surynek/RR1/rev.2/CAD/Auxiliaries/T-hold_mini.FCStd

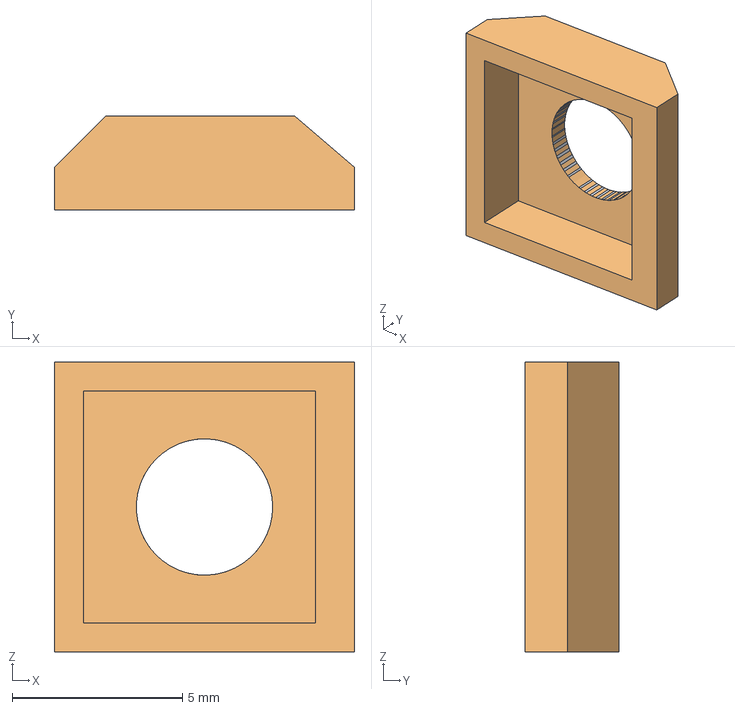
[picture p1: CAD file, 2023-12-17]
rev.2/CAD/Auxiliaries/T-hold_mini.FCStd
8.80 x 2.75 x 8.50 mm
T-hold_mini
T-hold_mini (Meshed)
