surynek/RR1/rev.2/CAD/Base/Base-part-B_seal.FCStd

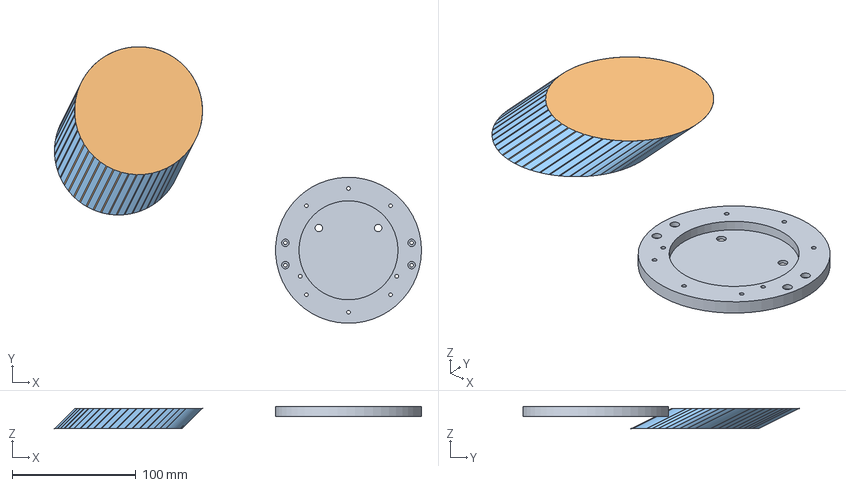
[picture p2: CAD file, 2023-12-17]
rev.2/CAD/Base/Base-part-B_seal.FCStd
296.6 x 223.5 x 18.0 mm
bazovina_part-B_vicko
Extrude (Meshed)
