surynek/RR1/rev.2/CAD/Electric/Real-Box_logo.FCStd

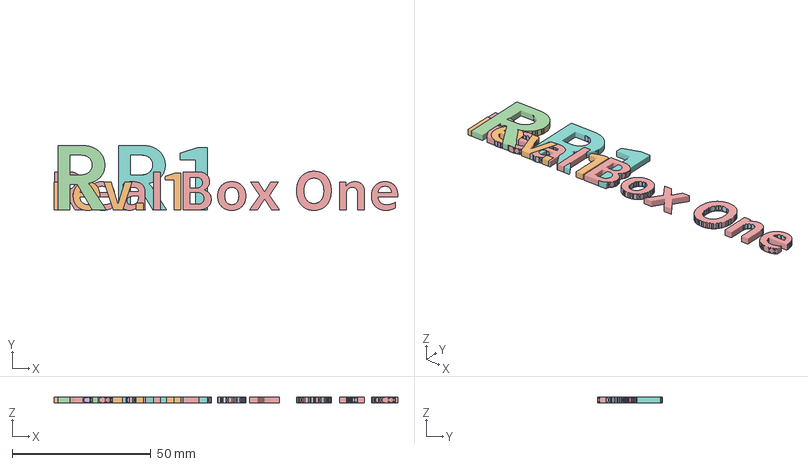
[picture p3: CAD file, 2023-12-17]
rev.2/CAD/Electric/Real-Box_logo.FCStd
124.0 x 23.4 x 2.00 mm
RealBoxOne
rev.1
RR1
R
RealBoxOne (Meshed)
rev.1 (Meshed)
R (Meshed)
RR1 (Meshed)
