surynek/RR1/rev.2/CAD/Gripper/Grip_teeth.FCStd

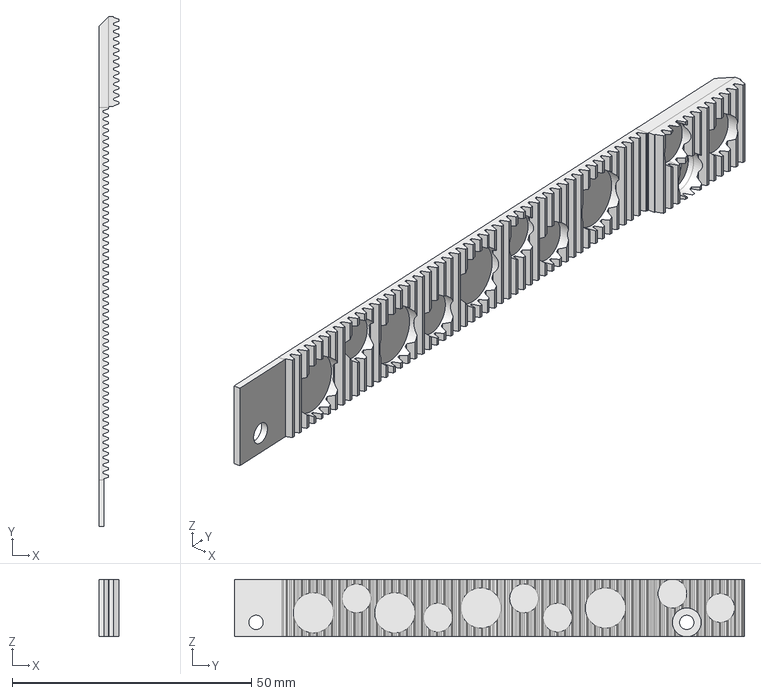
[picture p4: CAD file, 2023-12-17]
rev.2/CAD/Gripper/Grip_teeth.FCStd
4.12 x 106.6 x 12.0 mm
