surynek/RR1/rev.2/CAD/Joint-elbow/G-midi_inner-gear.FCStd

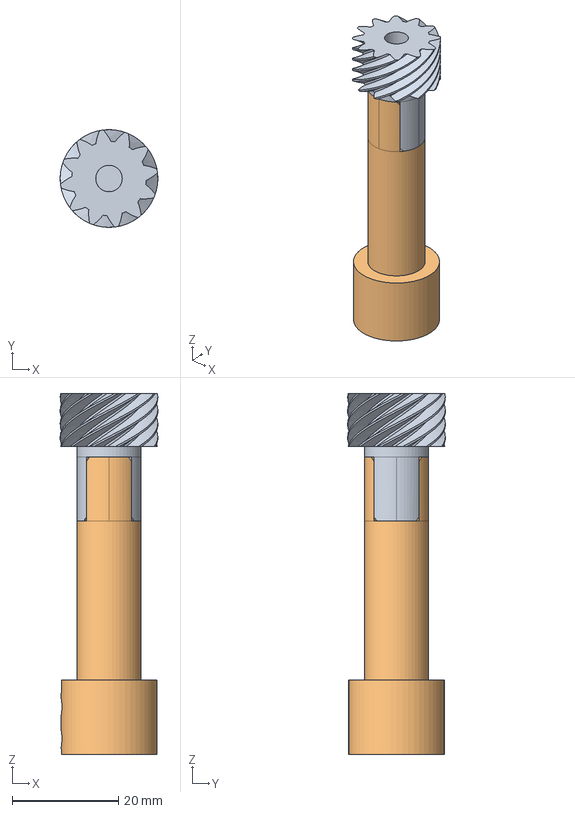
[picture p5: CAD file, 2023-12-17]
rev.2/CAD/Joint-elbow/G-midi_inner-gear.FCStd
18.4 x 18.4 x 68.0 mm
G-midi_inner-gear-part-A
G-midi_inner-gear-part-B_proper-lenght
