surynek/RR1/rev.2/CAD/Wrist/G-mini_encoder-ring.FCStd

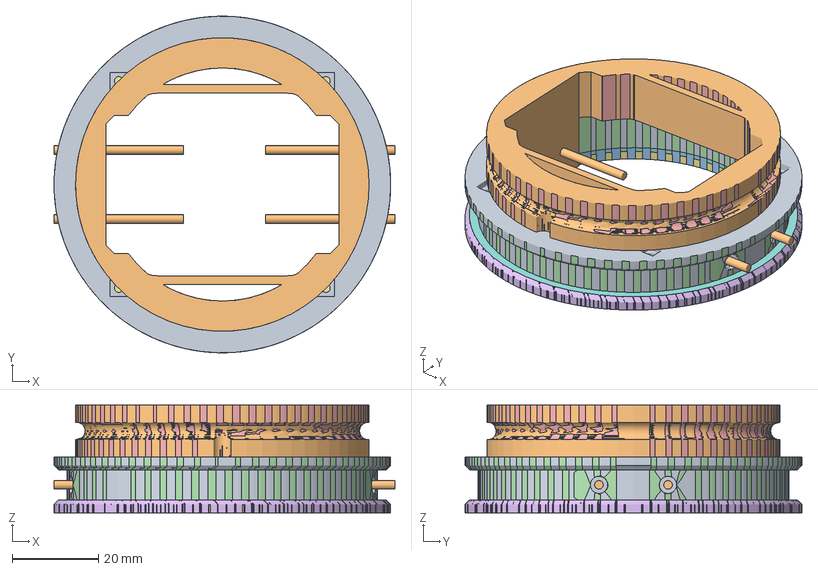
[picture p6: CAD file, 2023-12-17]
rev.2/CAD/Wrist/G-mini_encoder-ring.FCStd
79.0 x 78.0 x 25.0 mm
Wrist_halo-cover
G-mini_encoder-ring-cover
G-mini_encoder-belt-ring
Wrist_inner-halo
G-mini_encoder-ring-cover (Meshed)
Wrist_halo-cover (Meshed)
G-mini_encoder-ring-cover (Meshed)001
G-mini_encoder-belt-ring (Meshed)
Wrist_inner-halo (Meshed)
