surynek/RR1/rev.2/STLs/Base/Base_rear-gear-large-solid.stl

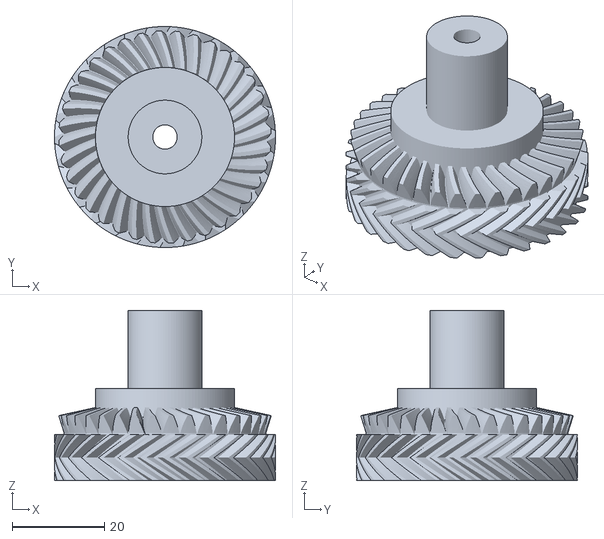
[picture p7: CAD file, 2023-08-20]
rev.2/STLs/Base/Base_rear-gear-large-solid.stl
48.0 x 48.0 x 37.0
