surynek/RR1/rev.2/STLs/Electric/Ele-box_RealRobotONE-cover.stl

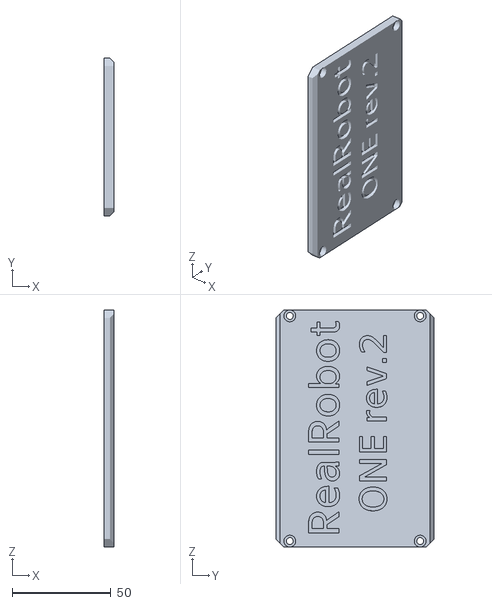
[picture p8: CAD file, 2023-08-21]
rev.2/STLs/Electric/Ele-box_RealRobotONE-cover.stl
5.00 x 80.0 x 120.0
