surynek/RR1/rev.2/STLs/Gripper/Grip_ufo.stl

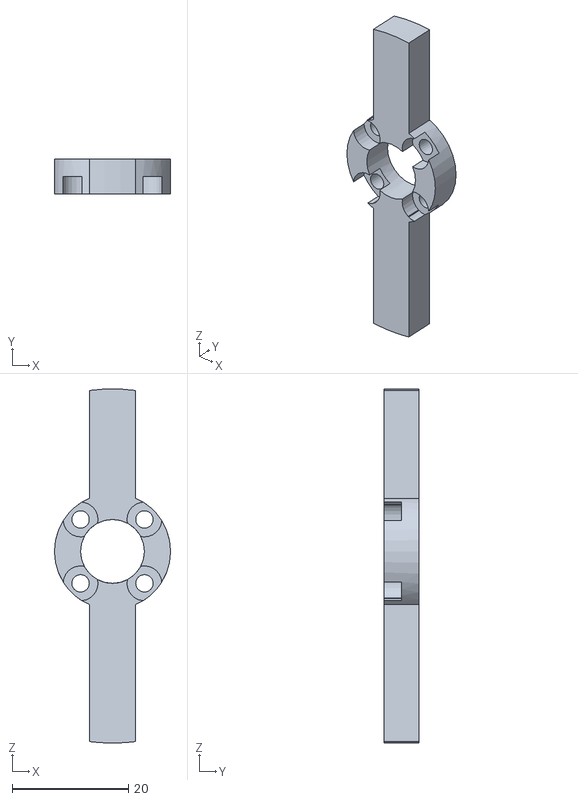
[picture p9: CAD file, 2023-08-21]
rev.2/STLs/Gripper/Grip_ufo.stl
20.0 x 6.00 x 61.0
