surynek/RR1/rev.2/STLs/Joint-elbow/G-midi_bear-hold-encoder-rear.stl

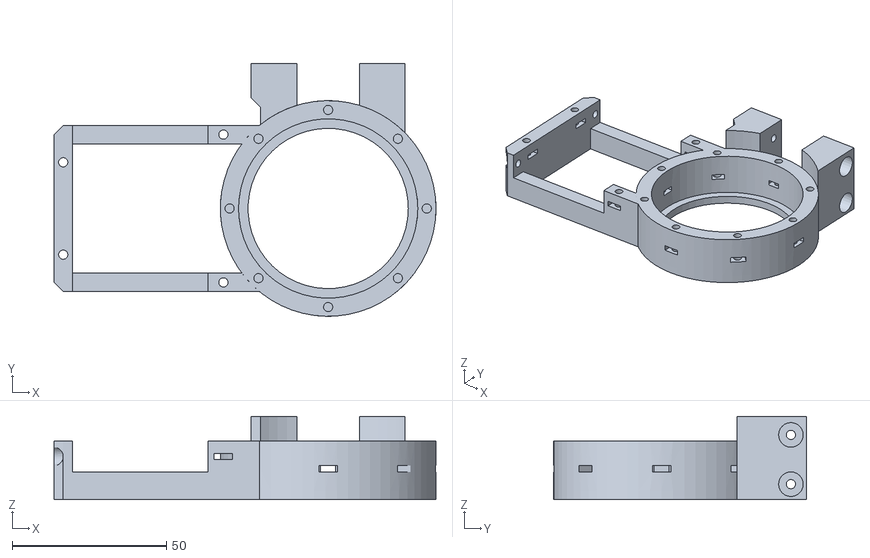
[picture p10: CAD file, 2023-08-21]
rev.2/STLs/Joint-elbow/G-midi_bear-hold-encoder-rear.stl
124.0 x 82.0 x 27.0
