surynek/RR1/rev.2/STLs/Joint-shoulder/J-max_motor-shaft-extended-reinforced.stl

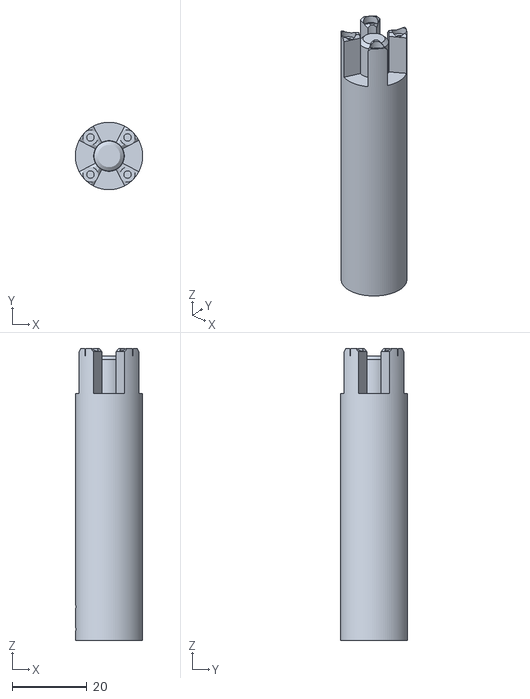
[picture p11: CAD file, 2023-08-20]
rev.2/STLs/Joint-shoulder/J-max_motor-shaft-extended-reinforced.stl
18.0 x 18.0 x 78.0
