surynek/RR1/rev.2/STLs/Link-elbow/L-elb_encoder-uphold.stl

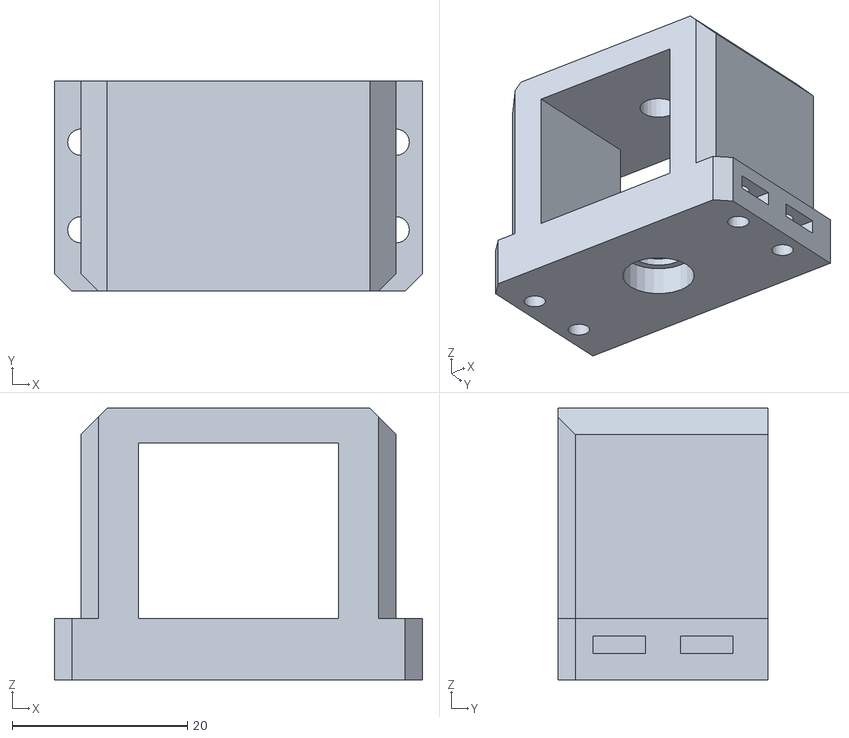
[picture p12: CAD file, 2023-08-21]
rev.2/STLs/Link-elbow/L-elb_encoder-uphold.stl
42.0 x 24.0 x 31.0
