surynek/RR1/rev.2/STLs/Link-upper/T-midi_small-box.stl

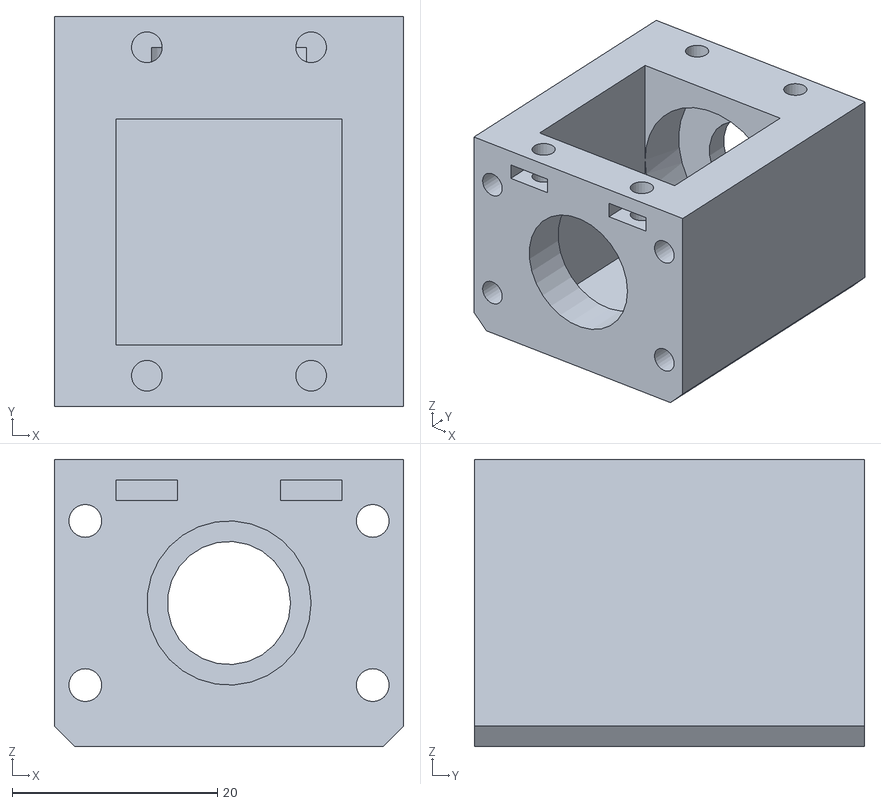
[picture p13: CAD file, 2023-08-20]
rev.2/STLs/Link-upper/T-midi_small-box.stl
34.0 x 38.0 x 28.0
