surynek/RR1/rev.2/STLs/Wrist/G-mini_underfix.stl

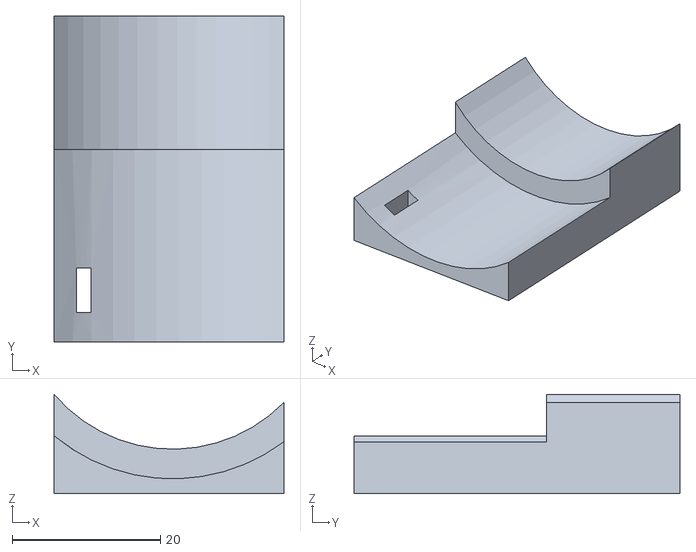
[picture p14: CAD file, 2023-08-21]
rev.2/STLs/Wrist/G-mini_underfix.stl
31.0 x 44.0 x 13.4
