surynek/RR1/rev.2/CAD/Auxiliaries/T-hold_max.FCStd

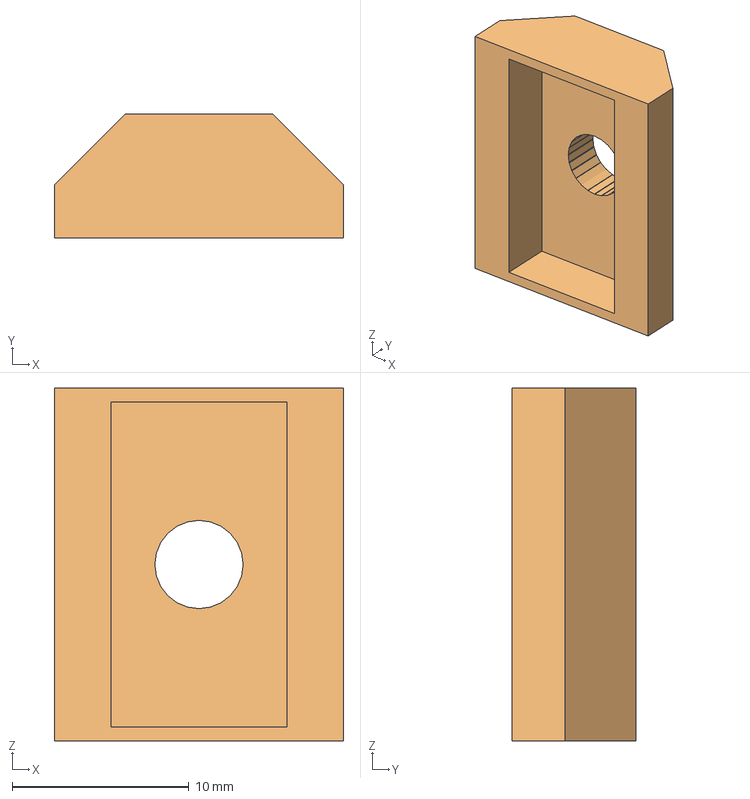
[picture p15: CAD file, 2023-12-17]
rev.2/CAD/Auxiliaries/T-hold_max.FCStd
16.4 x 7.00 x 20.0 mm
T-hold_max
teckovy_bigo_drzacek (Meshed)
T-hold_max (Meshed)
