surynek/RR1/rev.2/CAD/Base/Base-part-J_rear-gearbox-cover.FCStd

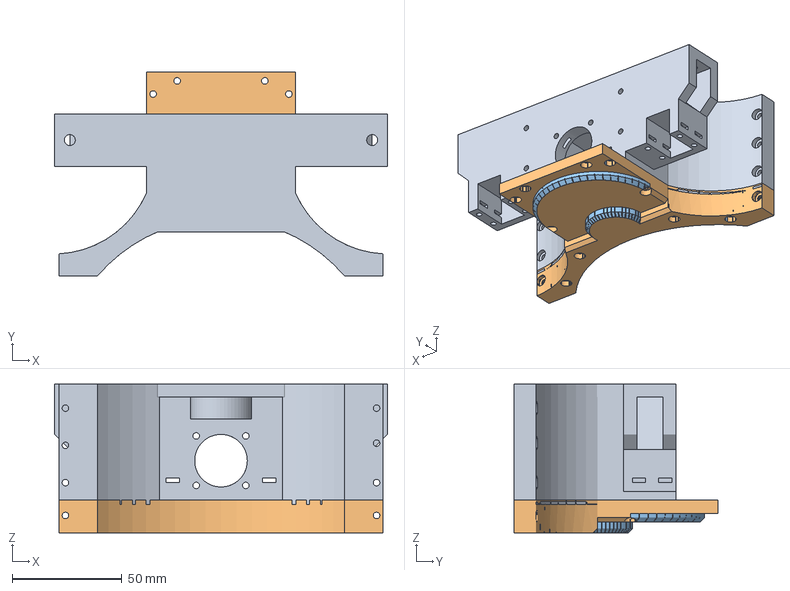
[picture p16: CAD file, 2023-12-17]
rev.2/CAD/Base/Base-part-J_rear-gearbox-cover.FCStd
152.0 x 93.0 x 68.0 mm
Base_rear-gearbox-stabil
Base_rear-gearbox-cover
Base_rear-gearbox-cover (Meshed)
