surynek/RR1/rev.2/CAD/Electric/Gewiss.FCStd

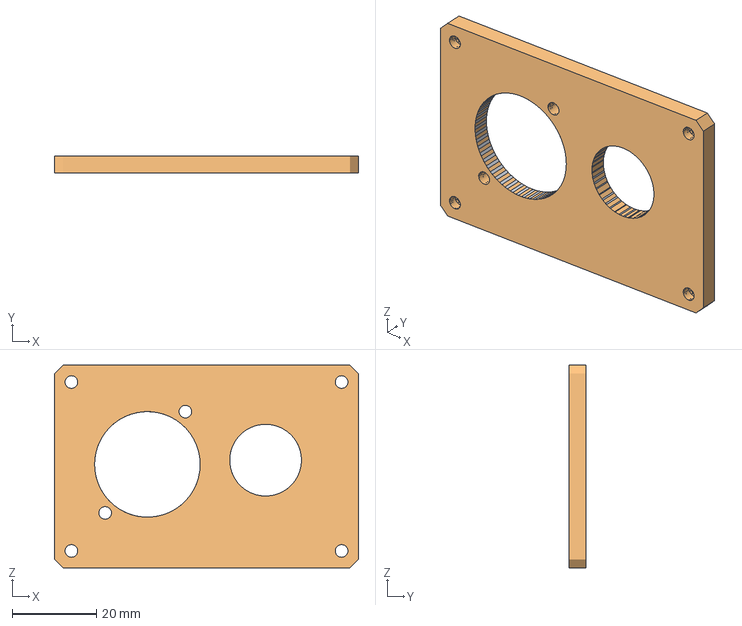
[picture p17: CAD file, 2023-12-17]
rev.2/CAD/Electric/Gewiss.FCStd
72.0 x 4.00 x 48.0 mm
komuno_panel
komuno_panel (Meshed)
