surynek/RR1/rev.2/STLs/Base/Base_rear-gear-small.stl

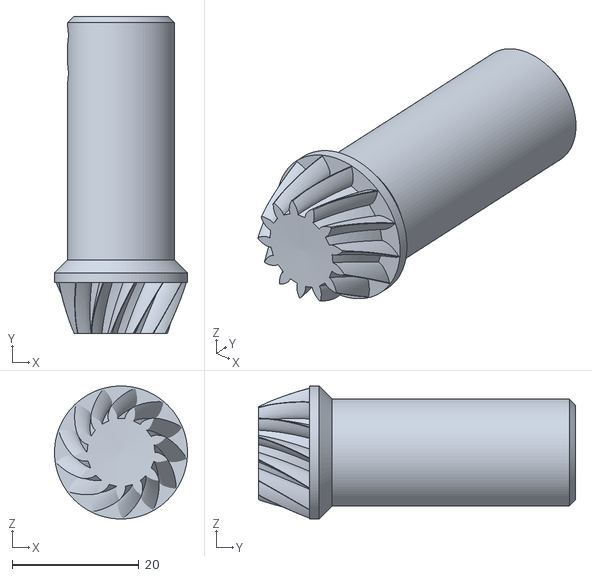
[picture p18: CAD file, 2023-08-20]
rev.2/STLs/Base/Base_rear-gear-small.stl
21.0 x 50.1 x 21.0
