surynek/RR1/rev.2/STLs/Electric/Ele-box_small-cover.stl

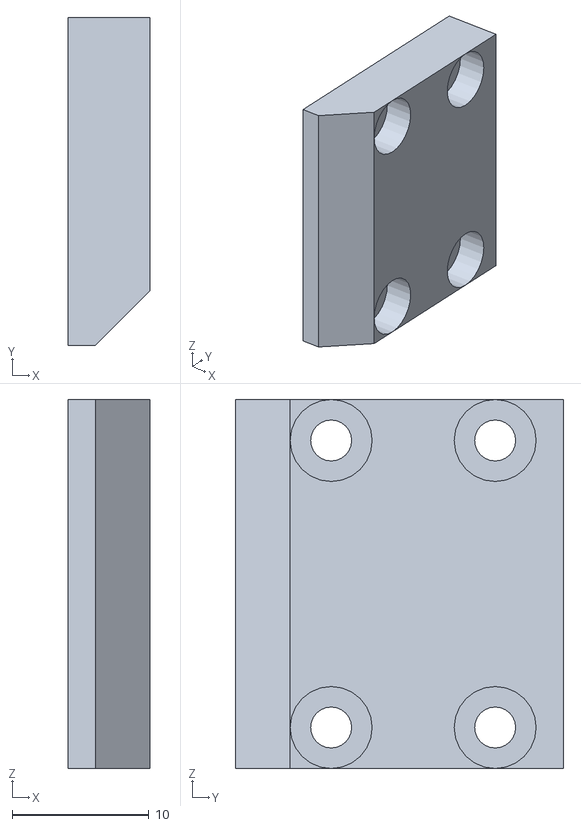
[picture p19: CAD file, 2023-08-21]
rev.2/STLs/Electric/Ele-box_small-cover.stl
6.00 x 24.0 x 27.0
