surynek/RR1/rev.2/STLs/Gripper/Grip_finger-root_lower.stl

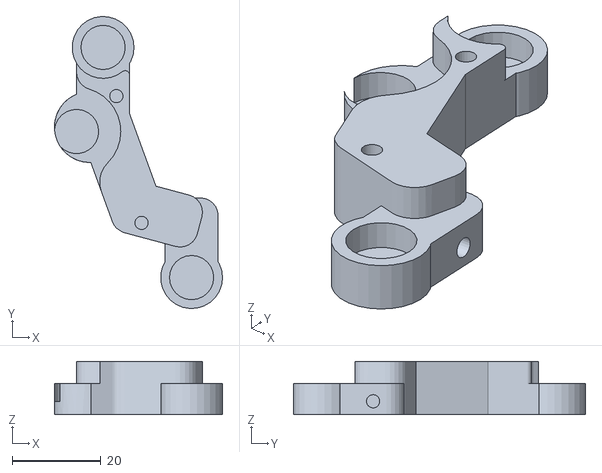
[picture p20: CAD file, 2023-08-21]
rev.2/STLs/Gripper/Grip_finger-root_lower.stl
38.0 x 66.0 x 12.0
