surynek/RR1/rev.2/STLs/Joint-elbow/G-midi_inner-gear-part-B.stl

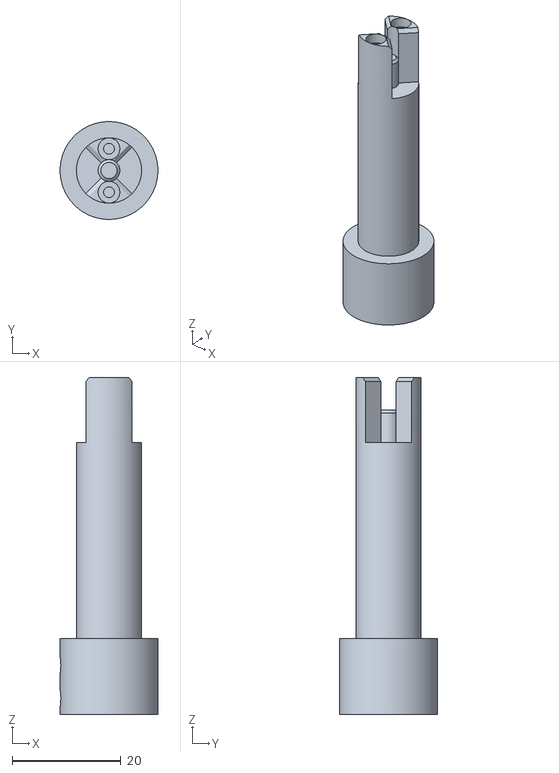
[picture p21: CAD file, 2023-08-21]
rev.2/STLs/Joint-elbow/G-midi_inner-gear-part-B.stl
18.0 x 18.0 x 62.0
