surynek/RR1/rev.2/STLs/Link-elbow/L-elb_encoder-bottomhold.stl

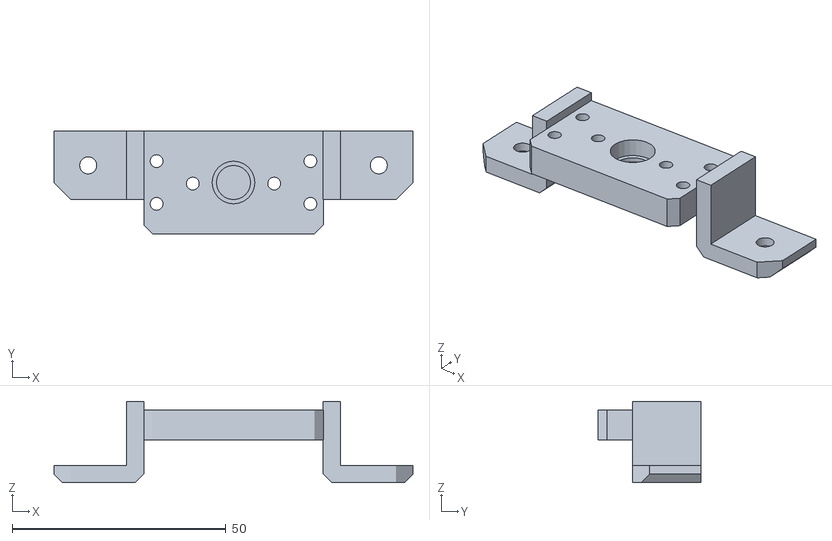
[picture p22: CAD file, 2023-08-21]
rev.2/STLs/Link-elbow/L-elb_encoder-bottomhold.stl
84.0 x 24.0 x 19.0
