surynek/RR1/rev.2/STLs/Link-upper/T-midi-logo_rev.2.stl

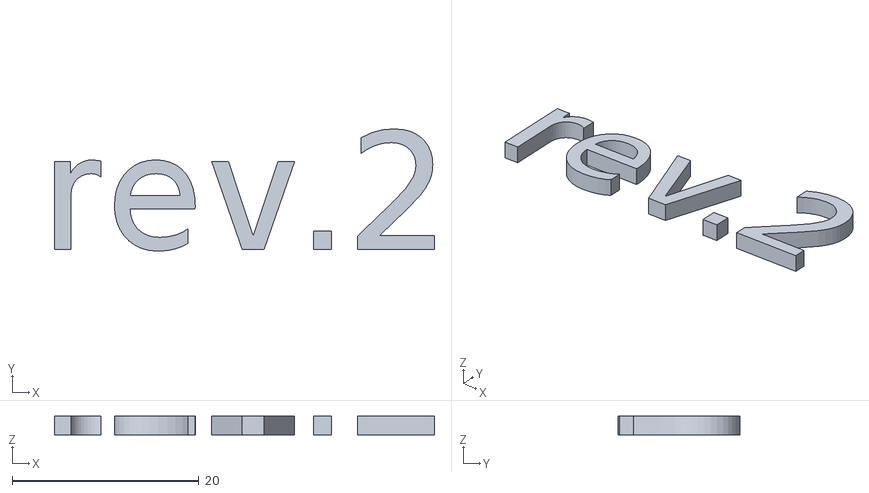
[picture p23: CAD file, 2023-08-20]
rev.2/STLs/Link-upper/T-midi-logo_rev.2.stl
40.7 x 13.1 x 2.00
