surynek/RR1/rev.2/STLs/Wrist/G-mini_inner-gear-part-B.stl

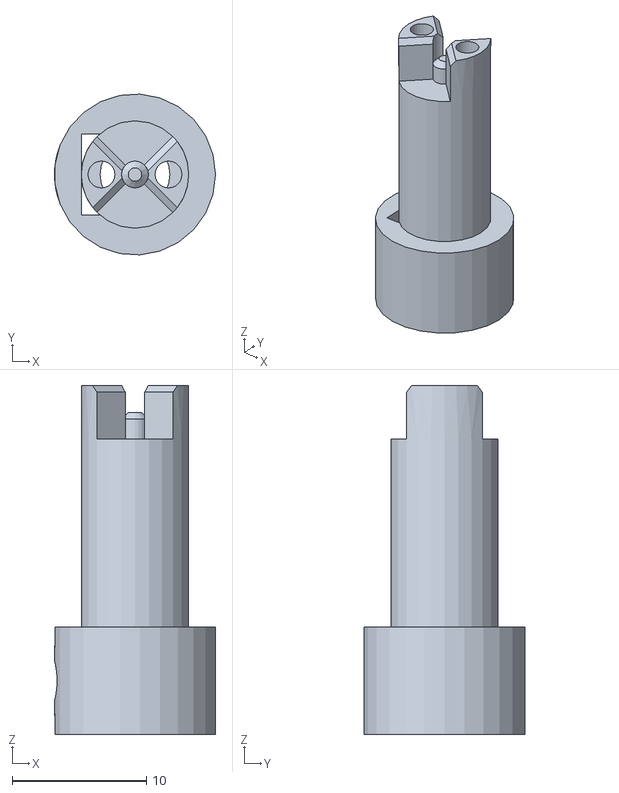
[picture p24: CAD file, 2023-08-21]
rev.2/STLs/Wrist/G-mini_inner-gear-part-B.stl
12.0 x 12.0 x 26.0
