surynek/RR1/rev.2/CAD/Auxiliaries/T-hold_midi.FCStd

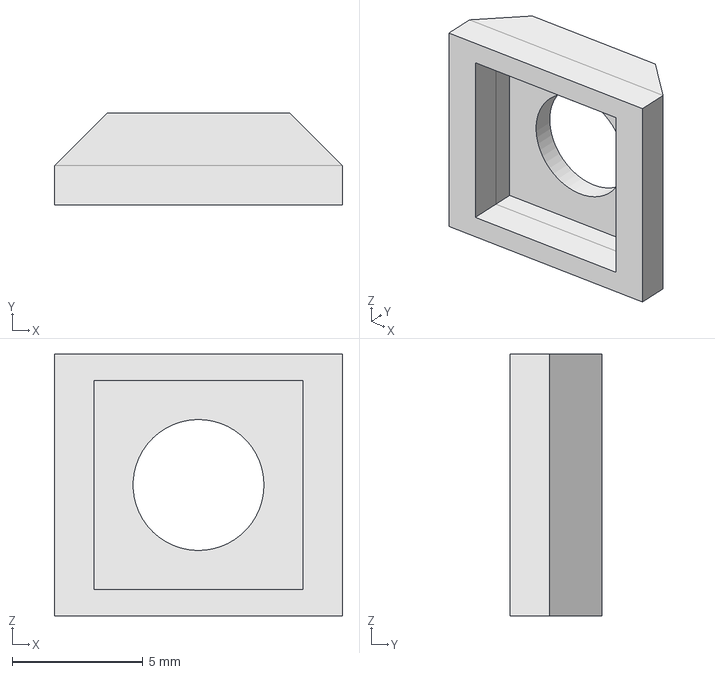
[picture p25: CAD file, 2023-12-17]
rev.2/CAD/Auxiliaries/T-hold_midi.FCStd
11.0 x 3.50 x 10.0 mm
