surynek/RR1/rev.2/CAD/Base/Base-part-G_seal.FCStd

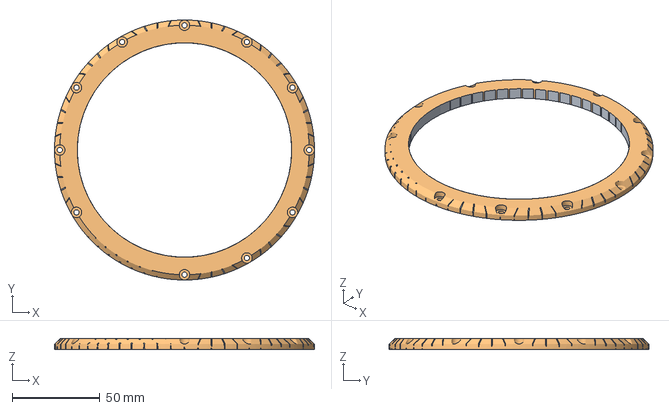
[picture p26: CAD file, 2023-12-17]
rev.2/CAD/Base/Base-part-G_seal.FCStd
148.0 x 148.0 x 6.00 mm
bazovina_part-G_seal
bazovina_part-G_seal (Meshed)
