surynek/RR1/rev.2/STLs/Base/Base_encoder-bottomhold.stl

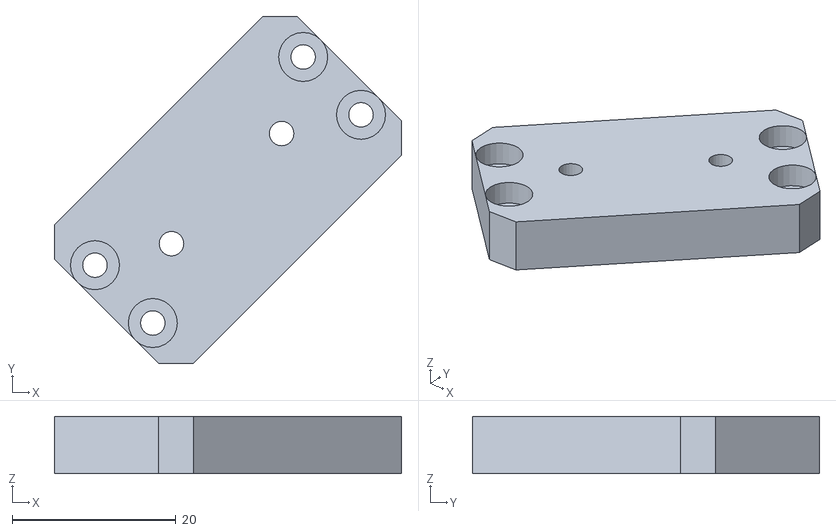
[picture p27: CAD file, 2023-08-20]
rev.2/STLs/Base/Base_encoder-bottomhold.stl
42.4 x 42.4 x 7.00
