surynek/RR1/rev.2/STLs/Electric/Ele-box_big-hold.stl

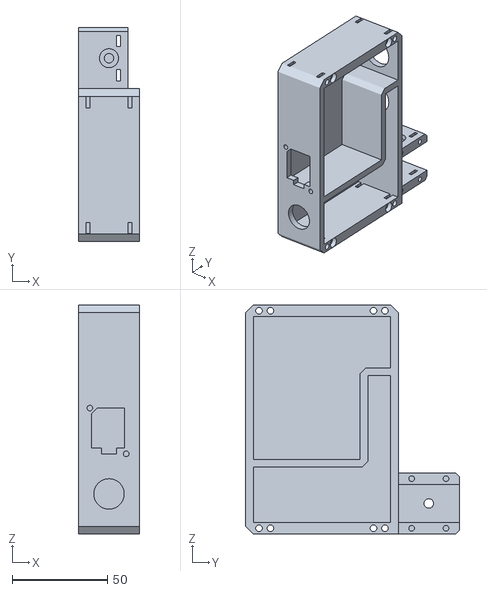
[picture p28: CAD file, 2023-08-21]
rev.2/STLs/Electric/Ele-box_big-hold.stl
32.0 x 112.0 x 120.0
