surynek/RR1/rev.2/STLs/Joint-elbow/G-midi_extrusion-cover-supershift.stl

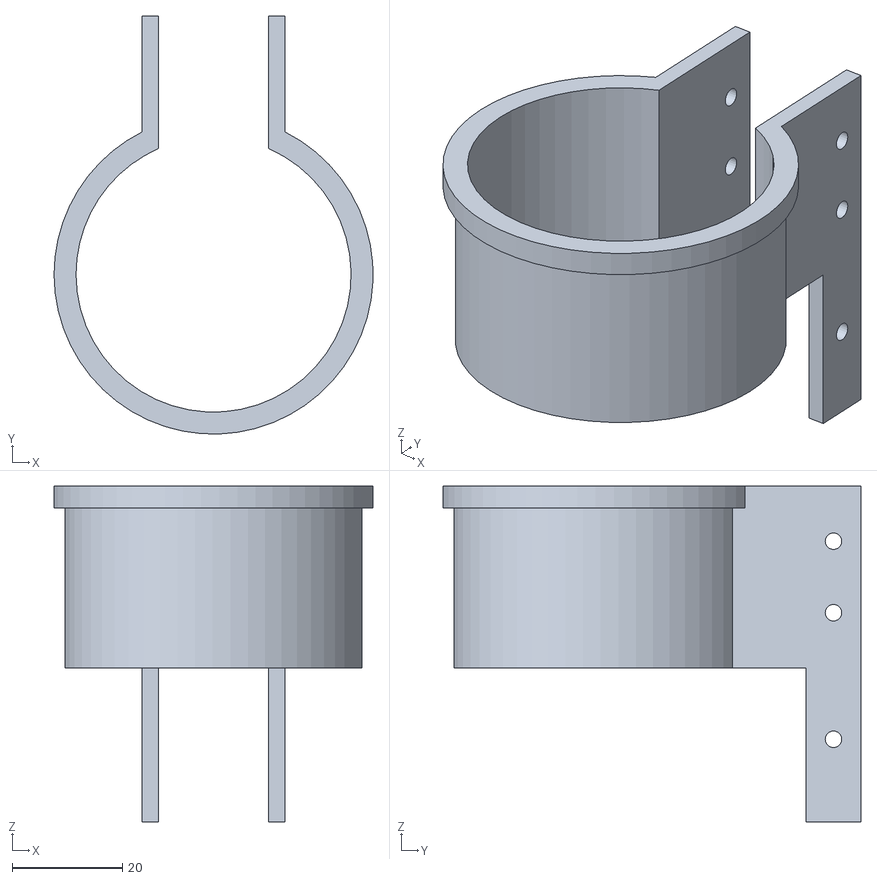
[picture p29: CAD file, 2023-08-21]
rev.2/STLs/Joint-elbow/G-midi_extrusion-cover-supershift.stl
58.0 x 76.0 x 61.0
