surynek/RR1/rev.2/STLs/Joint-shoulder/J-max_encoder-inhold.stl

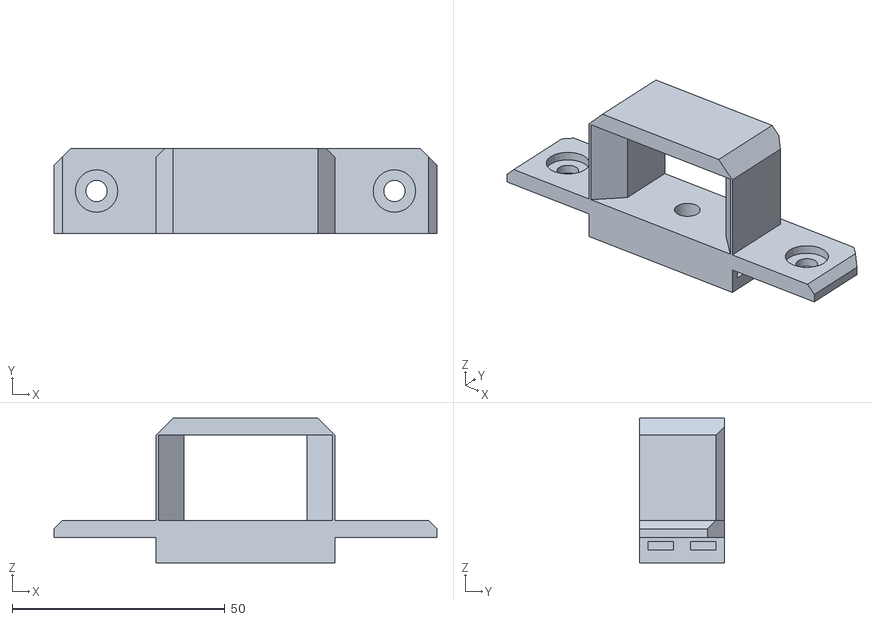
[picture p30: CAD file, 2023-08-20]
rev.2/STLs/Joint-shoulder/J-max_encoder-inhold.stl
90.0 x 20.0 x 34.0
