surynek/RR1/rev.2/STLs/Link-elbow/L-elb_major-conno-moto.stl

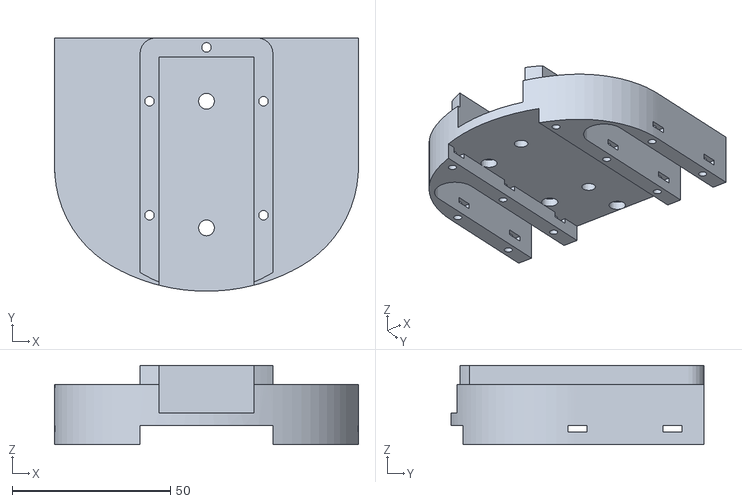
[picture p31: CAD file, 2023-08-21]
rev.2/STLs/Link-elbow/L-elb_major-conno-moto.stl
96.0 x 80.0 x 25.0
