surynek/RR1/rev.2/STLs/Link-upper/T-midi_small-gear-lower-shaft.stl

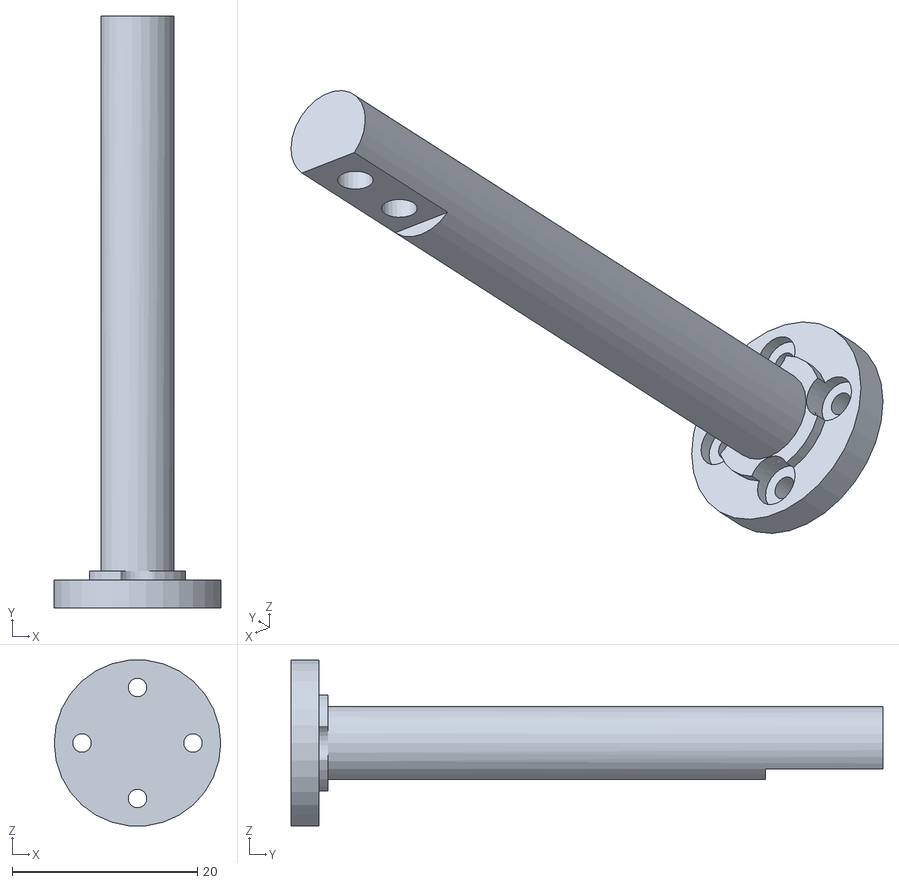
[picture p32: CAD file, 2023-08-20]
rev.2/STLs/Link-upper/T-midi_small-gear-lower-shaft.stl
18.0 x 64.0 x 17.9
