surynek/RR1/rev.2/STLs/Wrist/G-mini_inner-gear-part-A-short.stl

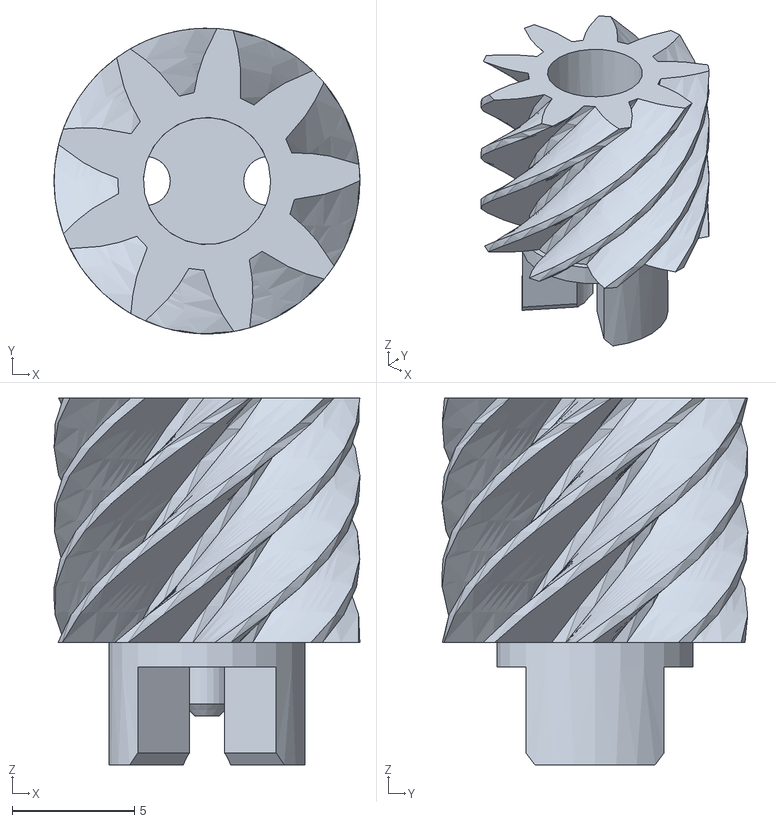
[picture p33: CAD file, 2023-08-21]
rev.2/STLs/Wrist/G-mini_inner-gear-part-A-short.stl
12.5 x 12.5 x 15.0
