surynek/RR1/rev.2/CAD/Base/Base_turret-w-hole.FCStd

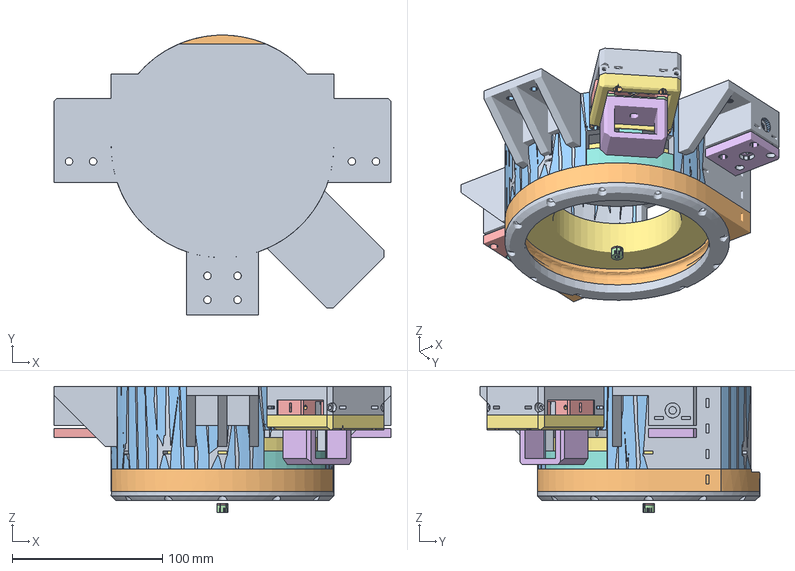
[picture p34: CAD file, 2023-12-17]
rev.2/CAD/Base/Base_turret-w-hole.FCStd
224.0 x 186.0 x 84.0 mm
bazovina_part-G_seal
bazovina_part-E_lozo-okruh-novo
Base_encoder-uphold
Base_encoder-bottomhold
Base_encoder-sidehold
Base_encoder-lowhold
Base_encoder-tophold
Base_pulley-cover
Base_turret-hole
Base_encoder-washer
Base_under-pulley_washer_A
Base_under-pulley_washer_B
Base_under-pulley_washer_C
Base_under-pulley_washer_D
ZKL-6017
Base_stabil-cover-left
Base_stabil-cover-right
Base_under-pulley_washer_A (Meshed)
Base_under-pulley_washer_B (Meshed)
Base_under-pulley_washer_C (Meshed)
Base_under-pulley_washer_D (Meshed)
Base_encoder-uphold (Meshed)001
Base_encoder-bottomhold (Meshed)001
Base_encoder-sidehold (Meshed)001
Base_encoder-lowhold (Meshed)001
Base_encoder-tophold (Meshed)001
Base_turret-hole (Meshed)001
Base_encoder-washer (Meshed)001
Base-stabil-cover-left (Meshed)
Base-stabil-cover-right (Meshed)
Base_encoder-washer (Meshed)002
Base_encoder-uphold (Meshed)002
Base_encoder-bottomhold (Meshed)002
Base_encoder-sidehold (Meshed)002
Base_encoder-washer (Meshed)003
