surynek/RR1/rev.2/STLs/Base/Base_neck-foreshift.stl

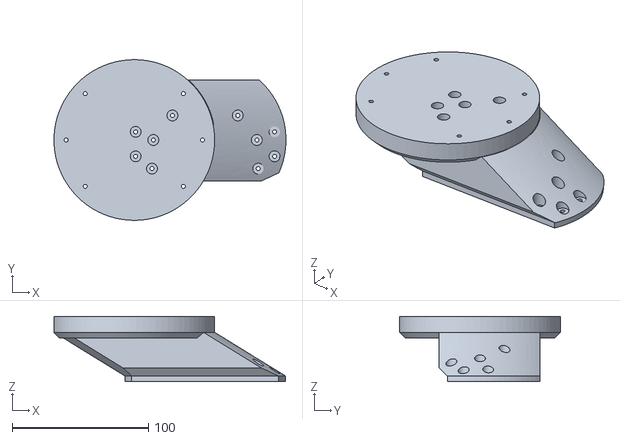
[picture p35: CAD file, 2023-08-20]
rev.2/STLs/Base/Base_neck-foreshift.stl
170.3 x 118.0 x 48.0
