surynek/RR1/rev.2/STLs/Electric/Ele-box_big-cover.stl

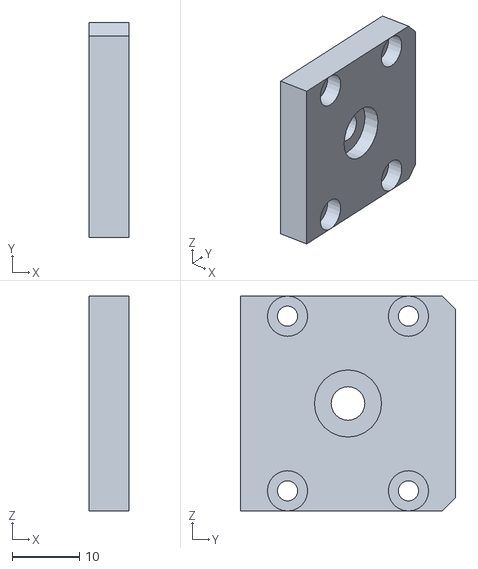
[picture p36: CAD file, 2023-08-21]
rev.2/STLs/Electric/Ele-box_big-cover.stl
6.00 x 32.0 x 32.0
