surynek/RR1/rev.2/STLs/Gripper/Wrist_root-fix.stl

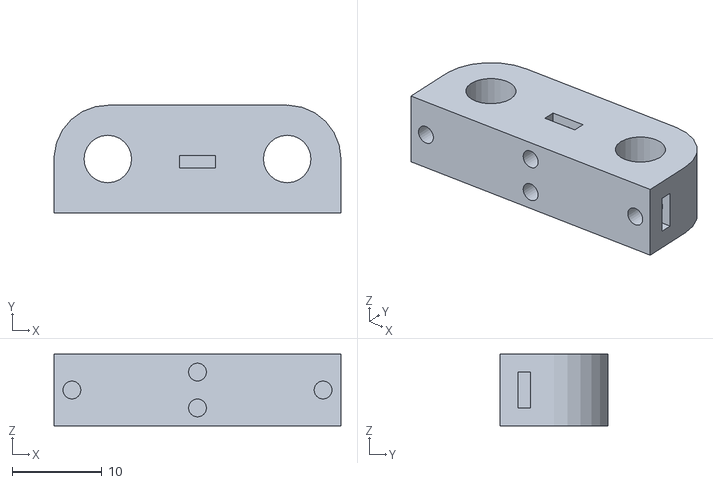
[picture p37: CAD file, 2023-08-21]
rev.2/STLs/Gripper/Wrist_root-fix.stl
32.0 x 12.0 x 8.00
