surynek/RR1/rev.2/STLs/Joint-elbow/G-midi_outer-gear.stl

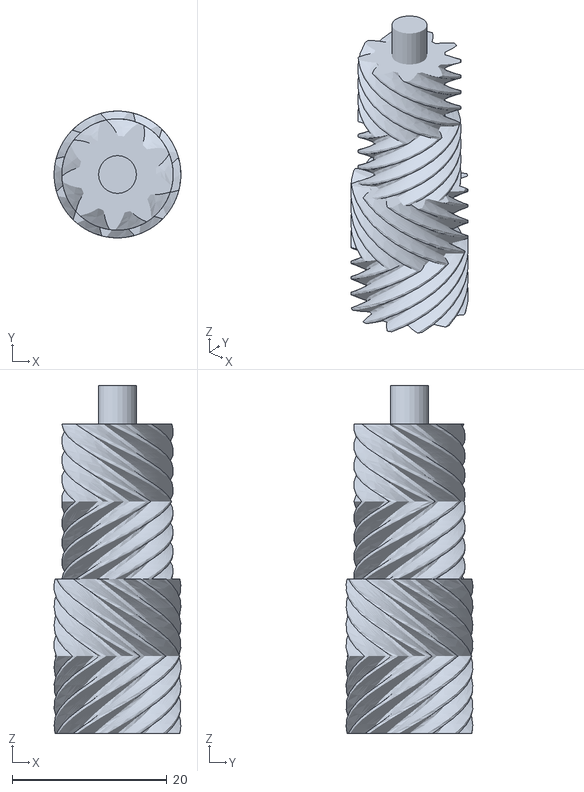
[picture p38: CAD file, 2023-08-21]
rev.2/STLs/Joint-elbow/G-midi_outer-gear.stl
16.4 x 16.4 x 45.0
