surynek/RR1/rev.2/STLs/Joint-shoulder/J-max_moto-clutch.stl

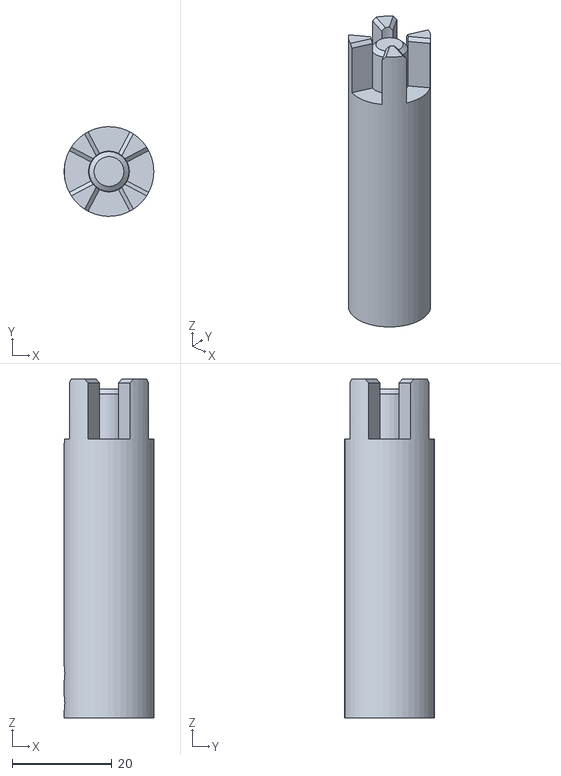
[picture p39: CAD file, 2023-08-20]
rev.2/STLs/Joint-shoulder/J-max_moto-clutch.stl
18.0 x 18.0 x 68.0
