surynek/RR1/rev.2/STLs/Link-elbow/J-mini_gearbox-cage-A.stl

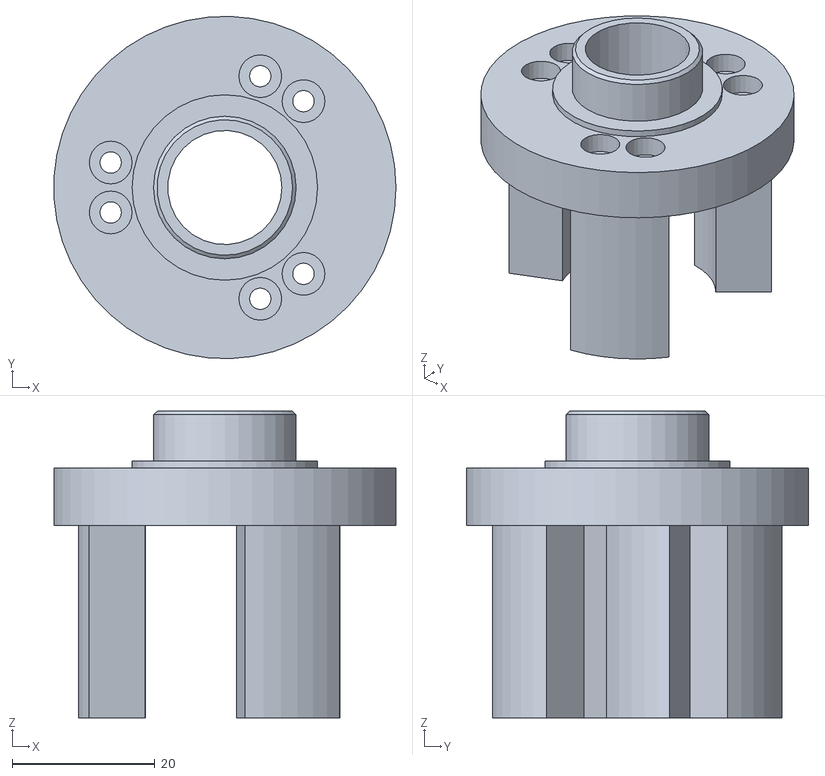
[picture p40: CAD file, 2023-08-21]
rev.2/STLs/Link-elbow/J-mini_gearbox-cage-A.stl
48.0 x 48.0 x 43.0
