surynek/RR1/rev.2/STLs/Link-upper/T-midi_small-gear-upper.stl

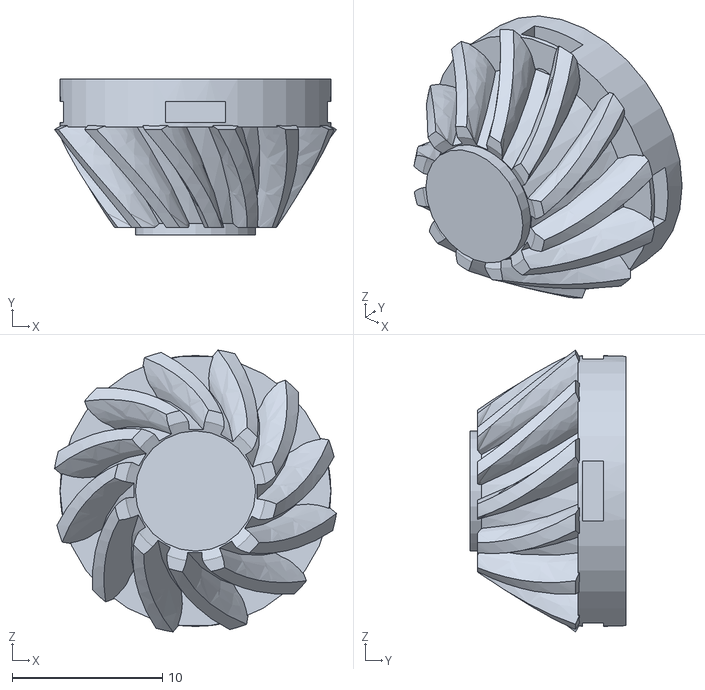
[picture p41: CAD file, 2023-08-20]
rev.2/STLs/Link-upper/T-midi_small-gear-upper.stl
18.7 x 10.4 x 18.7
