surynek/RR1/rev.2/STLs/Wrist/G-mini_encoder-ring-cover.stl

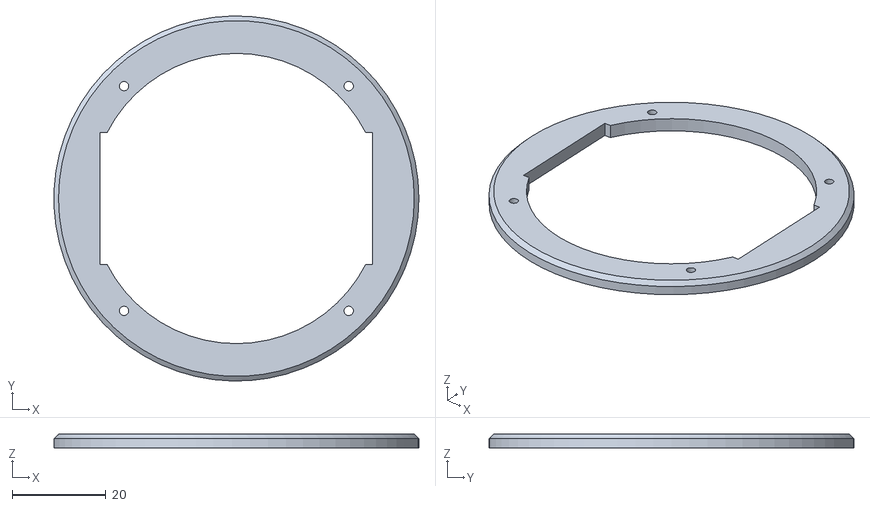
[picture p42: CAD file, 2023-08-21]
rev.2/STLs/Wrist/G-mini_encoder-ring-cover.stl
78.0 x 78.0 x 3.00
