surynek/RR1/rev.2/CAD/Base/Base-part-C_bearing-ring.FCStd

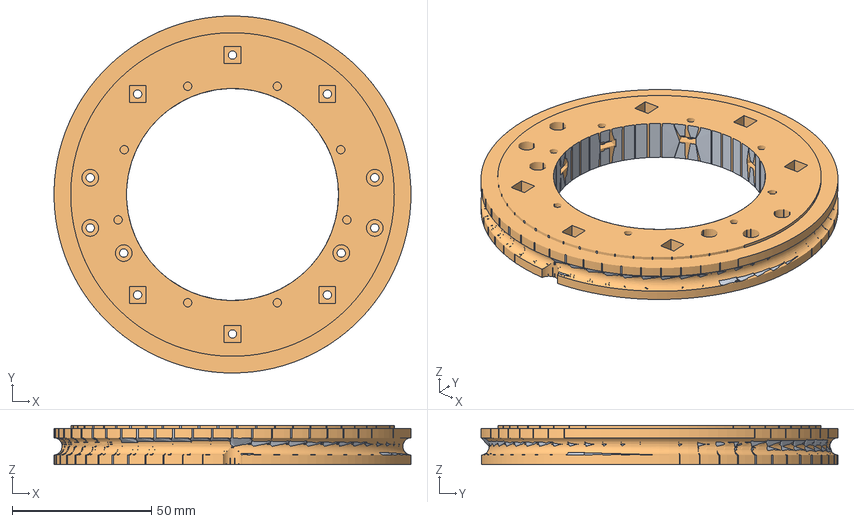
[picture p43: CAD file, 2023-12-17]
rev.2/CAD/Base/Base-part-C_bearing-ring.FCStd
128.0 x 128.0 x 14.0 mm
bazovina-part-C_loziskovina
bazovina-part-C_loziskovina (Meshed)
