surynek/RR1/rev.2/STLs/Electric/Ele-box_standalone-standard.stl

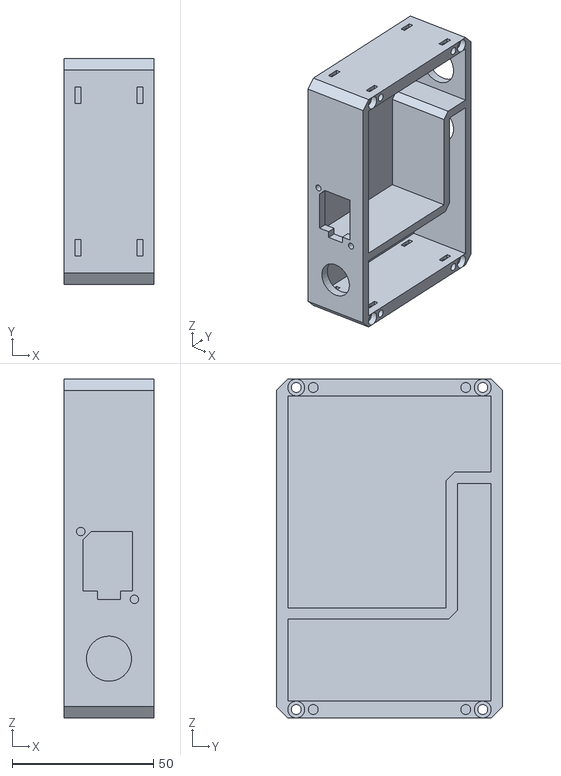
[picture p44: CAD file, 2023-08-21]
rev.2/STLs/Electric/Ele-box_standalone-standard.stl
32.0 x 80.0 x 120.0
