surynek/RR1/rev.2/STLs/Gripper/Grip_finger-tip_upper.stl

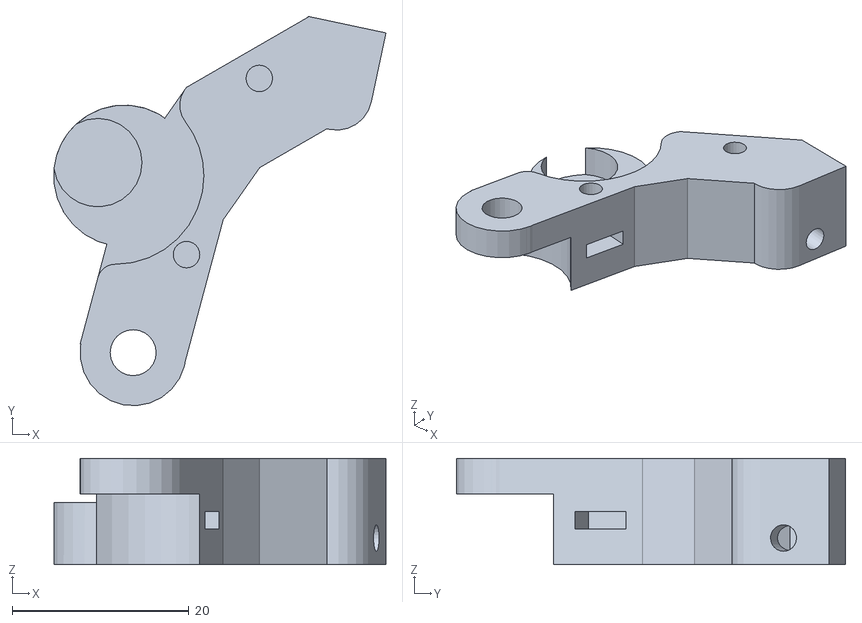
[picture p45: CAD file, 2023-08-21]
rev.2/STLs/Gripper/Grip_finger-tip_upper.stl
37.6 x 44.0 x 12.0
