surynek/RR1/rev.2/STLs/Joint-elbow/G-midi_bearing-ring-centric-lax.stl

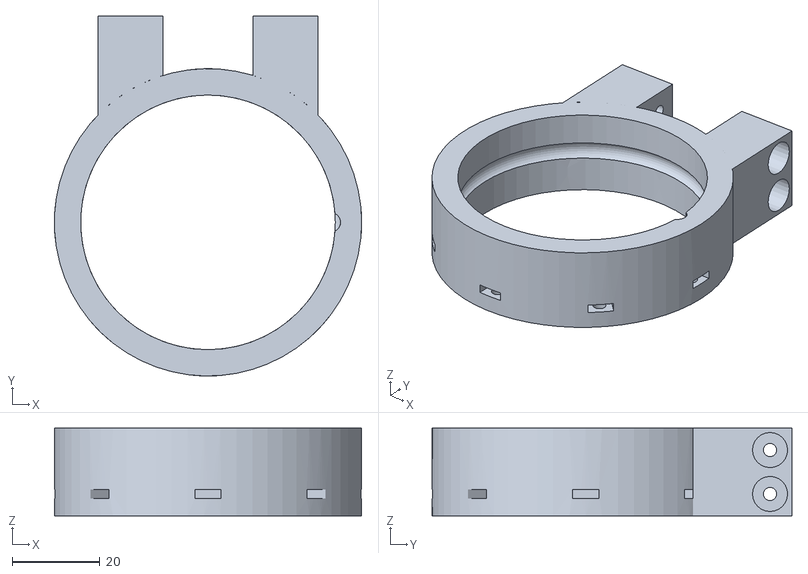
[picture p46: CAD file, 2023-08-21]
rev.2/STLs/Joint-elbow/G-midi_bearing-ring-centric-lax.stl
70.0 x 82.0 x 20.0
