surynek/RR1/rev.2/STLs/Joint-shoulder/J-max_encoder-sidehold.stl

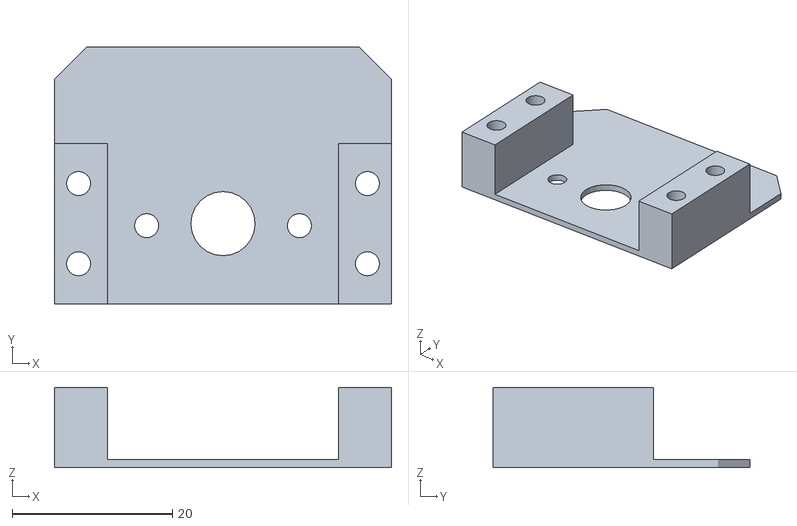
[picture p47: CAD file, 2023-08-20]
rev.2/STLs/Joint-shoulder/J-max_encoder-sidehold.stl
42.0 x 32.0 x 10.0
