surynek/RR1/rev.2/STLs/Link-elbow/T-mini_box-cover.stl

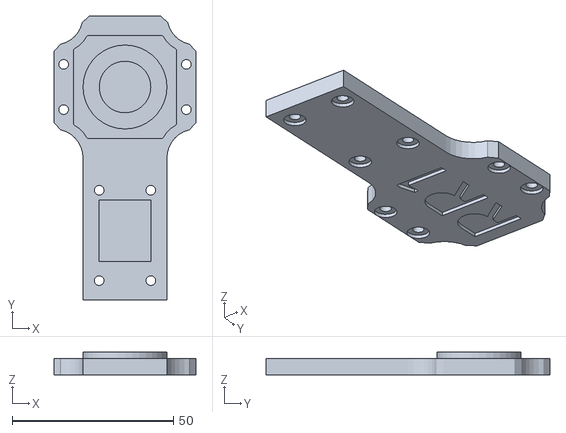
[picture p48: CAD file, 2023-08-21]
rev.2/STLs/Link-elbow/T-mini_box-cover.stl
44.0 x 88.0 x 7.00
