surynek/RR1/rev.2/STLs/Link-upper/T-midi_box-cover-rev.stl

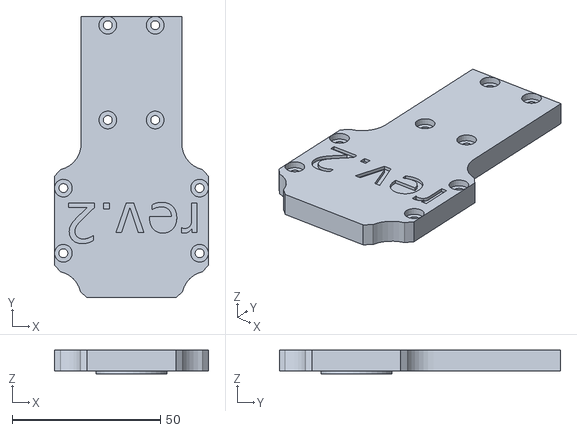
[picture p49: CAD file, 2023-08-20]
rev.2/STLs/Link-upper/T-midi_box-cover-rev.stl
52.0 x 95.0 x 8.00
