surynek/RR1/rev.2/STLs/Wrist/G-mini_outer-gear.stl

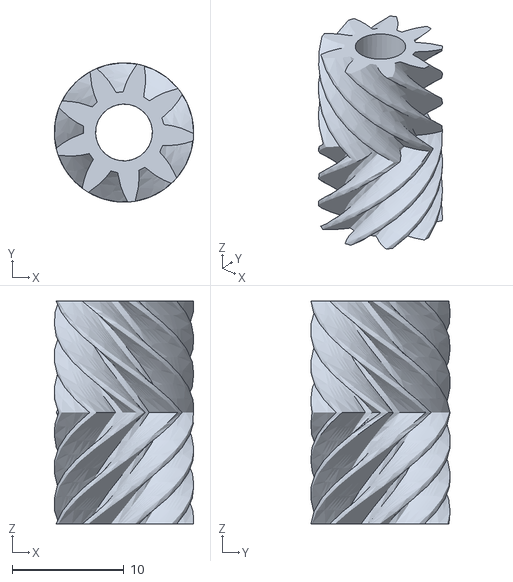
[picture p50: CAD file, 2023-08-21]
rev.2/STLs/Wrist/G-mini_outer-gear.stl
12.5 x 12.5 x 20.0
