surynek/RR1/rev.2/CAD/Base/Base-part-E_big-bearing.FCStd

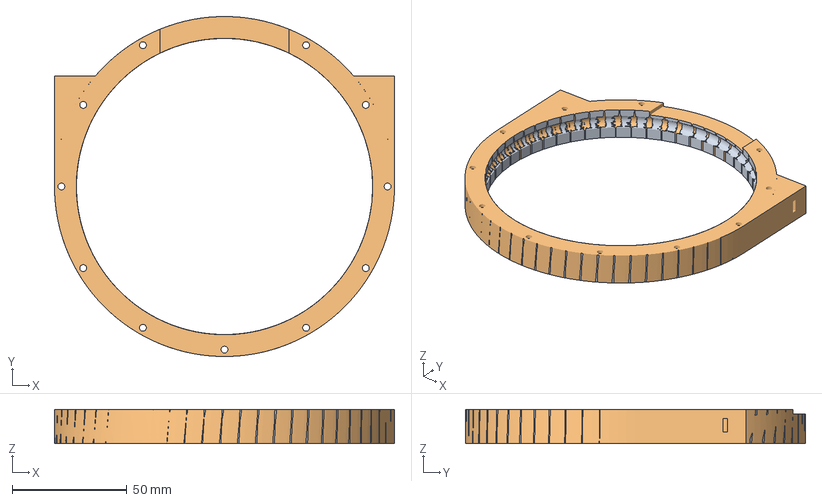
[picture p51: CAD file, 2023-12-17]
rev.2/CAD/Base/Base-part-E_big-bearing.FCStd
148.0 x 148.0 x 15.0 mm
bazovina_part-E_lozo-okruh-novo
bazovina_part-E_lozo-okruh-novo (Meshed)
