surynek/RR1/rev.2/STLs/Base/Base_encoder-uphold.stl

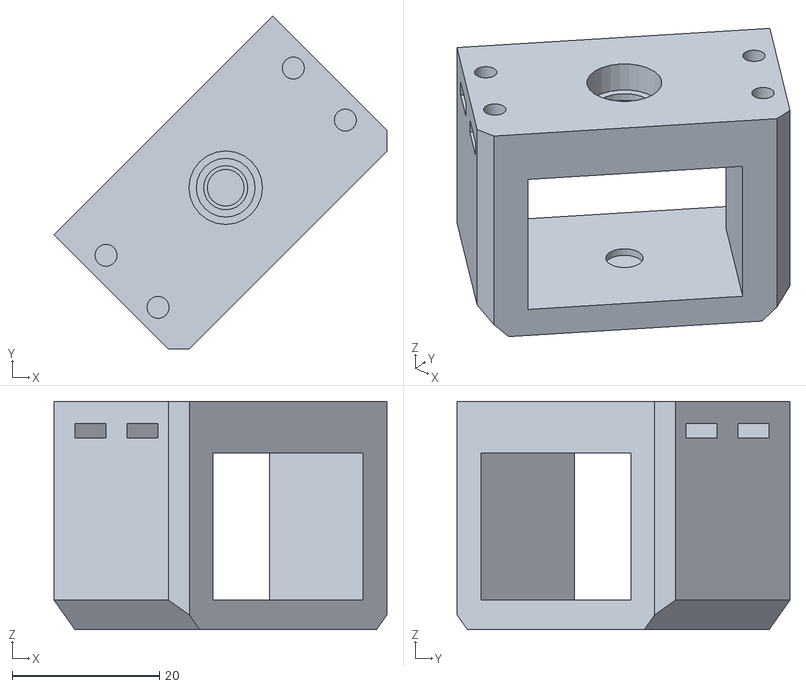
[picture p52: CAD file, 2023-08-20]
rev.2/STLs/Base/Base_encoder-uphold.stl
45.3 x 45.3 x 31.0
