surynek/RR1/rev.2/STLs/Electric/Ele-box_small-hold-opposite.stl

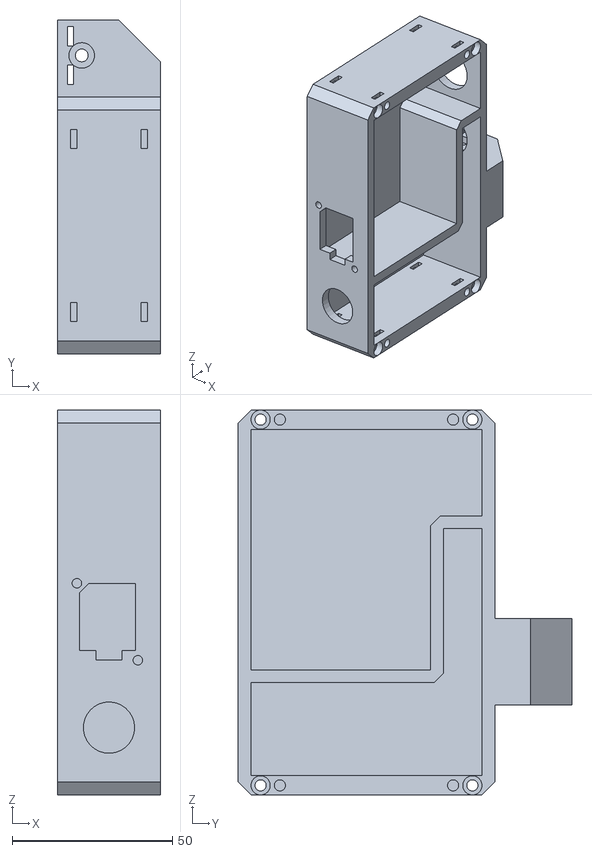
[picture p53: CAD file, 2023-08-21]
rev.2/STLs/Electric/Ele-box_small-hold-opposite.stl
32.0 x 104.0 x 120.0
