surynek/RR1/rev.2/STLs/Joint-elbow/G-midi_motohold.stl

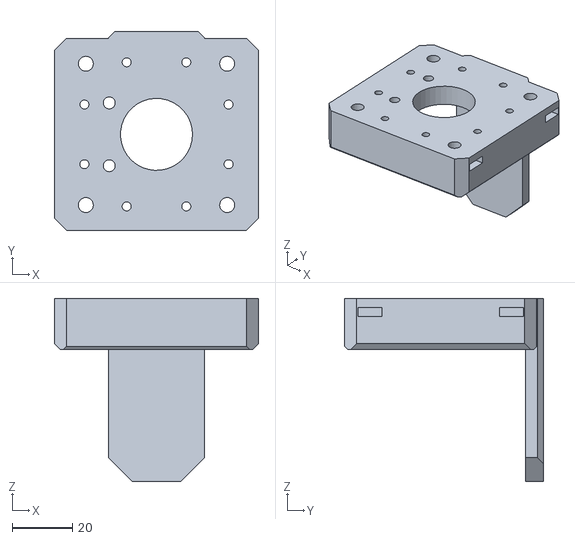
[picture p55: CAD file, 2023-08-21]
rev.2/STLs/Joint-elbow/G-midi_motohold.stl
68.0 x 66.2 x 61.0
