surynek/RR1/rev.2/STLs/Joint-shoulder/J-max_motor-holder.stl

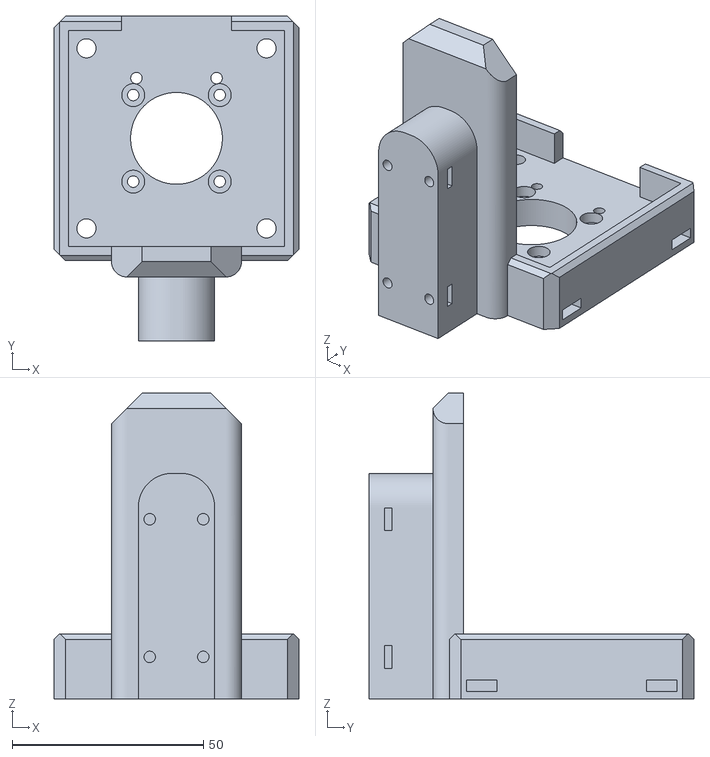
[picture p56: CAD file, 2023-08-20]
rev.2/STLs/Joint-shoulder/J-max_motor-holder.stl
64.0 x 85.0 x 80.0
