surynek/RR1/rev.2/STLs/Link-elbow/T-mini_big-gear-lower-shaft-nuovo.stl

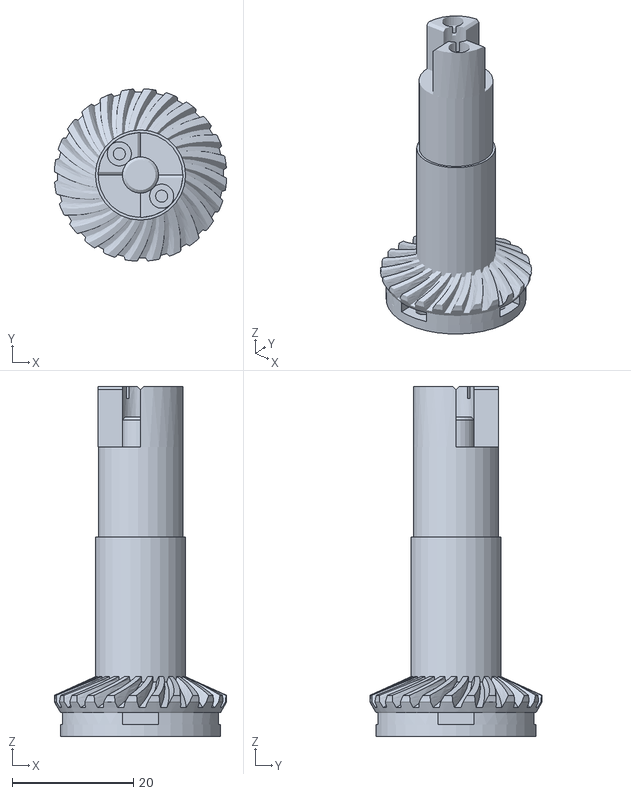
[picture p57: CAD file, 2023-08-21]
rev.2/STLs/Link-elbow/T-mini_big-gear-lower-shaft-nuovo.stl
28.5 x 28.5 x 57.8
