surynek/RR1/rev.2/STLs/Link-upper/T-midi_big-gear-lower-hollow-shaft.stl

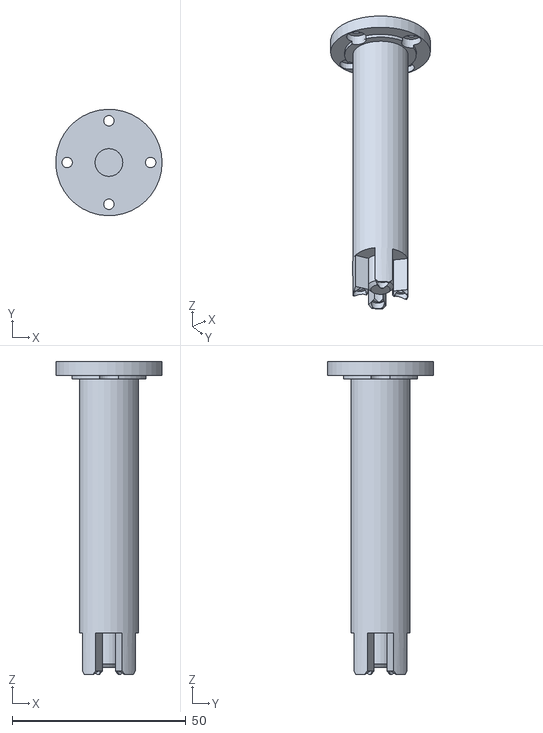
[picture p58: CAD file, 2023-08-20]
rev.2/STLs/Link-upper/T-midi_big-gear-lower-hollow-shaft.stl
30.6 x 30.6 x 90.0
