surynek/RR1/rev.2/STLs/Wrist/G-mini_monoblock-m1.2.stl

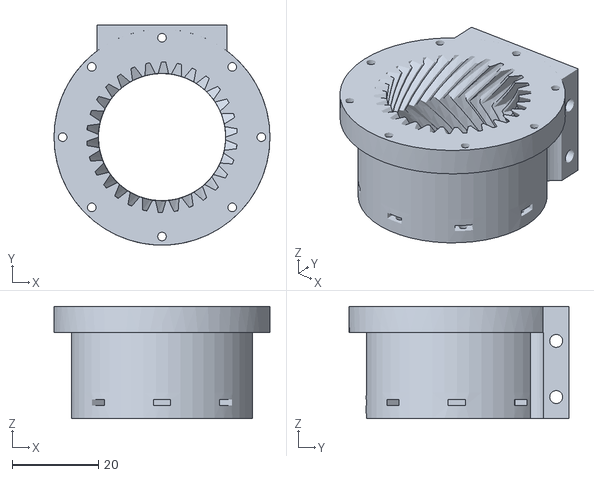
[picture p59: CAD file, 2023-08-21]
rev.2/STLs/Wrist/G-mini_monoblock-m1.2.stl
50.0 x 51.0 x 26.0
