surynek/RR1/rev.2/CAD/Base/Base-part-K-moto-hold.FCStd

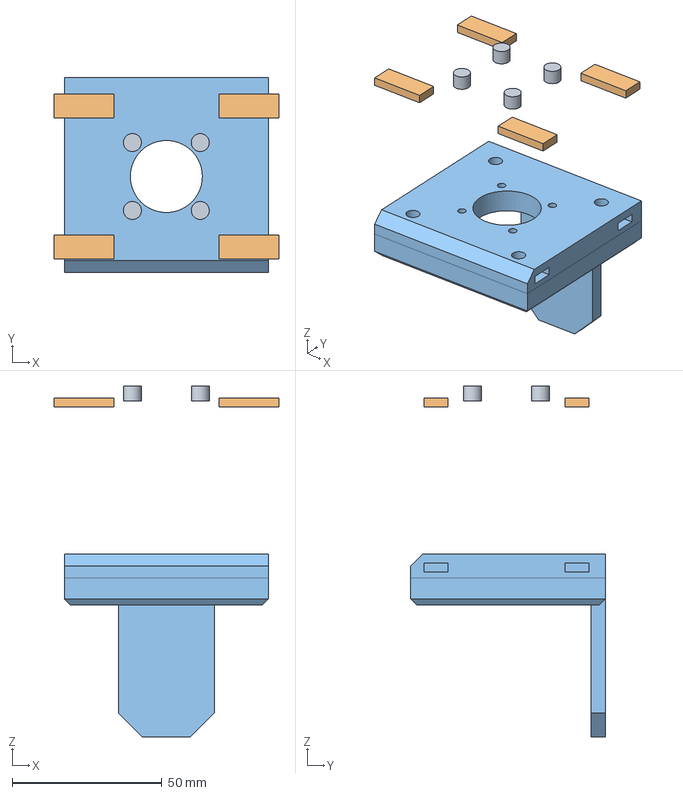
[picture p60: CAD file, 2023-12-17]
rev.2/CAD/Base/Base-part-K-moto-hold.FCStd
75.0 x 65.0 x 117.0 mm
Base_moto-hold
