surynek/RR1/rev.2/STLs/Base/Base_pulley-cover.stl

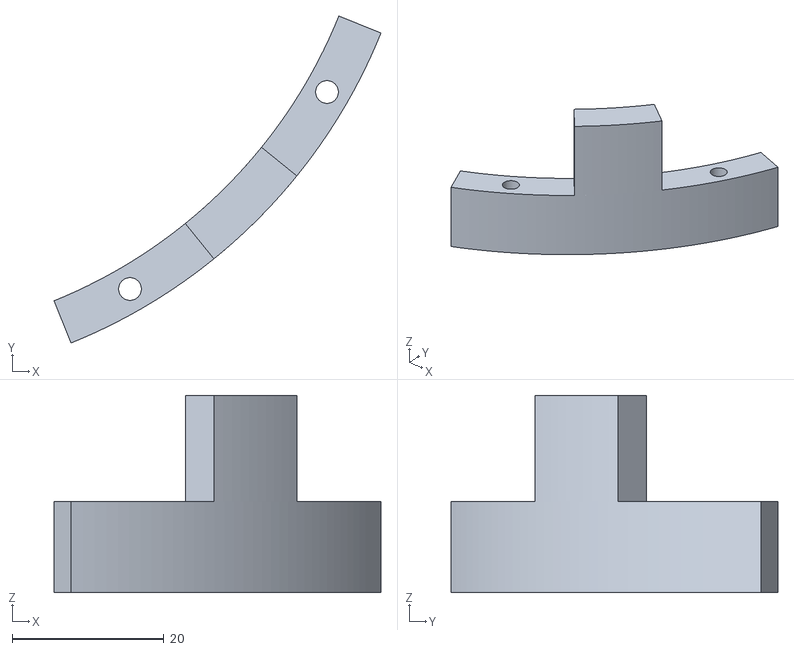
[picture p61: CAD file, 2023-08-20]
rev.2/STLs/Base/Base_pulley-cover.stl
43.1 x 43.1 x 26.0
