surynek/RR1/rev.2/STLs/Electric/Ele-box_standalone-anti-standard.stl

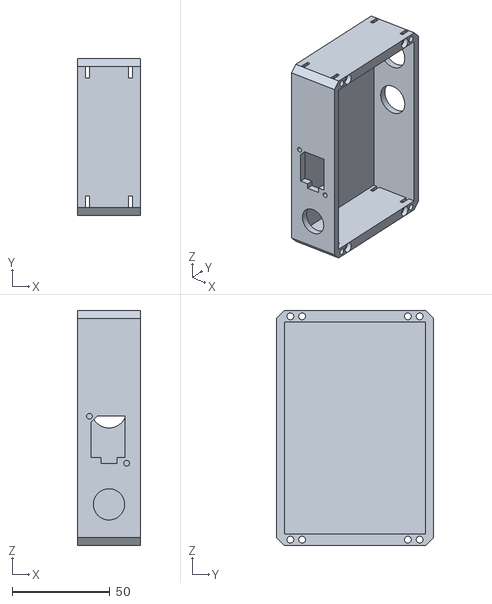
[picture p62: CAD file, 2023-08-21]
rev.2/STLs/Electric/Ele-box_standalone-anti-standard.stl
32.0 x 80.0 x 120.0
