surynek/RR1/rev.2/STLs/Gripper/Grip_slider.stl

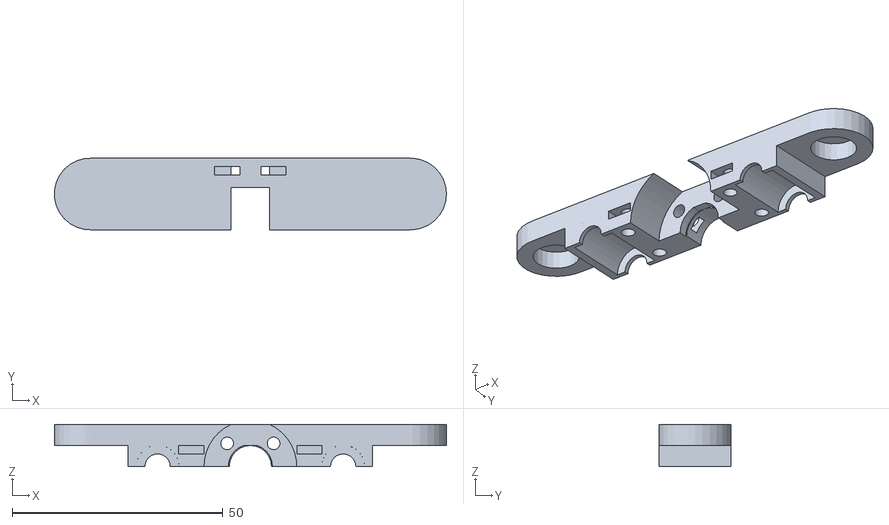
[picture p63: CAD file, 2023-08-21]
rev.2/STLs/Gripper/Grip_slider.stl
93.0 x 17.0 x 10.0
