surynek/RR1/rev.2/STLs/Joint-elbow/G-midi_adaptor-supershifted.stl

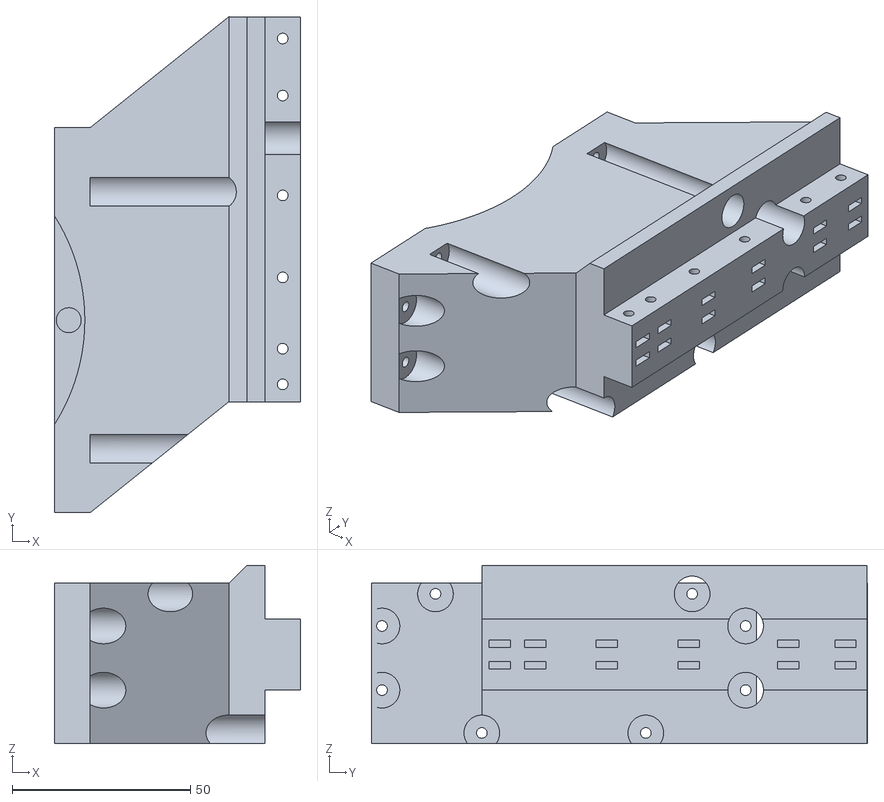
[picture p64: CAD file, 2023-08-21]
rev.2/STLs/Joint-elbow/G-midi_adaptor-supershifted.stl
69.0 x 139.2 x 50.0
