surynek/RR1/rev.2/STLs/Link-elbow/J-mini_gearbox-cage-B.stl

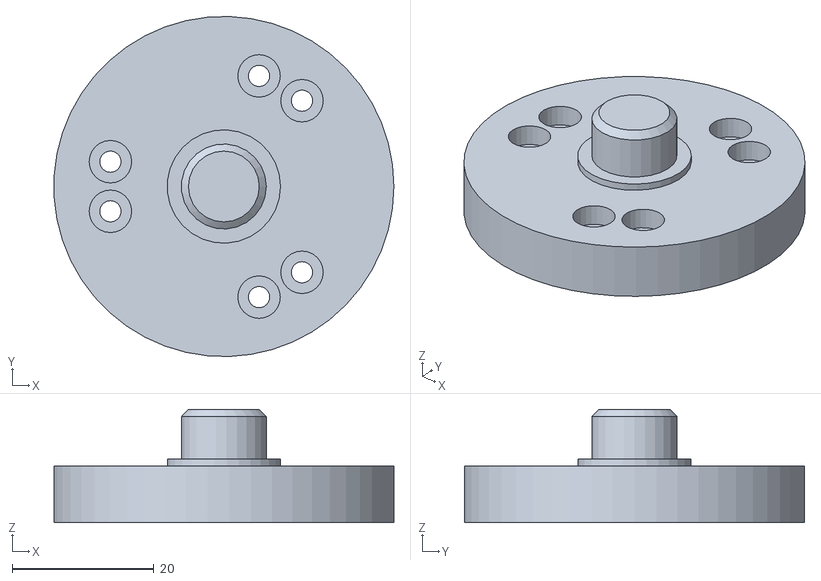
[picture p65: CAD file, 2023-08-21]
rev.2/STLs/Link-elbow/J-mini_gearbox-cage-B.stl
48.0 x 48.0 x 16.0
