surynek/RR1/rev.2/STLs/Link-upper/T-midi_box.stl

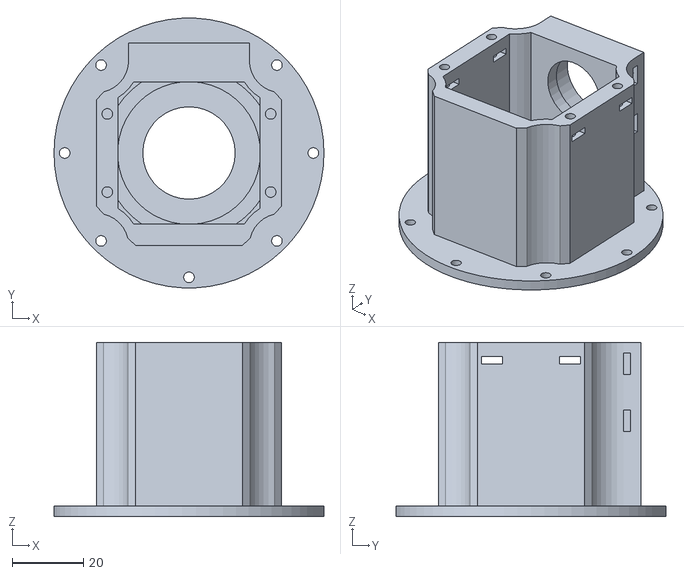
[picture p66: CAD file, 2023-08-20]
rev.2/STLs/Link-upper/T-midi_box.stl
76.0 x 75.9 x 49.0
