surynek/RR1/rev.2/STLs/Wrist/Wrist_side-actuator.stl

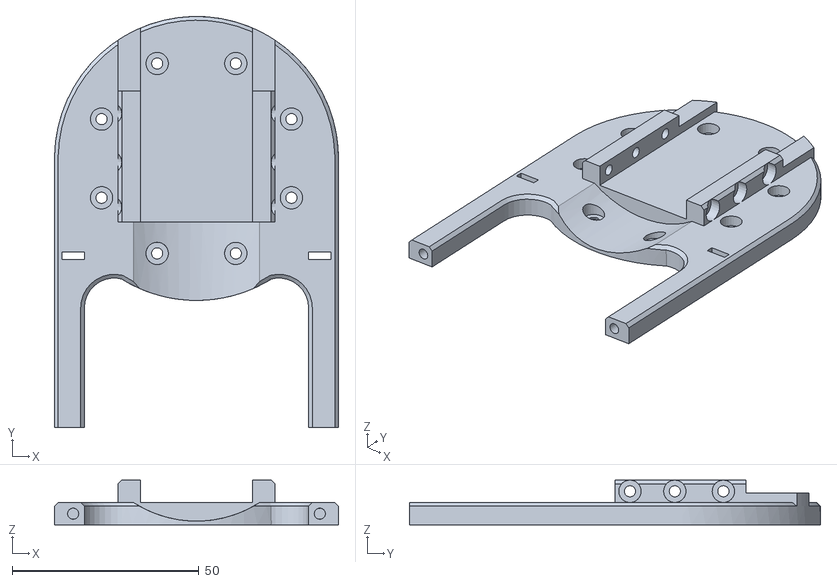
[picture p67: CAD file, 2023-08-21]
rev.2/STLs/Wrist/Wrist_side-actuator.stl
76.0 x 110.0 x 12.0
