surynek/RR1/rev.2/STLs/Base/Base_encoder-sidehold.stl

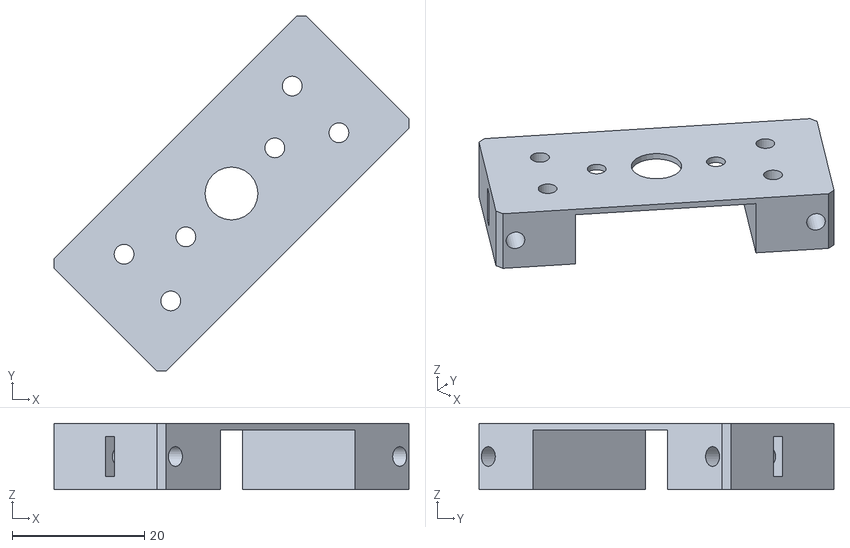
[picture p68: CAD file, 2023-08-20]
rev.2/STLs/Base/Base_encoder-sidehold.stl
53.7 x 53.7 x 10.0
