surynek/RR1/rev.2/STLs/Gripper/Grip_slider-opposite.stl

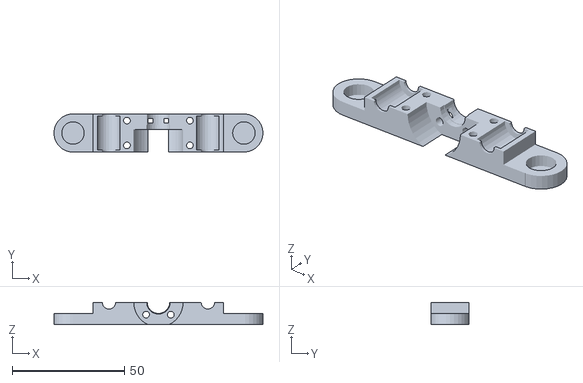
[picture p69: CAD file, 2023-08-21]
rev.2/STLs/Gripper/Grip_slider-opposite.stl
93.0 x 17.0 x 10.0
