surynek/RR1/rev.2/STLs/Joint-elbow/G-midi_bearing-ring.stl

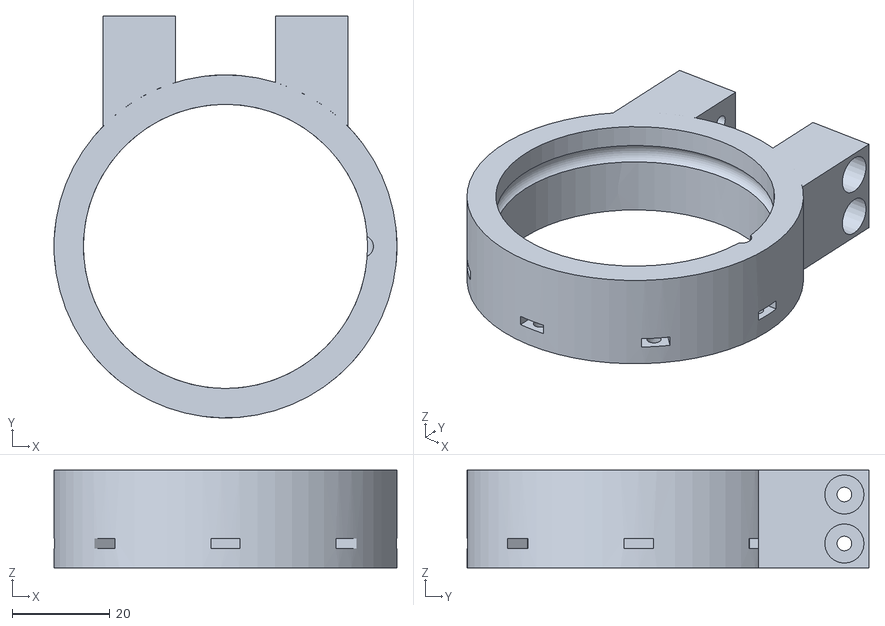
[picture p70: CAD file, 2023-08-21]
rev.2/STLs/Joint-elbow/G-midi_bearing-ring.stl
70.0 x 82.0 x 20.0
