surynek/RR1/rev.2/STLs/Joint-shoulder/J-max_encoder-outhold.stl

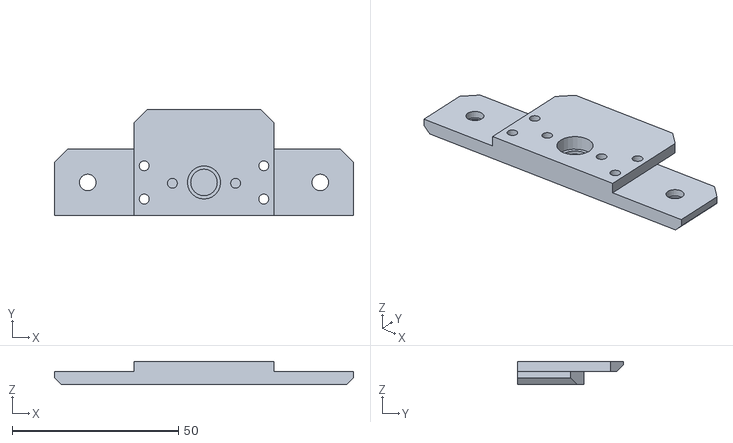
[picture p71: CAD file, 2023-08-20]
rev.2/STLs/Joint-shoulder/J-max_encoder-outhold.stl
90.0 x 32.0 x 7.00
