surynek/RR1/rev.2/STLs/Link-elbow/J-mini_inner-gear-high.stl

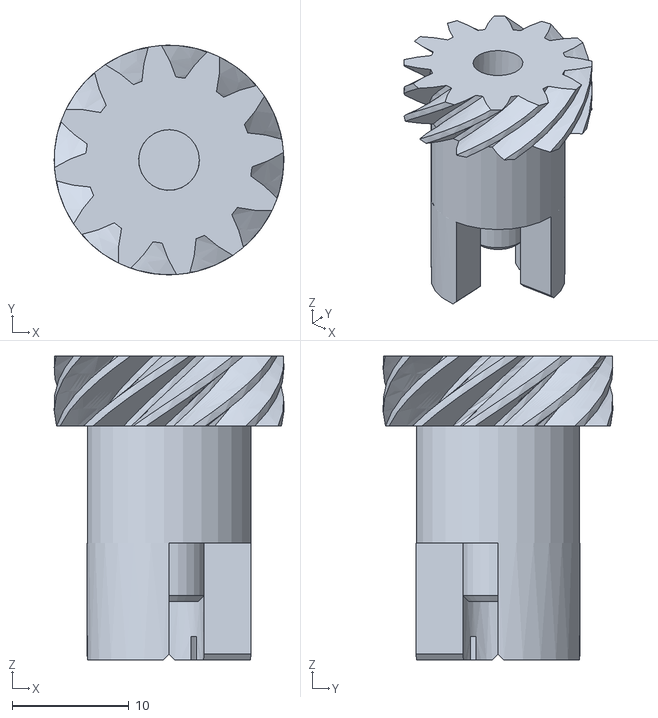
[picture p72: CAD file, 2023-08-21]
rev.2/STLs/Link-elbow/J-mini_inner-gear-high.stl
19.6 x 19.6 x 26.0
