surynek/RR1/rev.2/STLs/Link-upper/T-midi_big-gear-upper.stl

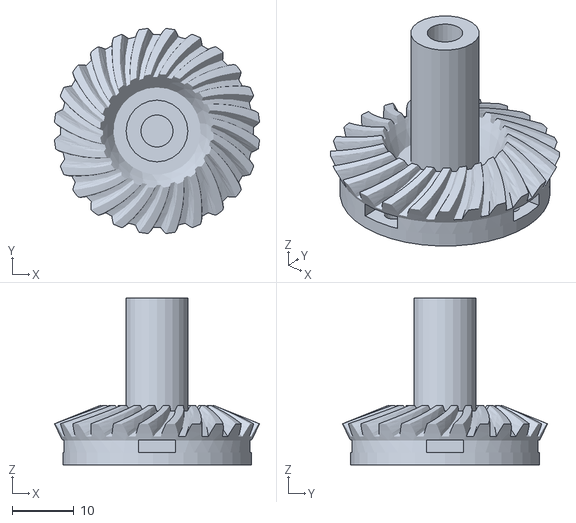
[picture p73: CAD file, 2023-08-20]
rev.2/STLs/Link-upper/T-midi_big-gear-upper.stl
33.2 x 33.2 x 27.0
