surynek/RR1/rev.2/STLs/Wrist/G-mini_gearbox-cage-A.stl

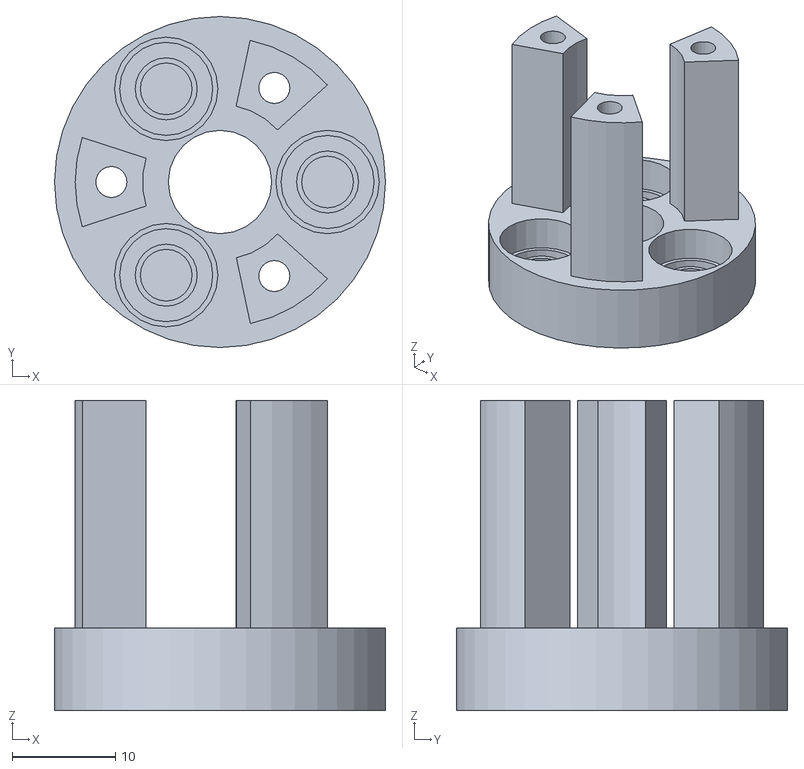
[picture p74: CAD file, 2023-08-21]
rev.2/STLs/Wrist/G-mini_gearbox-cage-A.stl
32.0 x 32.0 x 30.0
