surynek/RR1/rev.2/STLs/Base/Base_encoder-tophold.stl

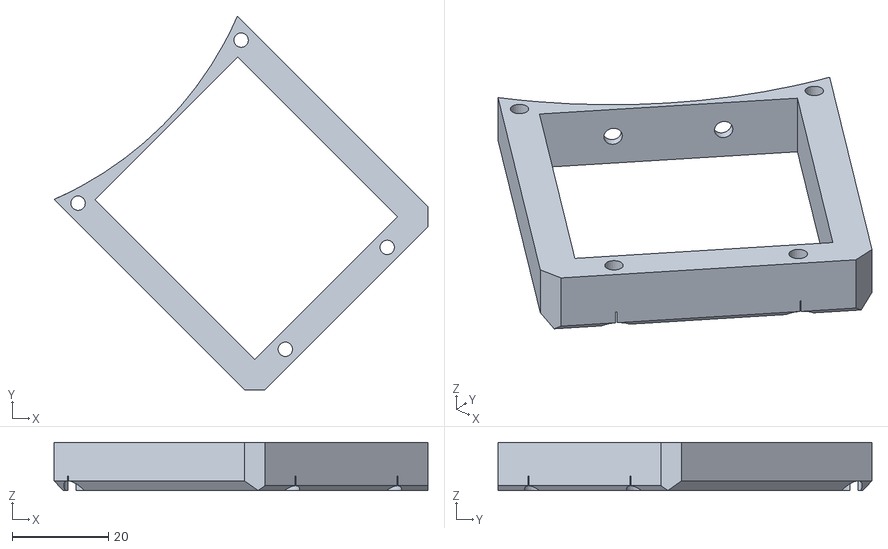
[picture p75: CAD file, 2023-08-20]
rev.2/STLs/Base/Base_encoder-tophold.stl
77.9 x 77.9 x 10.0
