surynek/RR1/rev.2/STLs/Gripper/Grip_finger-root_upper.stl

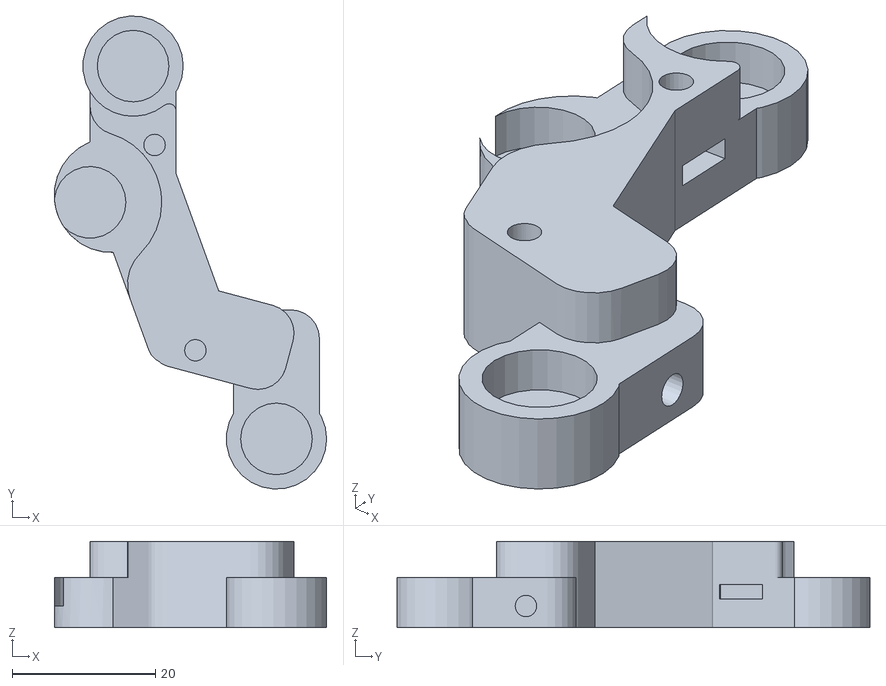
[picture p76: CAD file, 2023-08-21]
rev.2/STLs/Gripper/Grip_finger-root_upper.stl
38.0 x 66.0 x 12.0
