surynek/RR1/rev.2/STLs/Link-upper/T-midi_moto-shaft.stl

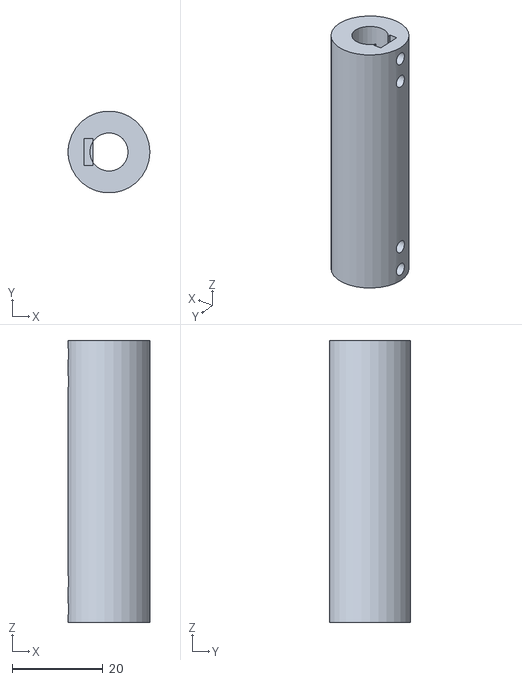
[picture p78: CAD file, 2023-08-20]
rev.2/STLs/Link-upper/T-midi_moto-shaft.stl
18.0 x 17.9 x 62.0
