surynek/RR1/rev.2/STLs/Base/Base_encoder-lowhold.stl

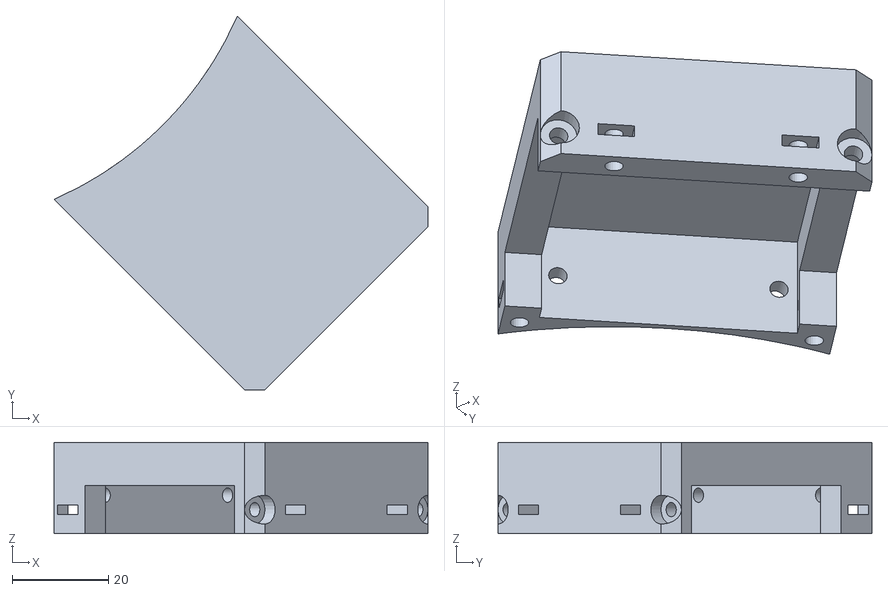
[picture p79: CAD file, 2023-08-20]
rev.2/STLs/Base/Base_encoder-lowhold.stl
77.9 x 77.9 x 19.0
