surynek/RR1/rev.2/STLs/Gripper/Grip_finger-dual-rod.stl

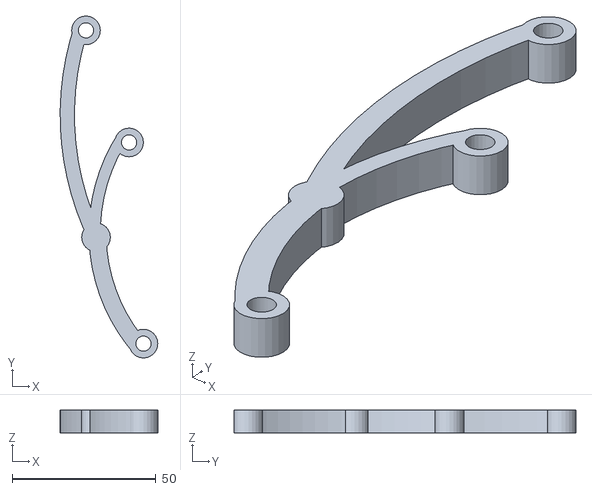
[picture p80: CAD file, 2023-08-21]
rev.2/STLs/Gripper/Grip_finger-dual-rod.stl
34.0 x 119.0 x 8.00
