surynek/RR1/rev.2/STLs/Joint-elbow/G-midi_gearbox-cage-A.stl

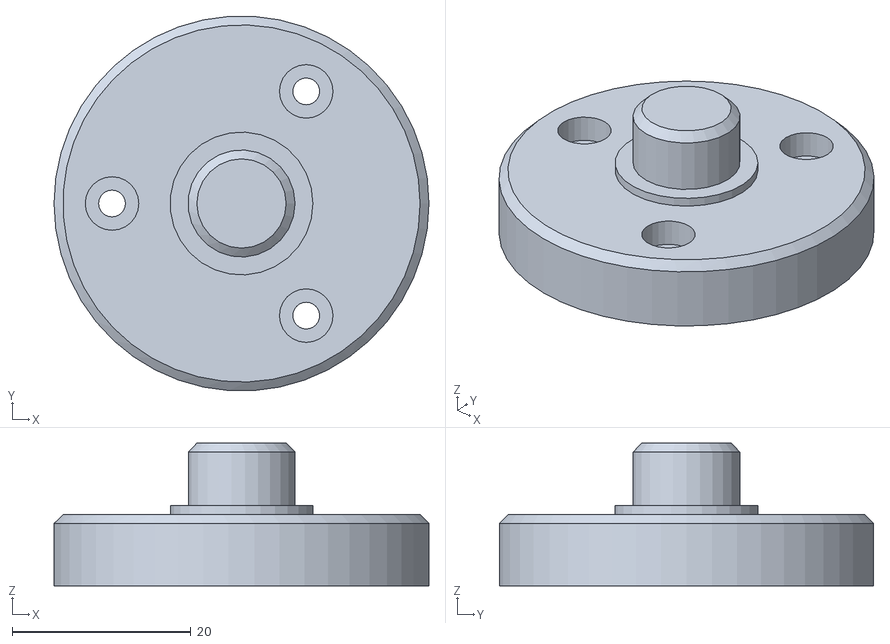
[picture p81: CAD file, 2023-08-21]
rev.2/STLs/Joint-elbow/G-midi_gearbox-cage-A.stl
42.0 x 41.9 x 16.0
