surynek/RR1/rev.2/STLs/Joint-shoulder/J-max_turn-moto-hold.stl

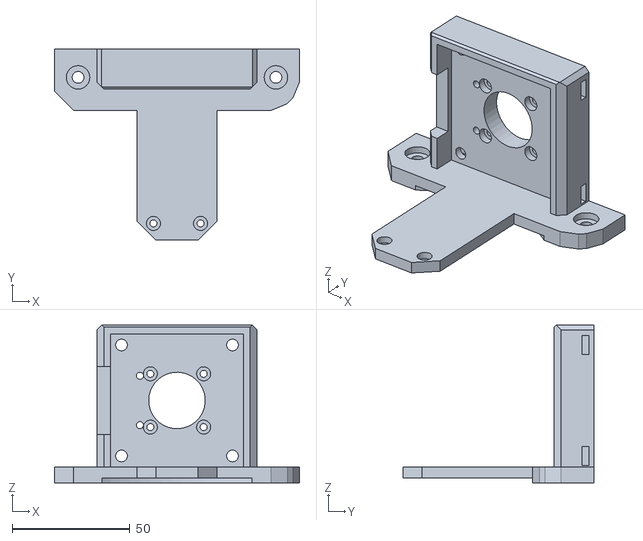
[picture p82: CAD file, 2023-08-20]
rev.2/STLs/Joint-shoulder/J-max_turn-moto-hold.stl
104.0 x 81.0 x 67.0
