surynek/RR1/rev.2/STLs/Link-elbow/J-mini_encoder-belt-ring_front.stl

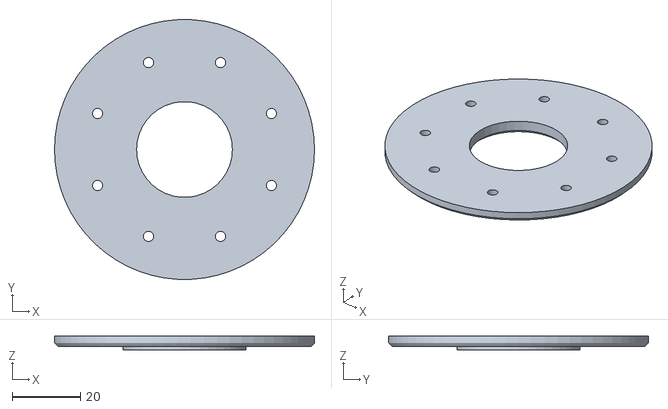
[picture p83: CAD file, 2023-08-21]
rev.2/STLs/Link-elbow/J-mini_encoder-belt-ring_front.stl
76.0 x 75.9 x 4.00
