surynek/RR1/rev.2/STLs/Link-upper/L-upper-midi_arm-rotator-opposite-cover.stl

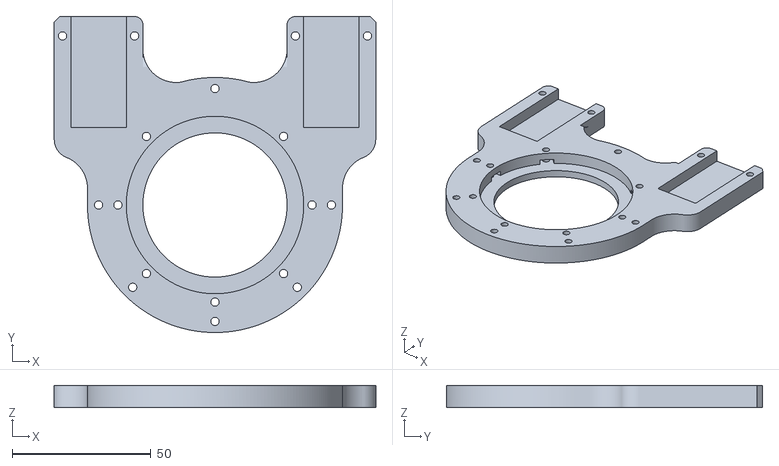
[picture p84: CAD file, 2023-04-27]
rev.2/STLs/Link-upper/L-upper-midi_arm-rotator-opposite-cover.stl
116.0 x 114.0 x 8.00
