surynek/RR1/rev.2/STLs/Wrist/G-mini_moto-holder-B.stl

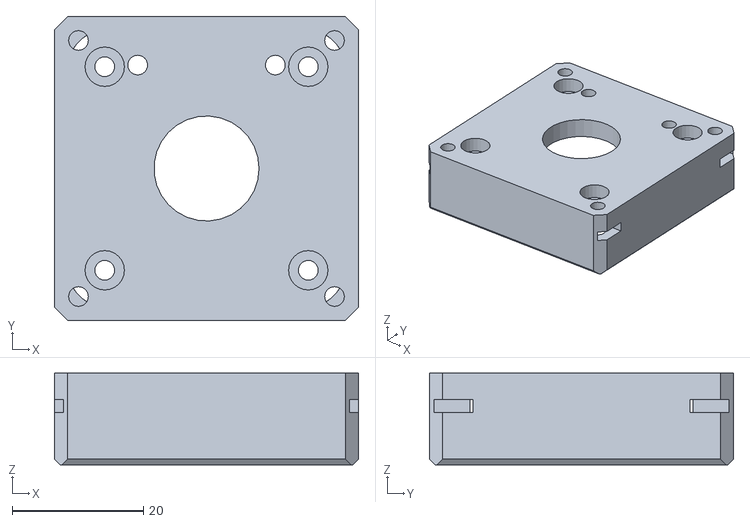
[picture p85: CAD file, 2023-08-21]
rev.2/STLs/Wrist/G-mini_moto-holder-B.stl
46.3 x 46.3 x 14.0
