surynek/RR1/rev.2/STLs/Base/Base_outer-bearing-ring.stl

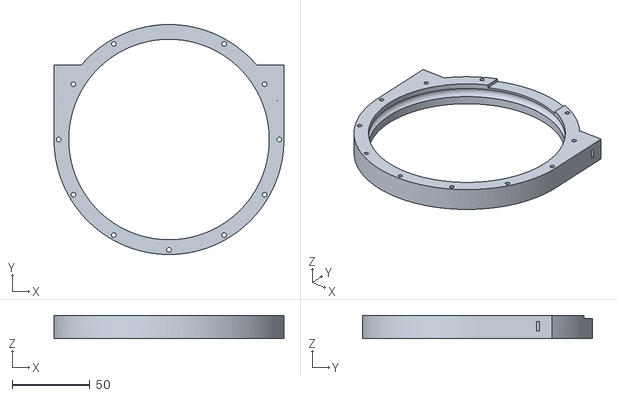
[picture p86: CAD file, 2023-04-27]
rev.2/STLs/Base/Base_outer-bearing-ring.stl
148.0 x 148.0 x 15.0
