surynek/RR1/rev.2/STLs/Joint-elbow/G-midi_bear-fix.stl

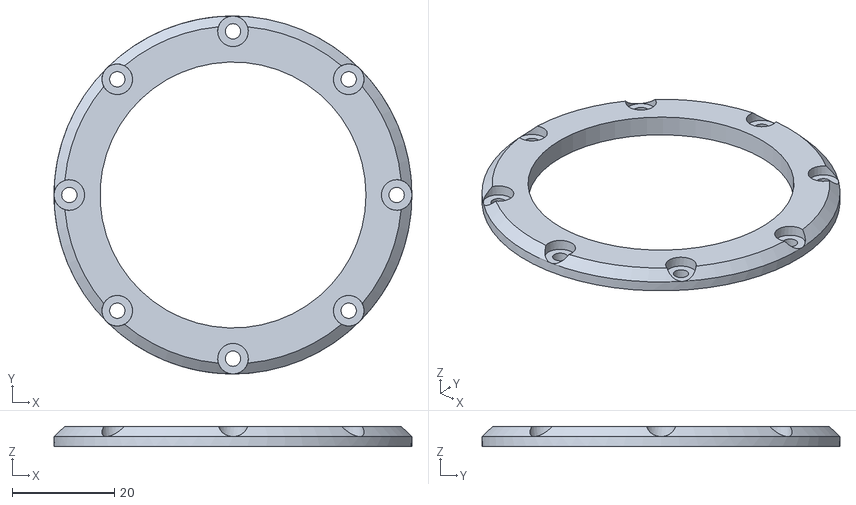
[picture p87: CAD file, 2023-08-21]
rev.2/STLs/Joint-elbow/G-midi_bear-fix.stl
70.0 x 70.0 x 4.00
