surynek/RR1/rev.2/STLs/Joint-shoulder/J-max_inner-planet.stl

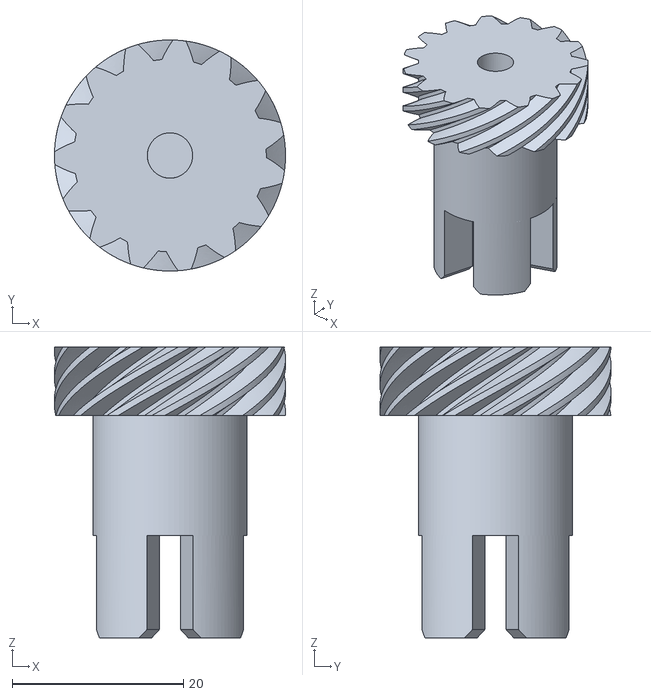
[picture p88: CAD file, 2023-04-27]
rev.2/STLs/Joint-shoulder/J-max_inner-planet.stl
27.0 x 27.0 x 34.0
