surynek/RR1/rev.2/STLs/Link-elbow/J-mini_outer-gear.stl

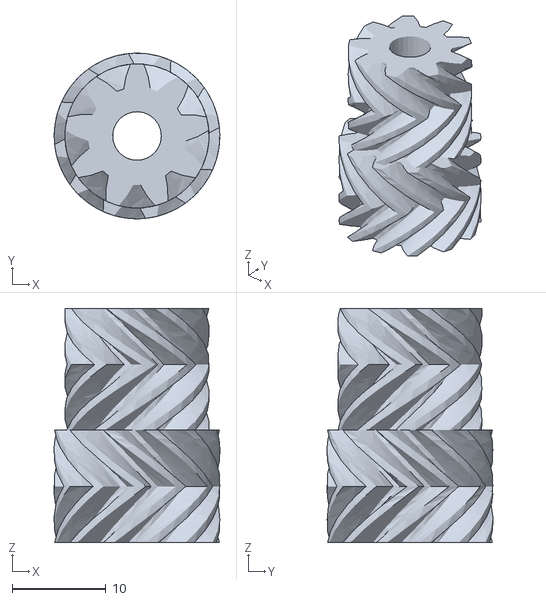
[picture p89: CAD file, 2023-08-21]
rev.2/STLs/Link-elbow/J-mini_outer-gear.stl
17.7 x 17.7 x 25.0
