surynek/RR1/rev.2/STLs/Wrist/Wrist_outer-halo.stl

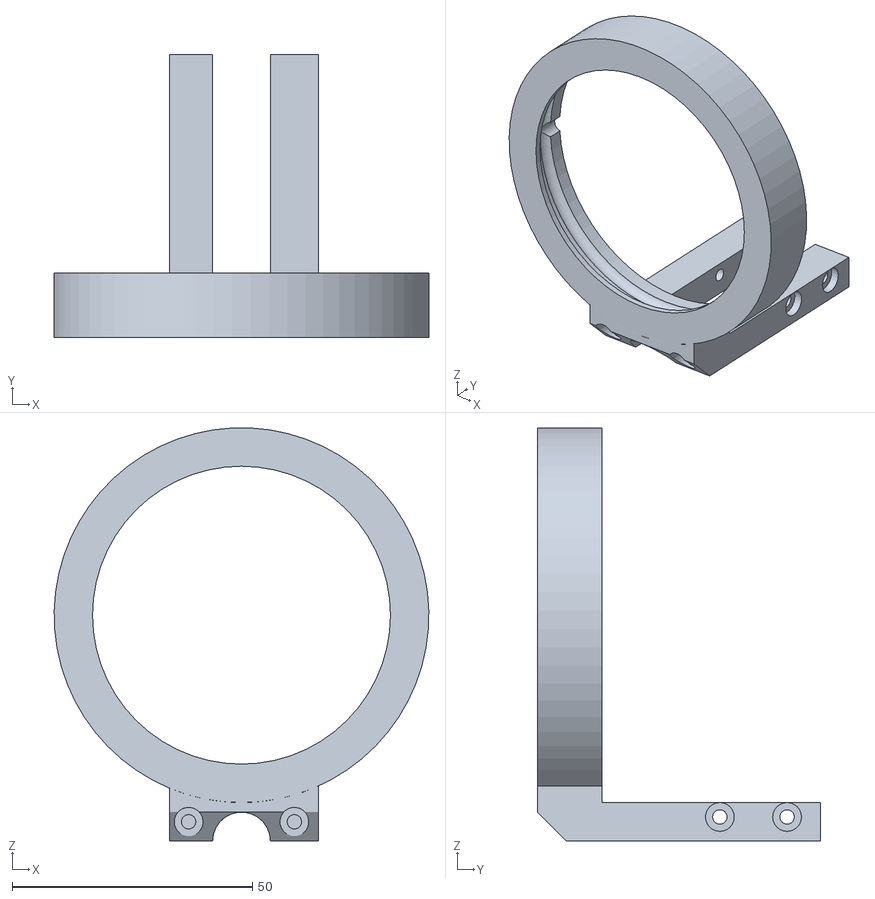
[picture p90: CAD file, 2023-08-21]
rev.2/STLs/Wrist/Wrist_outer-halo.stl
78.0 x 59.0 x 86.0
