surynek/RR1/rev.2/STLs/Joint-elbow/G-midi_actuator-ring.stl

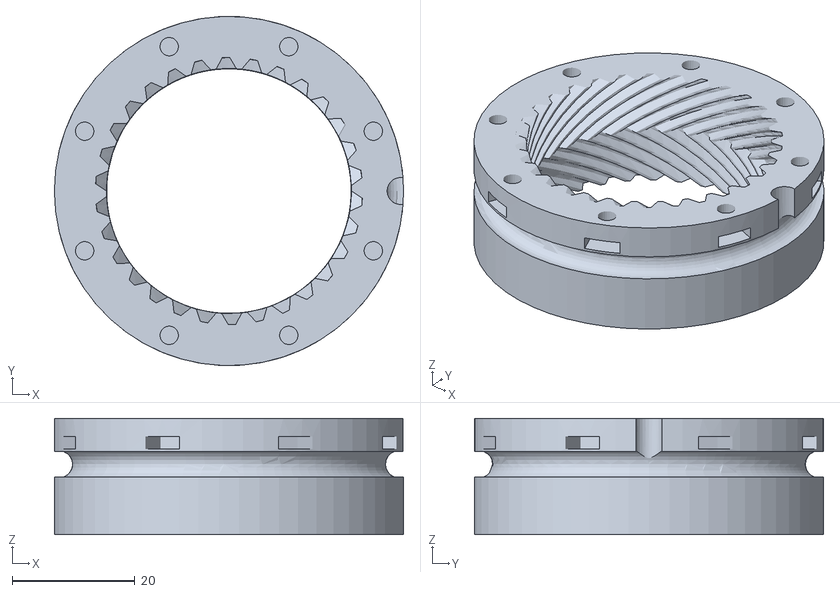
[picture p91: CAD file, 2023-08-21]
rev.2/STLs/Joint-elbow/G-midi_actuator-ring.stl
57.0 x 57.0 x 19.0
