surynek/RR1/rev.2/STLs/Joint-shoulder/J-max_gearbox-cage-B.stl

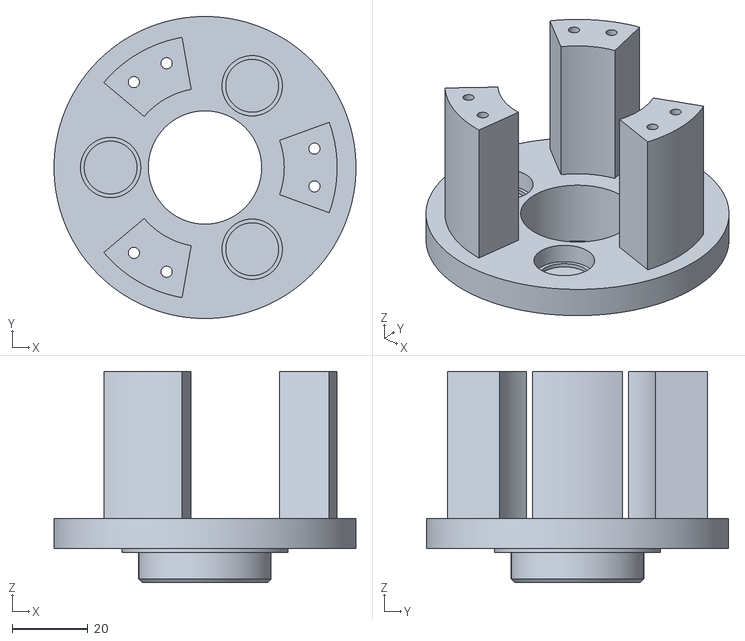
[picture p92: CAD file, 2023-04-27]
rev.2/STLs/Joint-shoulder/J-max_gearbox-cage-B.stl
80.0 x 80.0 x 56.0
