surynek/RR1/rev.2/STLs/Link-upper/L-upper-midi_arm-rotator-cover.stl

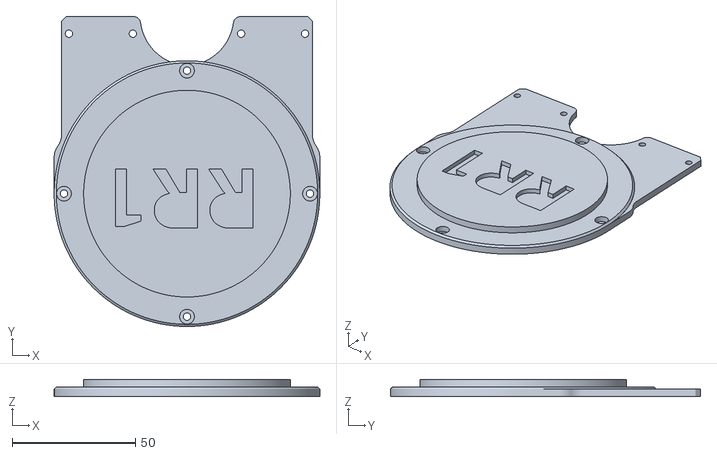
[picture p93: CAD file, 2023-04-27]
rev.2/STLs/Link-upper/L-upper-midi_arm-rotator-cover.stl
108.0 x 126.0 x 7.00
