surynek/RR1/rev.2/STLs/Wrist/Wrist_tabular.stl

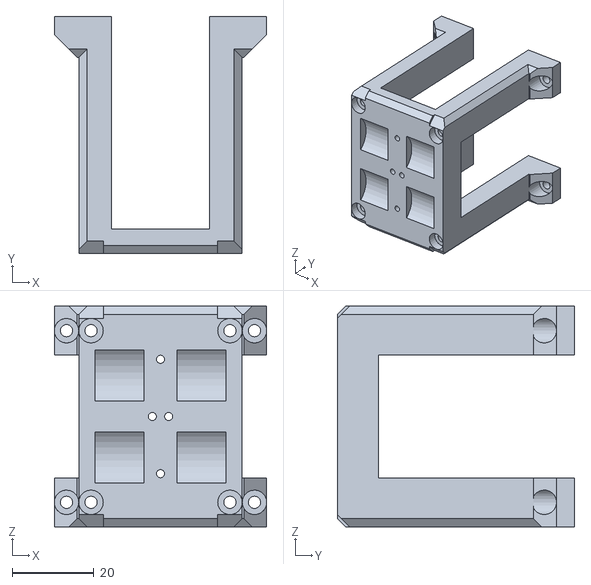
[picture p94: CAD file, 2023-08-21]
rev.2/STLs/Wrist/Wrist_tabular.stl
52.0 x 58.0 x 54.0
