surynek/RR1/rev.2/STLs/Base/Base_the-turret.stl

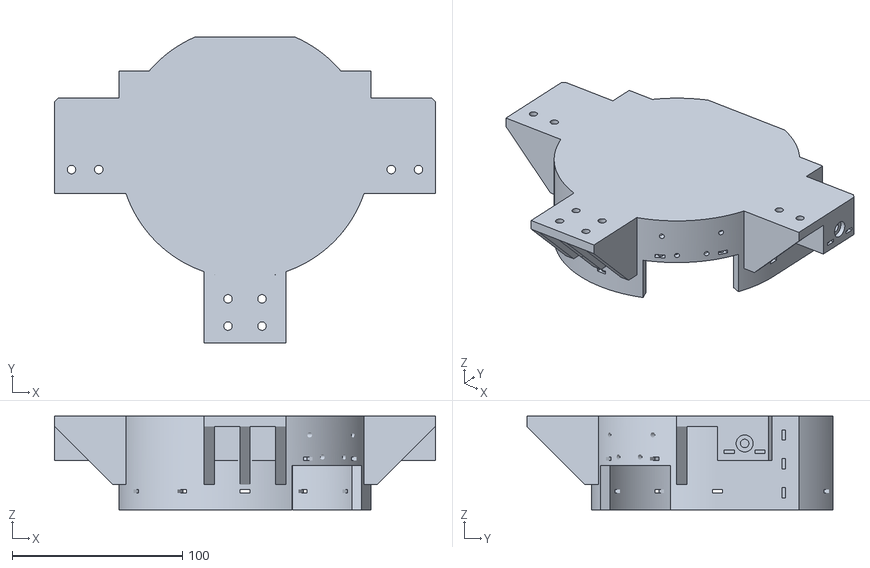
[picture p95: CAD file, 2023-04-27]
rev.2/STLs/Base/Base_the-turret.stl
224.0 x 180.0 x 55.0
