surynek/RR1/rev.2/STLs/Joint-shoulder/J-max_arm-bearing-fix.stl

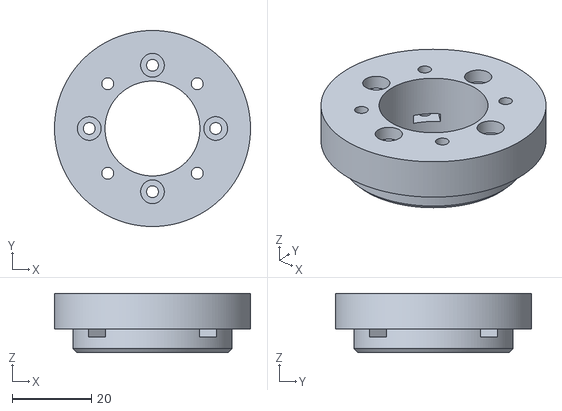
[picture p96: CAD file, 2023-04-27]
rev.2/STLs/Joint-shoulder/J-max_arm-bearing-fix.stl
49.6 x 49.6 x 15.0
