surynek/RR1/rev.2/STLs/Link-upper/L-upper_arm-rotator.stl

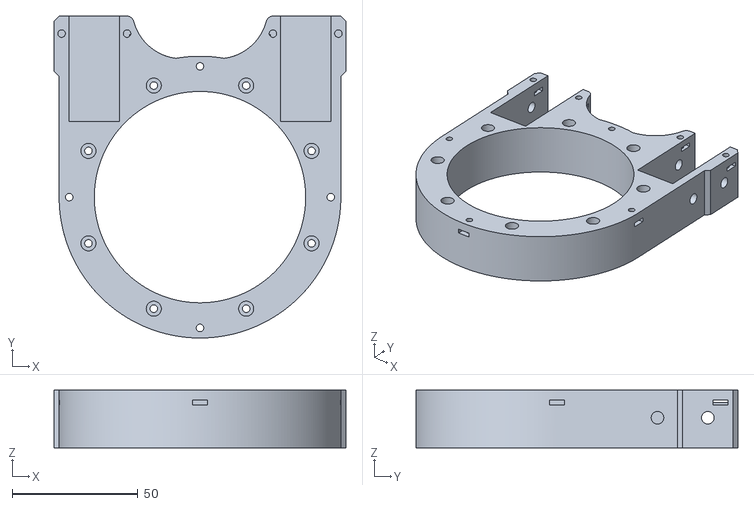
[picture p97: CAD file, 2023-04-27]
rev.2/STLs/Link-upper/L-upper_arm-rotator.stl
116.0 x 128.0 x 23.0
