surynek/RR1/rev.2/STLs/Base/Base_inner-bearing-ring.stl

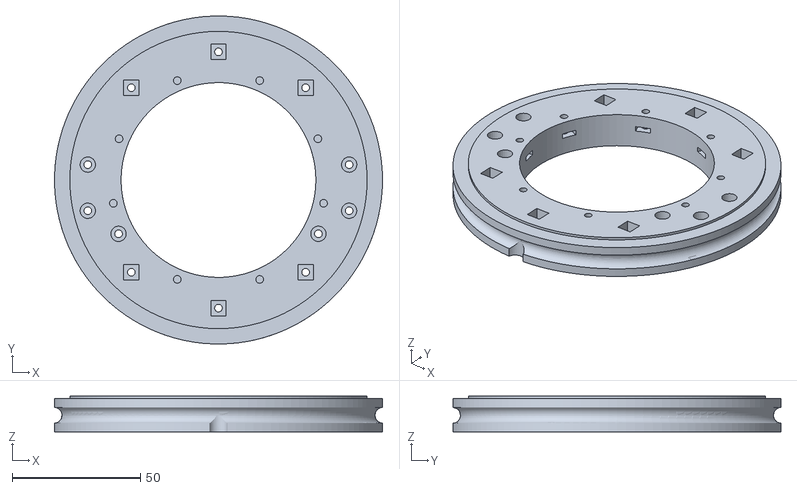
[picture p98: CAD file, 2023-04-27]
rev.2/STLs/Base/Base_inner-bearing-ring.stl
128.0 x 128.0 x 14.0
