surynek/RR1/rev.2/STLs/Joint-elbow/G-midi_arm-rotator.stl

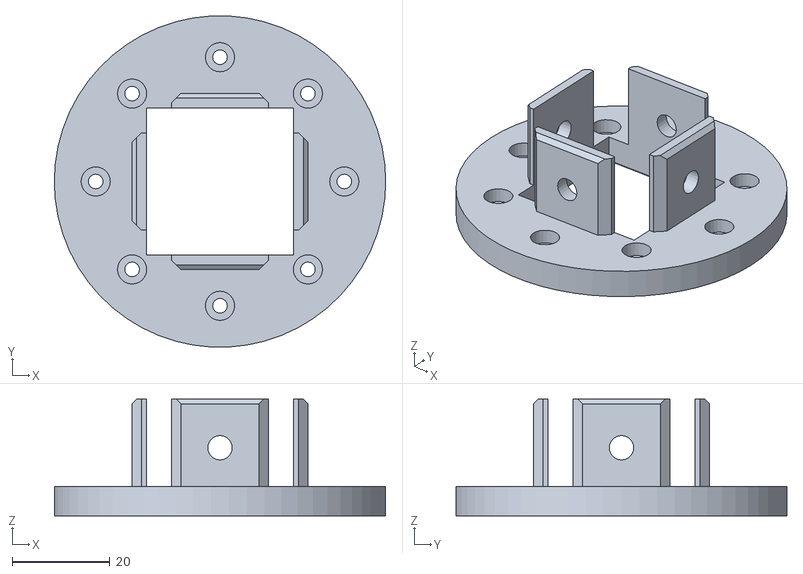
[picture p99: CAD file, 2023-08-21]
rev.2/STLs/Joint-elbow/G-midi_arm-rotator.stl
68.0 x 67.9 x 24.0
