surynek/RR1/rev.2/STLs/Joint-shoulder/J-max_actuator-ring.stl

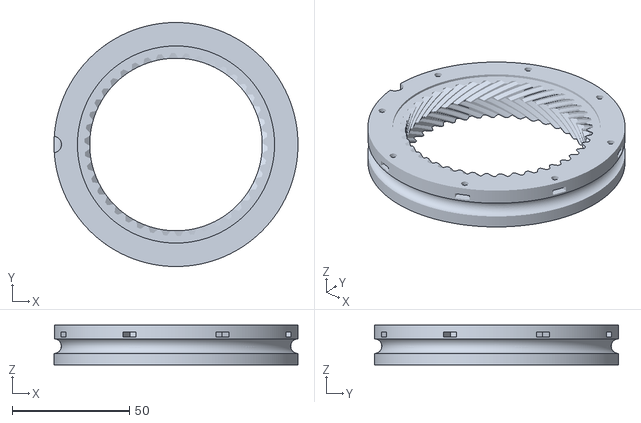
[picture p100: CAD file, 2023-04-27]
rev.2/STLs/Joint-shoulder/J-max_actuator-ring.stl
104.0 x 104.0 x 17.0
