surynek/RR1/rev.2/STLs/Link-elbow/L-elb_xorior-hole.stl

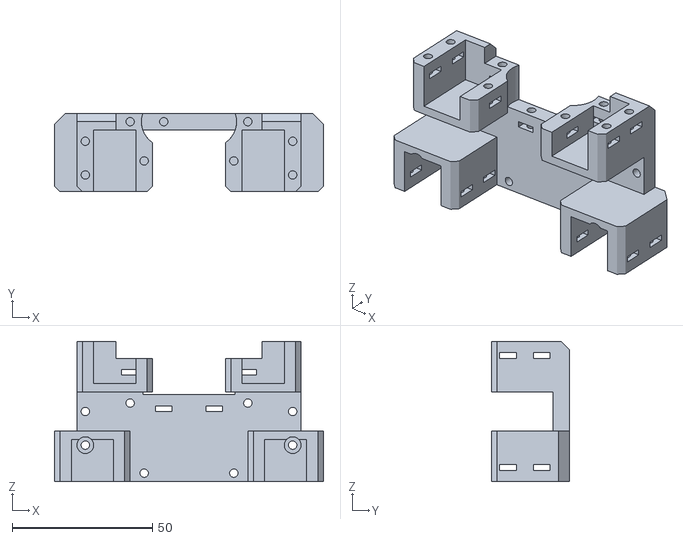
[picture p101: CAD file, 2023-08-21]
rev.2/STLs/Link-elbow/L-elb_xorior-hole.stl
96.0 x 28.0 x 50.0
