surynek/RR1/rev.2/STLs/Link-upper/L-upper-midi_arm-rotator.stl

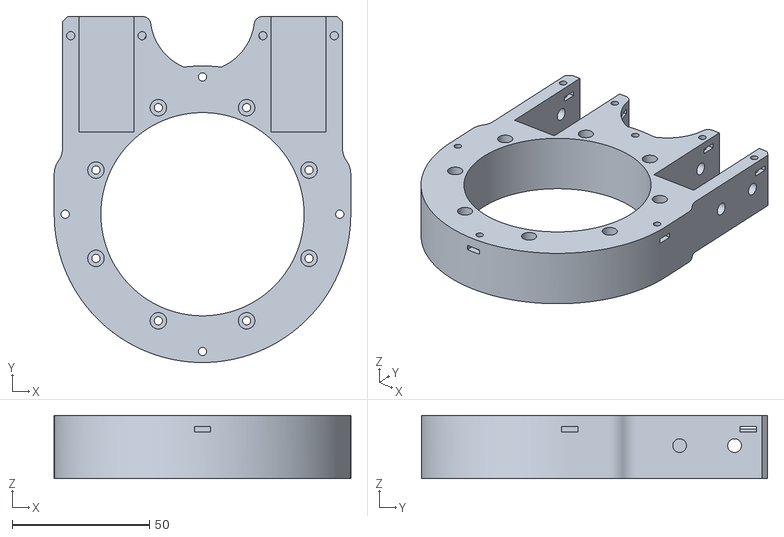
[picture p102: CAD file, 2023-04-27]
rev.2/STLs/Link-upper/L-upper-midi_arm-rotator.stl
108.0 x 126.0 x 23.0
