surynek/RR1/rev.2/STLs/Wrist/G-mini_encoder-belt-ring.stl

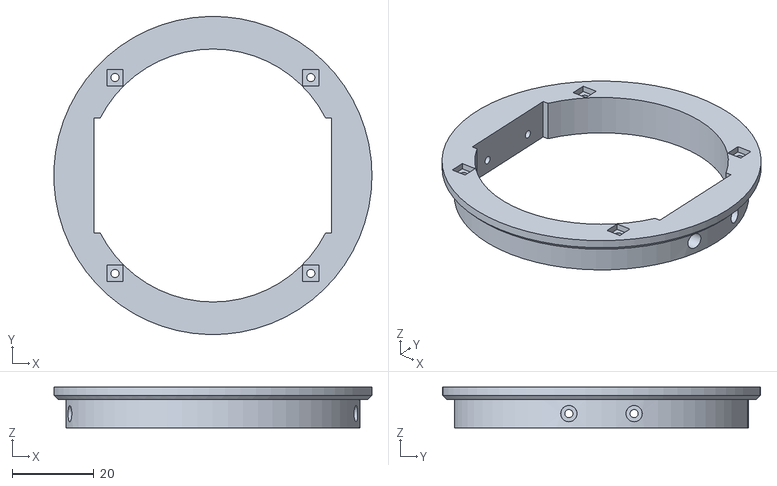
[picture p103: CAD file, 2023-08-21]
rev.2/STLs/Wrist/G-mini_encoder-belt-ring.stl
78.0 x 78.0 x 10.0
