surynek/RR1/rev.2/STLs/Base/Base_top-seal.stl

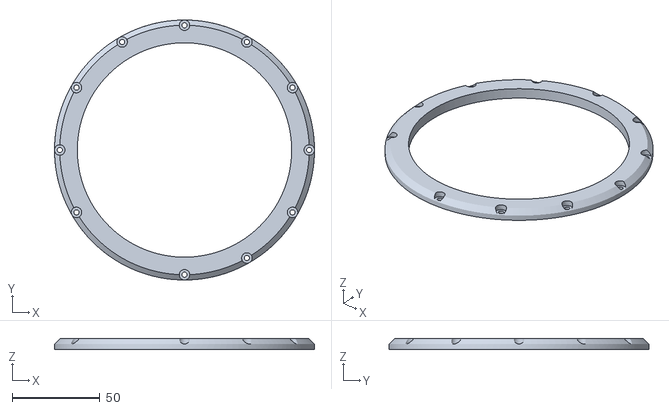
[picture p104: CAD file, 2023-04-27]
rev.2/STLs/Base/Base_top-seal.stl
148.0 x 148.0 x 6.00
