surynek/RR1/rev.2/STLs/Joint-elbow/G-midi_monoblok.stl

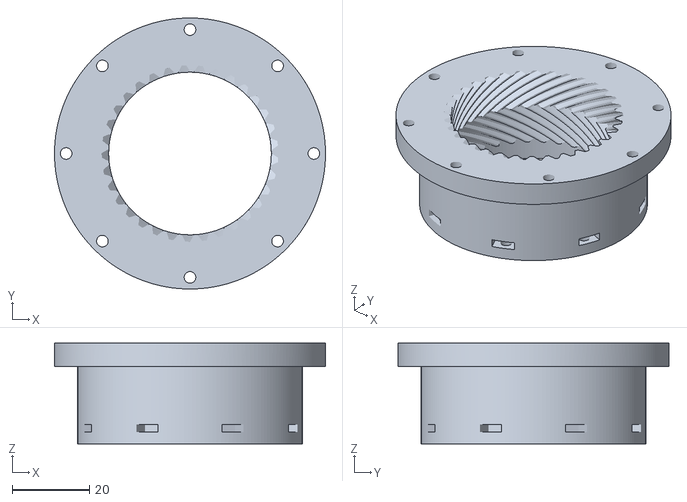
[picture p105: CAD file, 2023-08-21]
rev.2/STLs/Joint-elbow/G-midi_monoblok.stl
70.0 x 70.0 x 26.0
