surynek/RR1/rev.2/STLs/Link-elbow/T-mini_small-gear-upper.stl

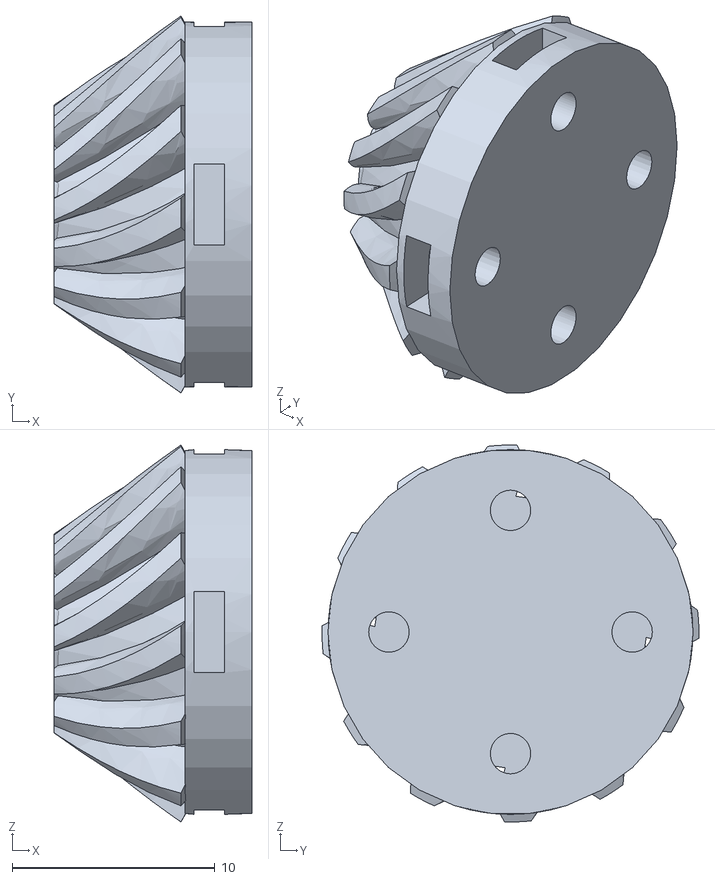
[picture p106: CAD file, 2023-08-21]
rev.2/STLs/Link-elbow/T-mini_small-gear-upper.stl
9.75 x 18.6 x 18.6
