surynek/RR1/rev.2/STLs/Link-upper/L-upper-max_arm-rotator-undercover.stl

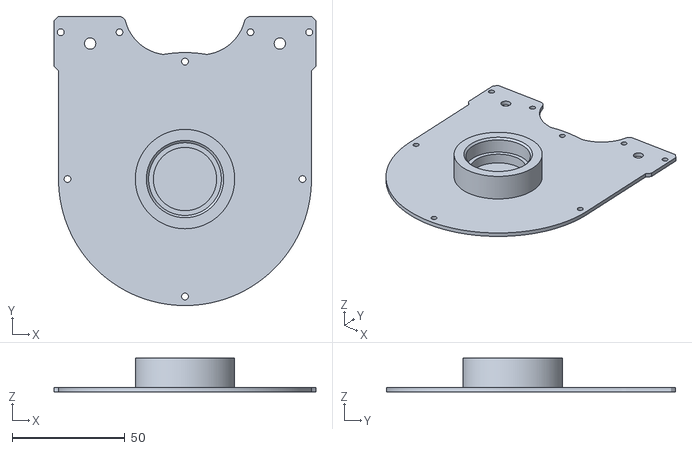
[picture p107: CAD file, 2023-04-27]
rev.2/STLs/Link-upper/L-upper-max_arm-rotator-undercover.stl
116.0 x 128.0 x 15.0
