surynek/RR1/rev.2/STLs/Wrist/G-mini_actuator-drum.stl

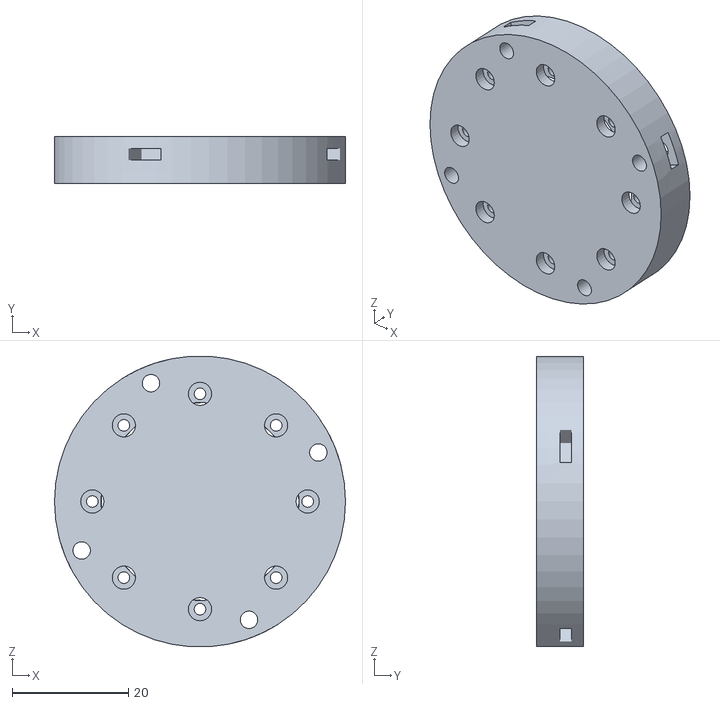
[picture p108: CAD file, 2023-08-21]
rev.2/STLs/Wrist/G-mini_actuator-drum.stl
50.0 x 8.00 x 49.9
