surynek/RR1/rev.2/STLs/Base/Base_triangle-support.stl

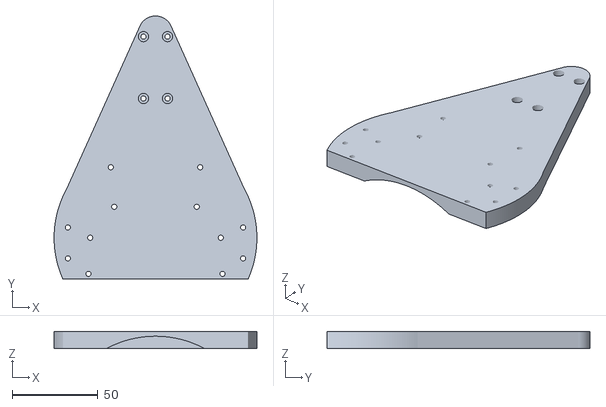
[picture p109: CAD file, 2023-04-27]
rev.2/STLs/Base/Base_triangle-support.stl
118.0 x 153.0 x 10.0
