surynek/RR1/rev.2/STLs/Joint-elbow/G-midi_belt-wheel-rear.stl

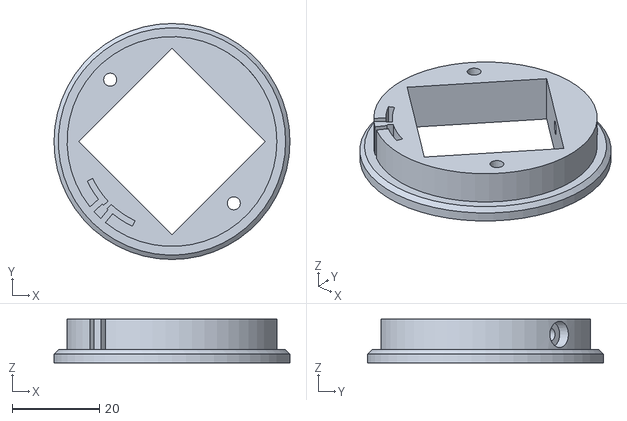
[picture p110: CAD file, 2023-08-21]
rev.2/STLs/Joint-elbow/G-midi_belt-wheel-rear.stl
54.0 x 54.0 x 10.0
