surynek/RR1/rev.2/STLs/Joint-shoulder/J-max_outer-planet.stl

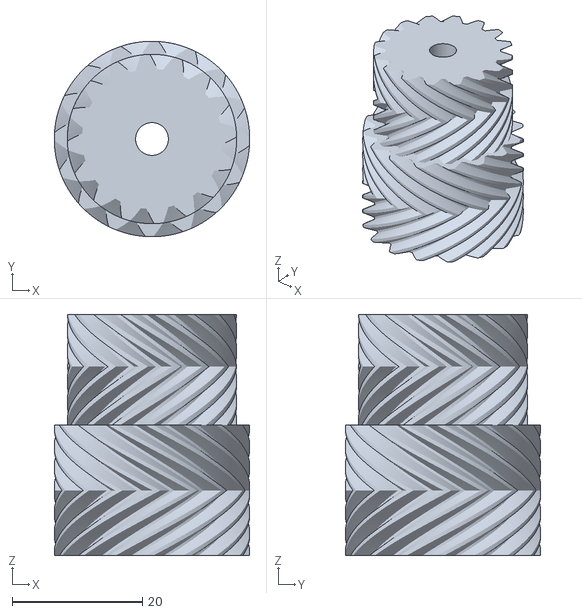
[picture p111: CAD file, 2023-04-27]
rev.2/STLs/Joint-shoulder/J-max_outer-planet.stl
30.0 x 30.0 x 37.0
