surynek/RR1/rev.2/STLs/Link-elbow/T-mini_box.stl

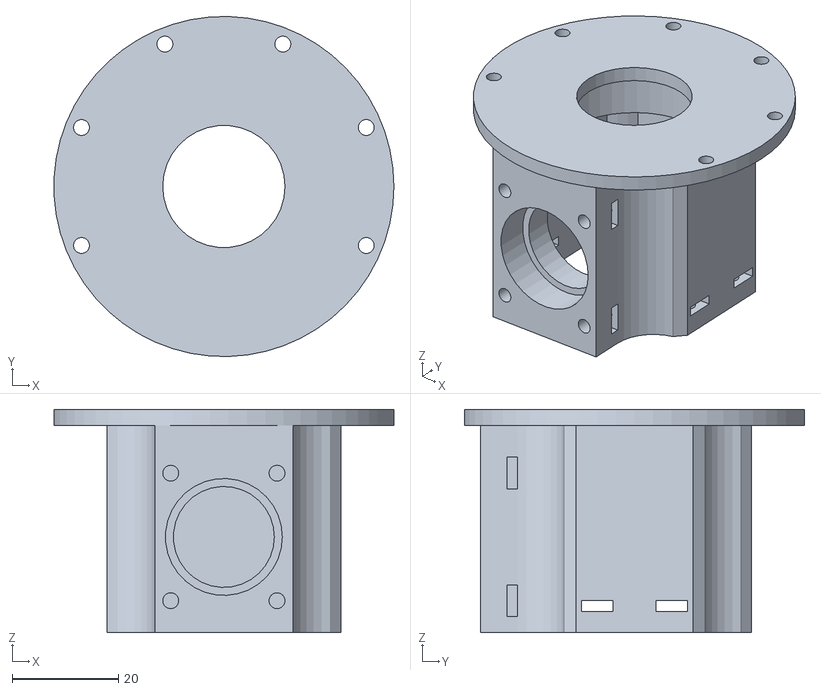
[picture p112: CAD file, 2023-08-21]
rev.2/STLs/Link-elbow/T-mini_box.stl
64.0 x 64.0 x 42.0
