surynek/RR1/rev.2/STLs/Link-upper/L-upper-max_arm-rotator-opposite.stl

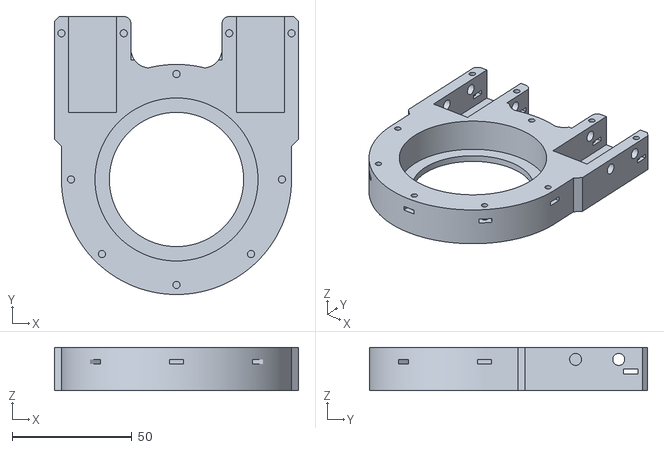
[picture p113: CAD file, 2023-04-27]
rev.2/STLs/Link-upper/L-upper-max_arm-rotator-opposite.stl
102.0 x 116.0 x 18.0
