surynek/RR1/rev.2/STLs/Wrist/G-mini_bearing-ring.stl

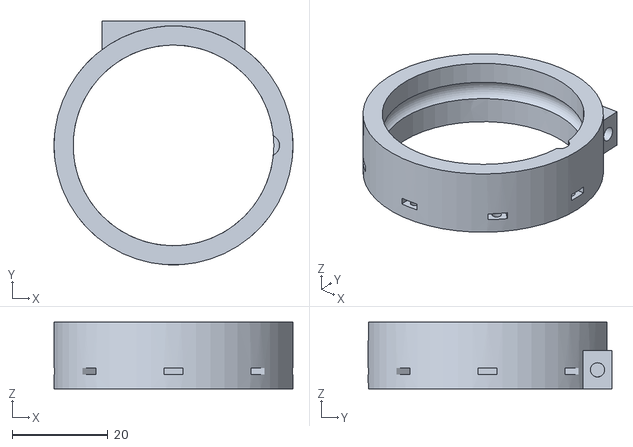
[picture p114: CAD file, 2023-08-21]
rev.2/STLs/Wrist/G-mini_bearing-ring.stl
50.0 x 51.0 x 14.0
