surynek/RR1/rev.2/STLs/Base/Base_pedestal-encoder-belt-A.stl

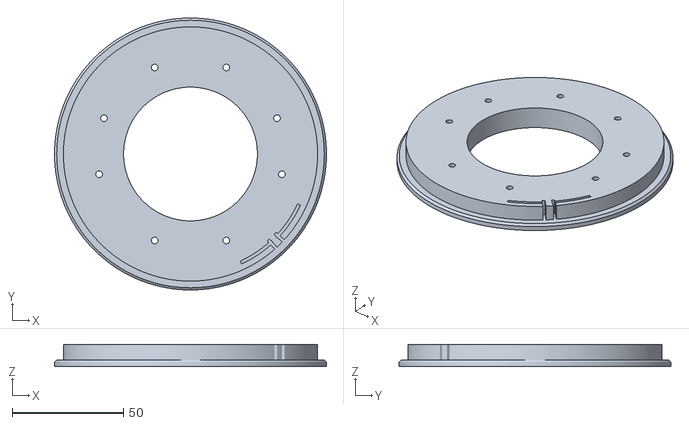
[picture p115: CAD file, 2023-04-27]
rev.2/STLs/Base/Base_pedestal-encoder-belt-A.stl
122.0 x 122.0 x 10.0
