surynek/RR1/rev.2/STLs/Joint-elbow/G-midi_bear-hold-encoder-front.stl

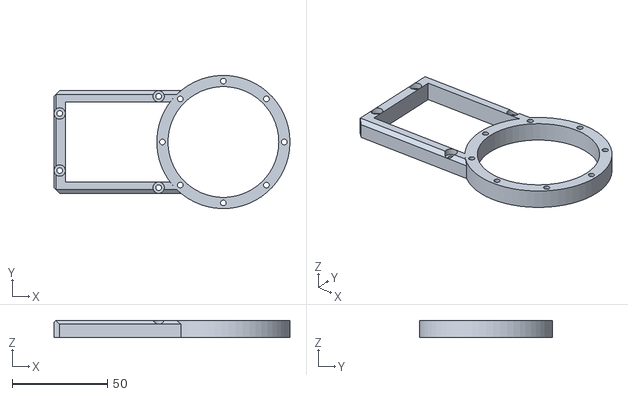
[picture p116: CAD file, 2023-08-21]
rev.2/STLs/Joint-elbow/G-midi_bear-hold-encoder-front.stl
124.0 x 70.0 x 9.00
