surynek/RR1/rev.2/STLs/Joint-shoulder/J-max_bearing-ring.stl

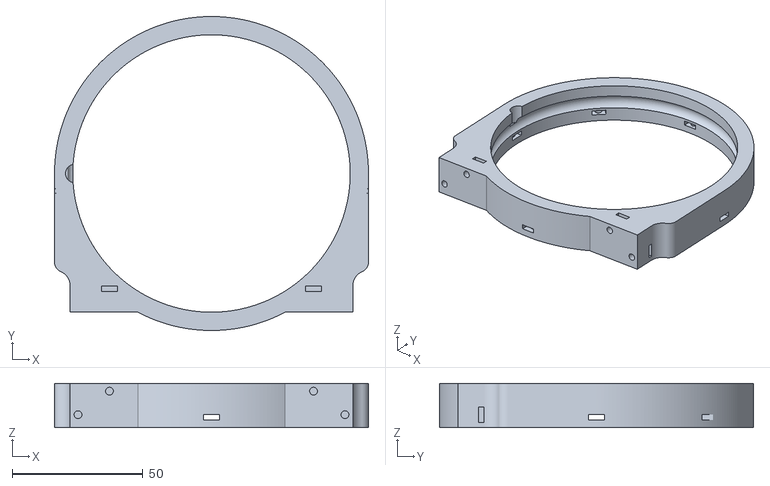
[picture p117: CAD file, 2023-04-27]
rev.2/STLs/Joint-shoulder/J-max_bearing-ring.stl
120.0 x 120.0 x 17.0
