surynek/RR1/rev.2/STLs/Link-elbow/L-elb_major-conno-nomoto.stl

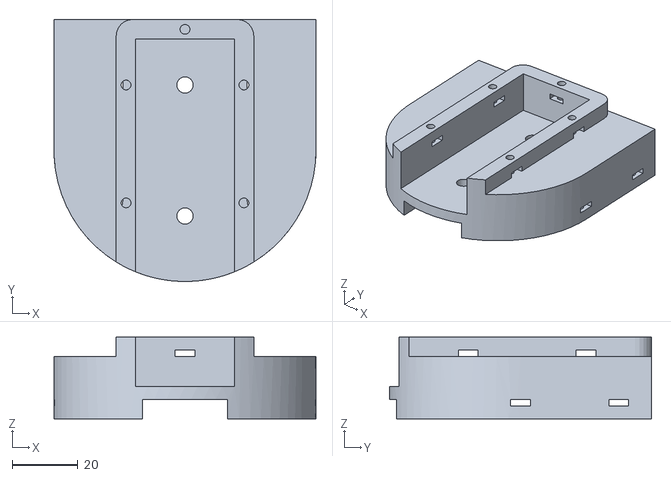
[picture p118: CAD file, 2023-08-21]
rev.2/STLs/Link-elbow/L-elb_major-conno-nomoto.stl
80.0 x 80.0 x 25.0
