surynek/RR1/rev.2/STLs/Link-upper/L-upper-max_arm-rotator-cover.stl

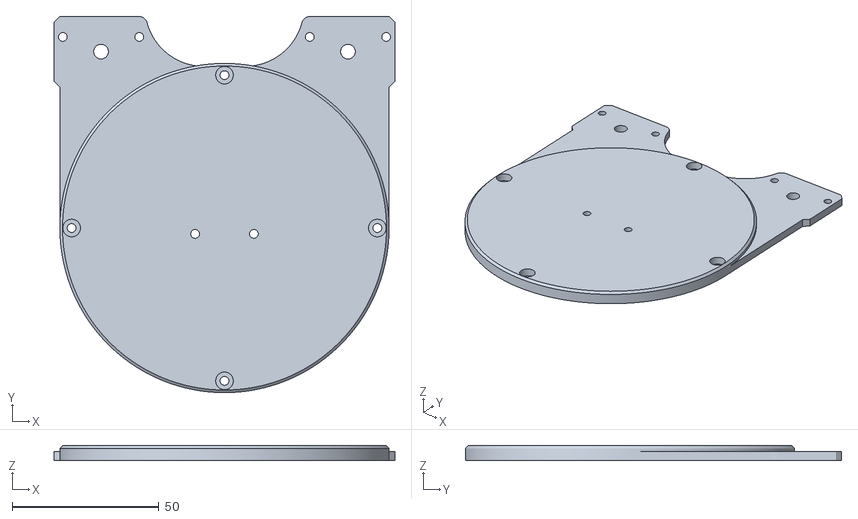
[picture p119: CAD file, 2023-04-27]
rev.2/STLs/Link-upper/L-upper-max_arm-rotator-cover.stl
116.0 x 128.0 x 5.00
