surynek/RR1/rev.2/STLs/Base/Base_pedestal-axial-encoder-belt-B.stl

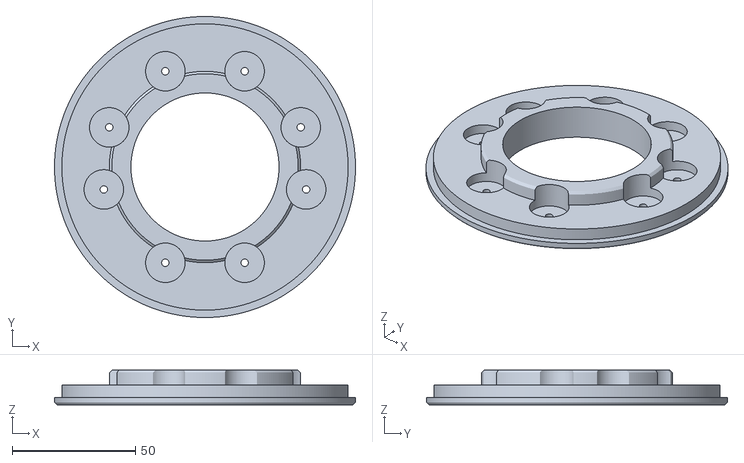
[picture p120: CAD file, 2023-04-27]
rev.2/STLs/Base/Base_pedestal-axial-encoder-belt-B.stl
122.0 x 122.0 x 14.0
