surynek/RR1/rev.2/STLs/Joint-elbow/G-midi_inner-gear-part-A-lax.stl

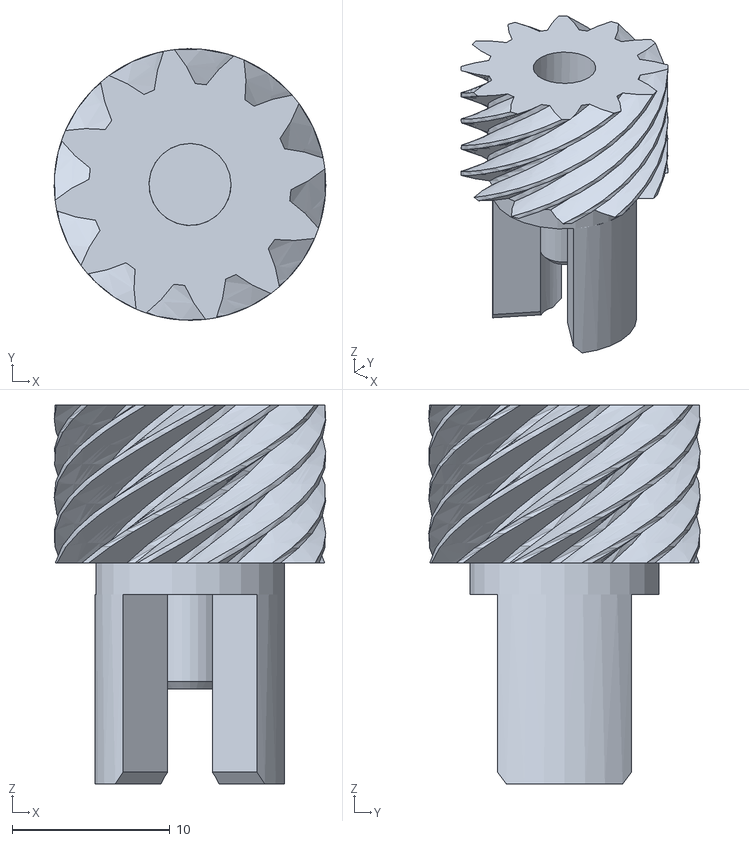
[picture p121: CAD file, 2023-08-21]
rev.2/STLs/Joint-elbow/G-midi_inner-gear-part-A-lax.stl
17.2 x 17.2 x 24.0
