surynek/RR1/rev.2/STLs/Joint-shoulder/J-max_undermotor-cover.stl

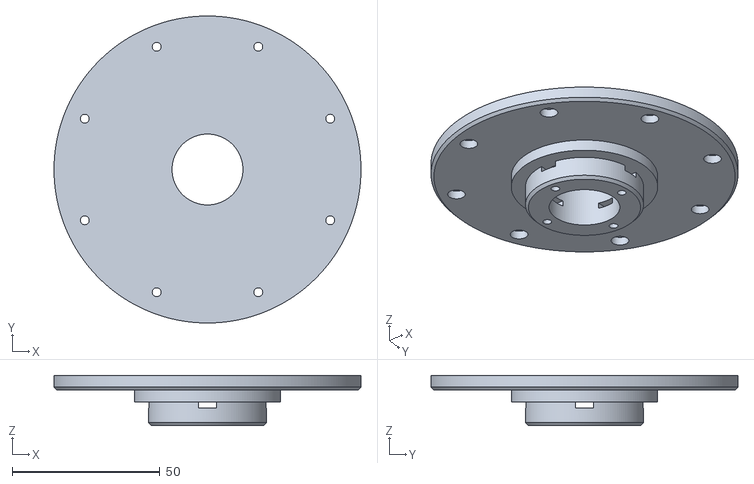
[picture p122: CAD file, 2023-04-27]
rev.2/STLs/Joint-shoulder/J-max_undermotor-cover.stl
104.0 x 104.0 x 17.0
