surynek/RR1/rev.2/STLs/Link-elbow/J-mini_wrist-side-rotator.stl

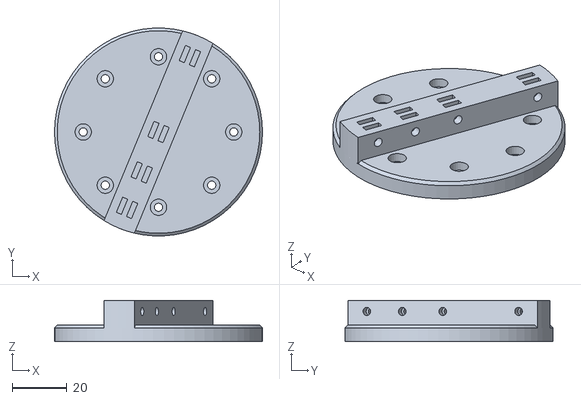
[picture p123: CAD file, 2023-08-21]
rev.2/STLs/Link-elbow/J-mini_wrist-side-rotator.stl
76.0 x 75.9 x 15.0
