surynek/RR1/rev.2/STLs/Wrist/G-mini_encoder-holder-front.stl

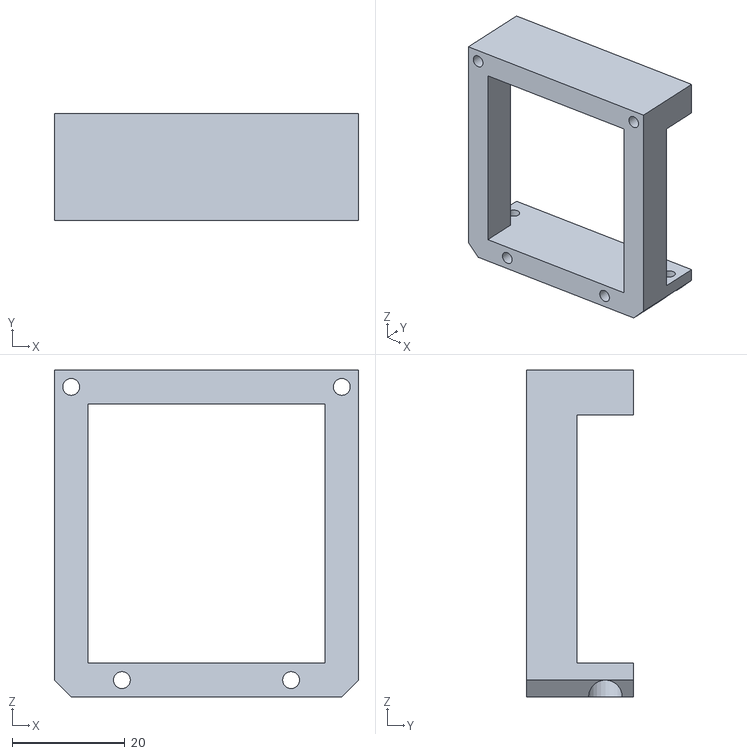
[picture p124: CAD file, 2023-08-21]
rev.2/STLs/Wrist/G-mini_encoder-holder-front.stl
54.0 x 19.0 x 58.0
