surynek/RR1/rev.2/STLs/Joint-shoulder/J-max_monoblock.stl

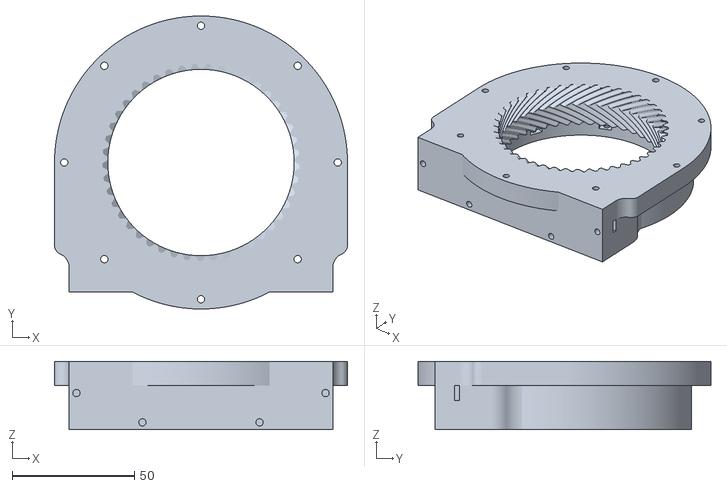
[picture p125: CAD file, 2023-04-27]
rev.2/STLs/Joint-shoulder/J-max_monoblock.stl
120.0 x 120.0 x 28.0
