surynek/RR1/rev.2/STLs/Link-elbow/L-elb_xorior-cover-A.stl

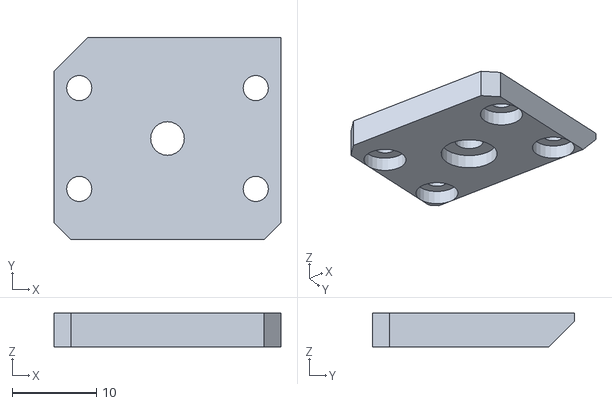
[picture p126: CAD file, 2023-08-21]
rev.2/STLs/Link-elbow/L-elb_xorior-cover-A.stl
27.0 x 24.0 x 4.00
