surynek/RR1/rev.2/STLs/Wrist/Wrist_inner-halo.stl

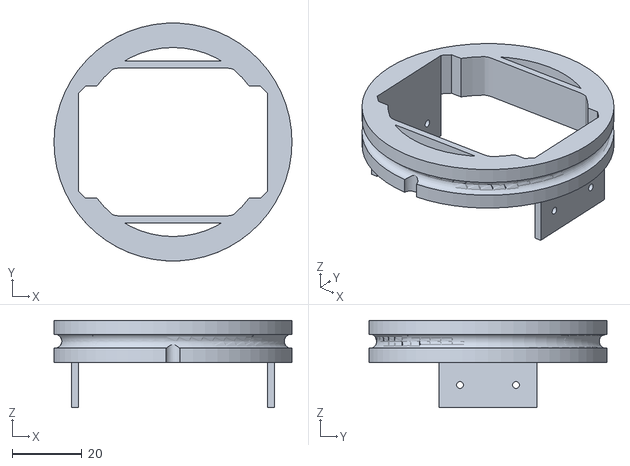
[picture p127: CAD file, 2023-08-21]
rev.2/STLs/Wrist/Wrist_inner-halo.stl
68.0 x 67.9 x 25.0
