surynek/RR1/rev.2/STLs/Joint-elbow/G-midi_actuator-ring-centric.stl

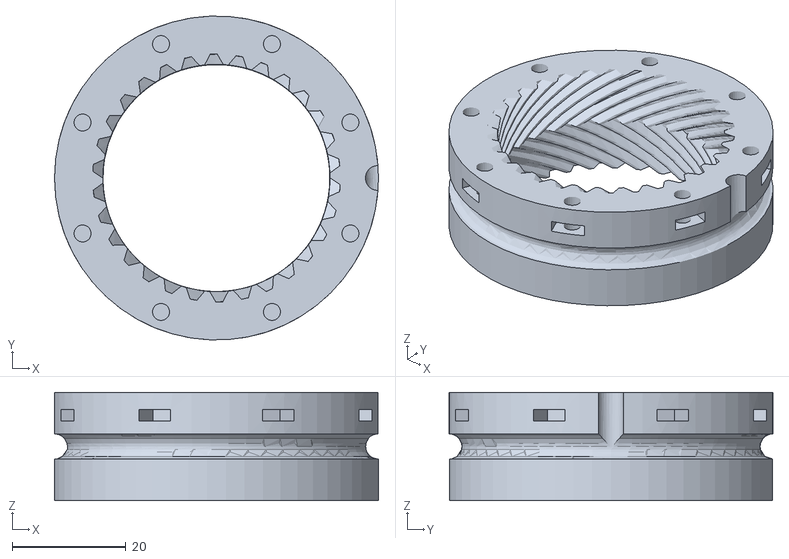
[picture p128: CAD file, 2023-08-21]
rev.2/STLs/Joint-elbow/G-midi_actuator-ring-centric.stl
57.0 x 57.0 x 19.0
