surynek/RR1/rev.2/STLs/Joint-shoulder/J-max_encoder-belt-ring-A.stl

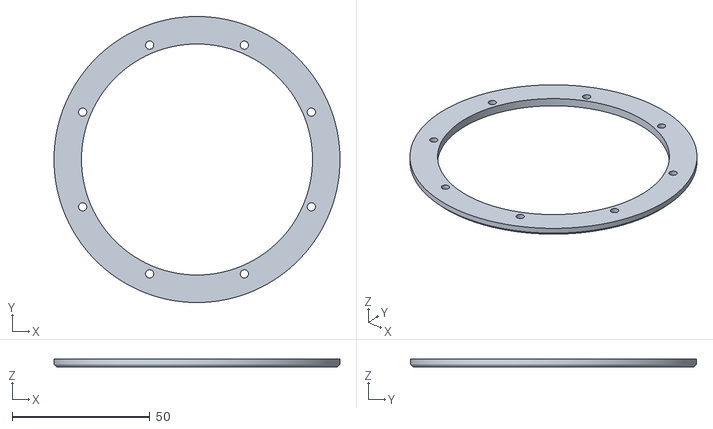
[picture p129: CAD file, 2023-04-27]
rev.2/STLs/Joint-shoulder/J-max_encoder-belt-ring-A.stl
104.0 x 104.0 x 3.00
