surynek/RR1/rev.2/STLs/Joint-elbow/G-midi_inner-gear-part-B-prolonged.stl

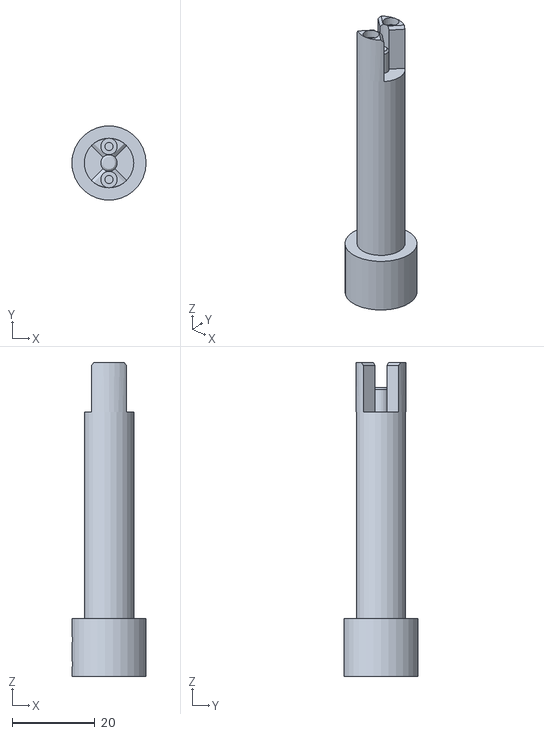
[picture p130: CAD file, 2023-08-21]
rev.2/STLs/Joint-elbow/G-midi_inner-gear-part-B-prolonged.stl
18.0 x 17.9 x 76.0
