surynek/RR1/rev.2/STLs/Joint-shoulder/J-max_encoder-belt-ring-B.stl

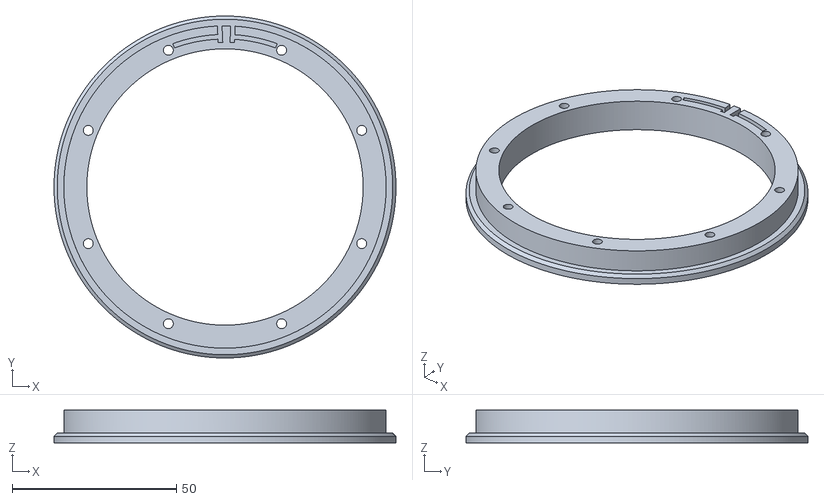
[picture p131: CAD file, 2023-04-27]
rev.2/STLs/Joint-shoulder/J-max_encoder-belt-ring-B.stl
104.0 x 104.0 x 10.0
