surynek/RR1/rev.2/STLs/Link-elbow/J-mini_bearing-ring.stl

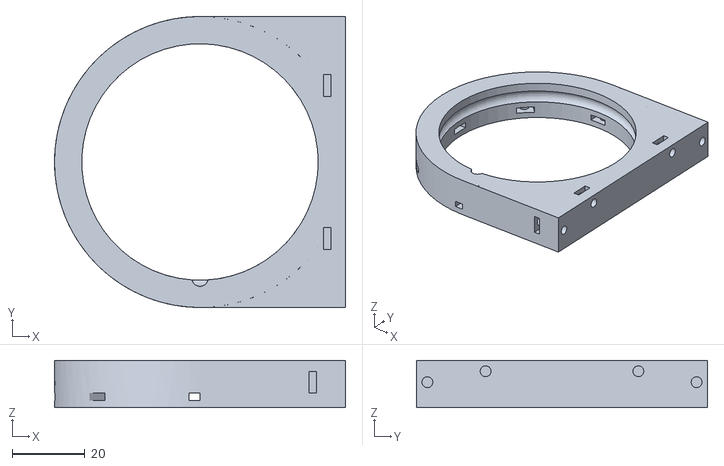
[picture p132: CAD file, 2023-08-21]
rev.2/STLs/Link-elbow/J-mini_bearing-ring.stl
80.0 x 80.0 x 13.0
