surynek/RR1/(list of files, cad)

Other CAD files:
rev.2/STLs/Gripper/Grip_finger-toothed-belt.stl
rev.2/STLs/Joint-shoulder/J-max_motor-shaft.stl
rev.2/STLs/Electric/Ele-box_small-hold.stl
rev.2/STLs/Link-upper/L-upper-max_motor-holder.stl
rev.2/STLs/Base/Base_turret-pulley-fix.stl
rev.2/STLs/Link-elbow/L-elb_moto-hold.stl
rev.2/STLs/Joint-elbow/G-midi_bearing-ring-centric.stl
rev.2/STLs/Wrist/G-mini_inner-gear-shaft.stl
rev.2/STLs/Link-elbow/L-elb_xorior-cover-B.stl
rev.2/STLs/Wrist/G-mini_encoder-bottomhold.stl
rev.1.5/Model/RR1-base.stl
rev.1.5/Model/RR1-extended-base.stl
rev.1.5/Model/RR1-grip-finger-opposite.stl
rev.1.5/Model/RR1-grip-finger.stl
rev.2/STLs/Auxiliaries/T-hold_max.stl
rev.2/STLs/Auxiliaries/T-hold_midi.stl
rev.2/STLs/Auxiliaries/T-hold_mini.stl
rev.2/STLs/Base/Base_encoder-washer.stl
rev.2/STLs/Base/Base_turret-w-hole.stl
rev.2/STLs/Joint-elbow/G-midi_belt-wheel-front.stl
rev.2/STLs/Joint-elbow/G-midi_gearbox-cage-B.stl
rev.2/STLs/Joint-elbow/G-midi_rotator-fix.stl
rev.2/STLs/Joint-elbow/G-midi_super-washer.stl
rev.2/STLs/Joint-elbow/J-midi_RR1-logo.stl
rev.2/STLs/Joint-elbow/J-midi_actuator-ring.stl
rev.2/STLs/Joint-elbow/J-midi_arm-bearing-fix.stl
rev.2/STLs/Joint-elbow/J-midi_bearing-ring.stl
rev.2/STLs/Joint-elbow/J-midi_encoder-belt-ring_A.stl
rev.2/STLs/Joint-elbow/J-midi_encoder-belt-ring_B.stl
rev.2/STLs/Joint-elbow/J-midi_encoder-inhold.stl
rev.2/STLs/Joint-elbow/J-midi_encoder-outhold.stl
rev.2/STLs/Joint-elbow/J-midi_encoder-sidehold.stl
rev.2/STLs/Joint-elbow/J-midi_encoder-washer.stl
rev.2/STLs/Joint-elbow/J-midi_gearbox-cage-A.stl
rev.2/STLs/Joint-elbow/J-midi_gearbox-cage-B.stl
rev.2/STLs/Joint-elbow/J-midi_inner-planet.stl
rev.2/STLs/Joint-elbow/J-midi_monoblock.stl
rev.2/STLs/Joint-elbow/J-midi_motor-washer.stl
rev.2/STLs/Joint-elbow/J-midi_outer-planet.stl
rev.2/STLs/Joint-elbow/J-midi_undermotor-cover.stl
rev.2/STLs/Joint-elbow/J-midi_undermotor-undercover.stl
rev.2/STLs/Joint-shoulder/J-max_actuator.stl
rev.2/STLs/Joint-shoulder/J-max_bearing-fix.stl
rev.2/STLs/Joint-shoulder/J-max_bedding.stl
rev.2/STLs/Joint-shoulder/J-max_cover.stl
rev.2/STLs/Joint-shoulder/J-max_encoder-washer.stl
rev.2/STLs/Joint-shoulder/J-max_gear-base-left.stl
rev.2/STLs/Joint-shoulder/J-max_gear-base-right.stl
rev.2/STLs/Joint-shoulder/J-max_gearbox-cage-A.stl
rev.2/STLs/Joint-shoulder/J-max_motor-washer.stl
rev.2/STLs/Joint-shoulder/J-max_outer-bearing.stl
rev.2/STLs/Joint-shoulder/J-max_outer-planeo.stl
rev.2/STLs/Joint-shoulder/J-max_undermotor-undercover.stl
rev.2/STLs/Link-elbow/J-mini_actuator-ring.stl
rev.2/STLs/Link-elbow/J-mini_encoder-belt-ring_rear.stl
rev.2/STLs/Link-elbow/J-mini_inner-gear_low.stl
rev.2/STLs/Link-elbow/J-mini_monoblock.stl
rev.2/STLs/Link-elbow/L-elb_encoder-sidehold.stl
rev.2/STLs/Link-elbow/L-elb_encoder-washer.stl
rev.2/STLs/Link-elbow/L-elb_major-conno_nomoto_cover.stl
rev.2/STLs/Link-elbow/L-elb_major-moto-cavo-reinforced.stl
rev.2/STLs/Link-elbow/L-elb_moto-shaft.stl
rev.2/STLs/Link-elbow/L-elb_xorior-cover-C.stl
rev.2/STLs/Link-elbow/L-elb_xorior-cover-D.stl
rev.2/STLs/Link-elbow/L-elb_xorior-cover.stl
rev.2/STLs/Link-elbow/L-elb_xorior-washer.stl
rev.2/STLs/Link-elbow/T-mini_bearing-cover.stl
rev.2/STLs/Link-elbow/T-mini_big-gear-lower-shaft.stl
rev.2/STLs/Link-elbow/T-mini_big-gear-shaft-nuovo.stl
rev.2/STLs/Link-elbow/T-mini_big-gear-upper-5.stl
rev.2/STLs/Link-elbow/T-mini_big-gear-upper-8.stl
rev.2/STLs/Link-elbow/T-mini_big-gear-upper-hole-unused.stl
rev.2/STLs/Link-elbow/T-mini_logo.stl
rev.2/STLs/Link-elbow/T-mini_small-box.stl
rev.2/STLs/Link-elbow/T-mini_small-gear-lower-shaft.stl
rev.2/STLs/Link-elbow/T-mini_washer.stl
rev.2/STLs/Link-upper/L-upper-max_arm-rotator-opposite-cover.stl
rev.2/STLs/Link-upper/L-upper-midi_arm-rotator-opposite.stl
rev.2/STLs/Link-upper/L-upper-midi_arm-rotator-undercover.stl
rev.2/STLs/Link-upper/L-upper_arm-rotator-opposite-cover.stl
rev.2/STLs/Link-upper/L-upper_motor-holder.stl
rev.2/STLs/Wrist/G-mini_encoder-washer.stl
rev.2/STLs/Wrist/G-mini_encoder_front-holder.stl
rev.2/STLs/Wrist/G-mini_gearbox-cage-B.stl
rev.2/STLs/Wrist/G-mini_moto-holder-A.stl
rev.2/STLs/Wrist/Wrist_halo-cover.stl
rev.2/STLs/Wrist/Wrist_moto-hold.stl
rev.2/STLs/Wrist/Wrist_outer-halo-encoder.stl
rev.2/STLs/Wrist/Wrist_outer-halo-ring.stl
