surynek/RR1/(commit log)

2022-08-12 New version of RR1.
    [J-max_actuator.stl, J-max_bearing-fix.stl, J-max_bedding.stl, J-max_cover.stl, J-max_gear-base-left.stl, J-max_gear-base-right.stl, J-max_inner-planet.stl, J-max_monoblock.stl]
2023-03-19 Added extended model of the base turret (with electricity extension).
    [RR1-extended-base.stl]
2023-03-22 Added hand model with separate gripper
    [RR1-grip-finger-opposite.stl, RR1-grip-finger.stl]
2023-08-20 Added new .stl files for printing the RR1 rev.2 robotic arm - base joint, shoulder joint, upper arm link, and elbow joint.
    [Base_encoder-bottomhold.stl, Base_encoder-lowhold.stl, Base_encoder-sidehold.stl, Base_encoder-tophold.stl, Base_encoder-uphold.stl, Base_encoder-washer.stl, Base_neck-foreshift.stl, Base_pulley-cover.stl]
